banbatakumi/AutonomousCar/Program/MainF446RE_V3/docs/PROGRESS.md

# PROGRESS

## 2026-08-08: ステアリングストールによる駆動電圧崩壊

### 現象 (Pi側ログより)
mode=DISARM, target_steer=0 を送信中に発生。

| t[s]  | 駆動V | ST電流 | 舵角rad  | 指令rad | フラグ |
|---|---|---|---|---|---|
| 111.0 | 9.60  | +0.00  | -0.3782  | +0.0000 | 正常 |
| 111.9 | 2.80  | +2.83  | -0.3766  | +0.0000 | 電流発生→電圧崩壊 |
| 112.9 | 1.80  | +2.83  | -0.3766  | +0.0000 | 駆動低電圧 |
| 115.0 | 1.60  | +2.83  | -0.3766  | +0.0000 | 駆動低電圧(以降張り付き) |

- 実舵角が指令(0)から約21.6°ずれたまま動かず、ステア電流2.83Aが流れ続ける = ストール。
- `POWER_FAULT_DRIVE_OVERCURRENT` はラッチされず。
- `batt_current_drive` (STM32側バッテリー電流センサ) は終始0.00A。
- 前日の別セッションでは原点ズレが +0.392 rad (+22.4°) で符号が逆だった → 電源投入毎に原点がズレている。

### コード調査結果 (このリポジトリ側)

1. **DISARM中もステアは位置制御され続ける (未実装の穴)**
   [app.c:433-434](../src/app/app.c#L433-L434) `ApplyRasCommand()` は `armed` に関係なく毎周期
   `Steering_SetRoadWheelAngleRad()` を呼ぶ。`Drive` は `Drive_Enable`/`Drive_Disable` で
   明確にON/OFFされる ([app.c:430-431](../src/app/app.c#L430-L431)) のに対し、Steering には
   対応する無効化機構がない。位置モードのMDは目標角へ向けて連続的にトルクを掛け続けるため、
   DISARM中でも中心点(target=0)へ向けて突っ張り続ける。ストール検出・電流タイムアウトも無し。
   → **仕様ではなく未実装。要修正候補。**

2. **駆動電流センサが0Aに張り付く件**
   [power.c:180-183](../src/power/power.c#L180-L183) の `Power_GetCurrentDrive()` は
   ADC1 CURRENT_P (PC1, INA180A2 + R28=5mΩ) 1系統で DRIVE_POWER 配下の3台のMD
   (操舵+左右後輪) の合算電流を読む設計。ステアMDが2.83A流しているなら本来反映されるはず。
   - ハード側 (シャント未実装/配線/ADCチャンネル) の可能性
   - Piログの「駆動電流」がMD自身のテレメトリ (`motor_current_a[0]`) を指しており、
     STM32側センサ値と別物として比較していた可能性
   → 実機でテスターを当てて切り分けが必要。

3. **過電流ラッチ不発は (2) の帰結**
   [power.c:120-124](../src/power/power.c#L120-L124) は `Power_GetCurrentDrive() > 9.0A` を
   50ms継続で判定するが、センサ値が常に0Aなら判定に掛からない。センサが機能していないなら
   駆動系過電流保護は事実上無効。

4. **原点が起動毎に変わる件**
   [steering.c:56-68](../src/control/steering.c#L56-L68) `Steering_Init` は起動時に
   BUTTON1 が押されていればその場の角度をそのまま中心点として保存、押されていなければ
   Flashの保存値を読む仕様 ([app.c:536](../src/app/app.c#L536))。Flash値は明示的に
   再キャリブレーションしない限り変わらないため、毎回符号・大きさが変わるのは
   - 起動毎に意図せずBUTTON1がONでキャリブレーションが走っている
   - モータ〜リンク機構間のカプラがストール反力でスリップしている (今回の現象と整合的)
   のどちらかを疑う。

### 未確認・要現物確認
- ステアリングは手で動くか (機械的に噛んでいないか)
- カプラ/リンク機構のスリップ有無
- CURRENT_P (PC1) 周りのシャント実装・配線
- BUTTON1 (PB14) が起動時に意図せずONになる配線/固着がないか

### 対応候補 (未着手)
- Steering にも Drive 同様の Enable/Disable (非armed時はトルク上限0 or MD解放) を追加
- ステアのストール検出 (角度偏差が一定時間収束しない場合にトルクを下げる/フォールト化)

### 続報: 「なぜ駆動電源が切れるのか」の調査 (同日)

Pi側から「一度もarmしていないのに9.6Vから電圧が落ちた。省電力OFFの類はあるか」との質問。
DRIVE_POWER を操作する箇所を全て洗い出した結果、**タイムアウトによる自動OFFはこのファーム
には存在しない**ことを確認。

- [app.c:571](../src/app/app.c#L571) `Setup()` 末尾で無条件に ON (armの有無に無関係)。
- [app.c:403](../src/app/app.c#L403) `ApplyRasCommand()` で `arm_requested` に従い上書き。
  ただしこれは `RasLink_IsCommandAlive()` が真の間 (Piから100ms間隔でCOMMANDが届き続けて
  いる間) しか呼ばれない ([app.c:498](../src/app/app.c#L498))。
- 他にOFFにする経路は過電流ラッチのみ (今回未発生)。

**「一度もarmしていない」のに9.6Vが観測できたことの整合性**が課題として残る。2通りの
可能性を提示し、Pi側の確認待ち:

1. **COMMANDを一度も送っていなかった場合**: `has_command` が false のまま
   `UpdateDriveTest()` 分岐 ([app.c:504](../src/app/app.c#L504)) が動き続け、DRIVE_POWERは
   `Setup()` のONが保持される。この分岐はBUTTON1起点の下位単独走行テストで、カウントダウン後に
   `Steering_SetAngleRad(&steering, 0.0f)` と `Drive_SetTargetSpeed()` を実際に発行する
   ([app.c:205-207](../src/app/app.c#L205-L207))。ログの「指令rad=0.0000」がPiのCOMMANDでは
   なく**本体BUTTON1起点の走行テストの指令値**だった疑いがある。
2. **COMMANDを継続送信していた場合 (armなし)**: 初回COMMAND到達時点で即座にOFFになるはずで
   9.6V観測と矛盾する。VOLTAGE_P (PC3) がDRIVE_POWERスイッチより手前 (常時通電の生電圧) を
   測っている回路だとすれば、電圧低下は電源OFFではなく「ステアのストールによるバッテリー
   サグ」単体の現象として説明できる。要回路図確認。

Pi側に確認を依頼した項目:
- flags の mode ビット(bit0-1) と `RAS_FLAG_ARMED` (bit2) の実際の値
- BUTTON1 (LED1点灯) が押された形跡の有無
- COMMANDパケットが実際に送信されていたか (Pi側送信ログ)
- VOLTAGE_P (PC3) のタップ位置 (DRIVE_POWERスイッチの前/後)

### 結論 (同日、Pi側ログ解析で決着): バグではなく仕様どおりの挙動

Pi側の送受信ログを解析した結果、原因が確定した。

- COMMAND は 89.7Hz で継続送信されており、`arm` ビットは終始 `0`。100ms超の途絶は0回
  (`RasLink_IsCommandAlive()` は常に真)。
- 初COMMAND受信 (Pi時刻 0.001s) から **+13ms** で駆動電圧の崩壊が始まった。
- STM32は起動から約50秒間、Piが何も送ってこない間 `Setup()` のDRIVE_POWER=ONを保持していた。
  最初のCOMMANDが届いた瞬間、[app.c:403](../src/app/app.c#L403) が
  `Power_SetDrivePower(&power, arm_requested=false)` を実行し、そのままOFFになった。
- VOLTAGE_P (PC3) は **DRIVE_POWERスイッチの後ろ**を測っていると確定 (スイッチが開いた
  瞬間に電圧が落ちているため)。9.6V→1.6Vの「崩壊」はステア電流によるサグではなく、
  スイッチが切れた後のコンデンサ放電波形。

**過去の誤った推測を訂正:**
1. 「駆動バッテリー未接続」→ 誤り。常時接続されていたが、DISARM (arm=0) のCOMMANDで
   DRIVE_POWERがOFFになっていただけ。
2. 「ステアがストール」→ 誤り。ST電流は0.91Aで一定、急増なし。
3. 「電流センサが効いていない」→ 根拠不足。スイッチがOFFなら0.00Aが正しい値。

上記PROGRESSの2/3/4節の「駆動電流センサ異常」「ステアストール」に関する分析は本件の
原因ではなかったとして無効化する。ただし **1節(DISARM中もSteeringが位置制御され続ける
設計上の穴)自体はコード上の事実として引き続き有効**(未検証・未修正のまま)。

**設計上の含意:** Piが接続していてもarmしていない間、DRIVE_POWERは必ずOFFになる
(安全側の正しい挙動)。そのためベンチで駆動電源を上げたまま監視だけしたい場合、
COMMANDを送るとその瞬間に切れる。Pi側で「COMMANDを送らずに受信だけする」ことでのみ
ONを維持できる (ただしその場合 `RAS_FLAG_UART_TIMEOUT` は出ないが `has_command=false`
のままなので上位連携としては未接続扱いになる点に注意)。

**検証実験で確認済み (Pi側):** COMMANDを一切送らず60秒受信のみ→駆動電圧11.00Vが微動
だにせず維持。VOLTAGE_P (PC3) が DRIVE_POWER スイッチの後ろにあることも確定。
MD配線・comm_okも正常(通信断は電源喪失の結果であり原因ではない)。本件は完全に決着。

### 派生した設計論点: フェイルセーフの向きが逆転している

Pi側から指摘。実際のflags推移:

| 状態 | flags |
|---|---|
| Pi沈黙中 (起動直後、COMMAND未着) | ARMED + 駆動電源 ON |
| Pi接続しDISARM送信 | 駆動電源 OFF |

**監視者(Pi)がいないときの方が「動ける」状態になっている。** 原因は
[app.c:571](../src/app/app.c#L571) の `Setup()` 末尾で無条件にDRIVE_POWERをONにする
設計 (BUTTON1単独走行テストをPi無しでも動かすための意図的な設計、CLAUDE.mdにも
明記されている過去の決定)。`UpdateDriveTest()` 自身は `Power_SetDrivePower()` を
一度も呼んでおらず、Setup()のONに乗っかっているだけ ([app.c:179-232](../src/app/app.c#L179-L232)
には呼び出し無し)。

Pi統合が主運用になった今、「監視者不在=動ける」は fail-open であり、一般的な
フェイルセーフの向き (監視者不在・信号無し=安全側) と逆。

**対応 (実施済み):** バンビの判断で、ボタン1単体走行テスト (`UpdateDriveTest` および
関連の `StopTest`/`IsButton1Pressed`/`TestState` 一式) を [app.c](../src/app/app.c) から
削除。あわせて `Setup()` 末尾の `Power_SetDrivePower(&power, 1)` 無条件ONも撤廃し、
以下の挙動に変更した:

- `Setup()` 中はステアリング原点較正 (MDとの通信が必要) のためだけに一時的に
  DRIVE_POWER をONにし、`Steering_Init()`/`Drive_Init()` の直後に明示的にOFFへ戻す。
- 以降は `ApplyRasCommand()` が上位の `RAS_CMD_FLAG_ARM` 要求に従ってON/OFFする経路のみ。
- `UpdateVehicleControl()` の「COMMAND未受信」「COMMAND途絶」の2分岐を
  `ApplyCommandTimeout()` に統合。上位と繋がっていない間は常に目標車速0で停車保持。

結果、Pi未接続時のflagsは `ARMED=False` になり、fail-openは解消。`make` でビルド確認済み
(エラー・警告なし)。CLAUDE.mdの `src/app/app.c の状態` 節も合わせて更新。

---

## 2026-08-08: GUI の LiDAR 点群が左右反転 → Pi 側で修正 (STM32 側は変更なし)

### 原因

STM32 は「センサ基準の角度をそのまま送り、左右の解釈は上位で行う」設計
([lidar.h](../src/sensing/lidar.h) のモジュール解説に経緯あり)。LD06 を裏向き
(PCB面が下) に取り付けているため角度の増加方向が車両座標と逆で、
`sector_idx * 30 + i` をそのまま度として使うと点群が左右反転する。

Pi 側 (`AutonomousCar_RasPi/surge_mk2/raspi/msgs/convert.py` の `ScanAssembler`) が
この反転を実装しておらず、生の添字のまま 360点配列へ詰めていたのが直接原因。

### 対応 (Pi 側で実施済み)

`ScanAssembler` の1箇所だけで `車両角 = (360 - センサ角) % 360` に変換する。

- `sector_t_ns` / `sector_dur_us` / `sector_seen` も車両座標のセクタ番号
  `11 - sector_idx` へ移動 (GUI の欠測セクタ表示が点群とずれないように)
- 反転でセクタ内の時刻の向きが逆になる (`t[j] = t_start + dur * (29 - j) / 29`)
- 回帰テスト追加。Pi 側テスト 259件 OK、GUI の `tsc --noEmit` も通過
- ドキュメント更新: Pi 側 `uart_protocol.md` §5.1 / `stm32_interface.md` §7.1 /
  `types.py` / `gui/src/types.ts` / `PROGRESS.md`

**ワイヤ形式・`protocol_version` (0x0004) は無変更。このリポジトリのコード変更は不要。**
STM32 側で反転しない理由 (0°/180° がセクタ境界に乗って1セクタが分裂する、
実際に試すと原因不明の通信エラーが増発する) は [lidar.h](../src/sensing/lidar.h) のまま有効。

---

## 2026-08-09: プロトコル v0.5 — 灯火/パッシング/クラクション/ブレーキ強さの操作を追加

Pi 側 GUI からクラクション・パッシング・灯火切替 (OFF/DAYTIME/NORMAL) を操作できるようにし、
ブレーキを on/off ではなく N・m で指定できるようにした。詳細と Pi 側の対応チェックリストは
[pi_uart_protocol_v0.5_delta.md](pi_uart_protocol_v0.5_delta.md)。

### 変更点

- **`COMMAND` (0x10) の LEN 10 → 12**、`protocol_version` 0x0004 → 0x0005。
  末尾に `brake_torque : u16` (0.0001 N·m/LSB、0 = 未指定 → 最大制動) を追加。
  `flags` は bit3 の1ビット `light` を bit3-4 の2ビット `light_mode` に拡張し、bit5 に
  `passing` を新設。**Pi 側を更新するまで走行指令は LEN 不一致で全て破棄される** (意図的)。
- **ブレーキが車速PIを迂回するようになった** (`Drive_SetBrake`)。従来は目標車速0を与えるだけで
  制動力がPIゲイン任せだったため、N・m で指定した強さどおりに効かなかった。
- **クラクションが「押している間だけ鳴る」に変更** (連続トーン。従来は立ち上がりで300msの単発)。
- **緊急停止・COMMAND 途絶時の処置を `ApplyFailsafe()` に統合**し、最大制動トルクで止めるように
  した (従来は目標車速0のみ)。併せてクラクションとパッシングを強制解除する。
- **`torque_cmd` の符号規約を明文化**: 正=駆動、負=制動。停車保持中も制動トルクを負値で報告する
  ようになった (従来は0で、押さえているのか無出力なのか区別できなかった)。

### 起動時に駆動電源が一瞬 ON になる問題を修正

`Setup()` が毎回ステアリング原点処理の前後で `DRIVE_POWER` を ON→OFF していた。MD との通信が
要るのは**ボタン1を押しながら起動して較正するときだけ**で、通常起動は Flash から読むだけなので
給電は不要。`if (calibrate_steering)` で囲い、較正しない起動では一度も投入しないようにした。
`TELEMETRY.flags` bit2 (`armed`) が起動直後に一瞬立つこともなくなる。

ビルド確認済み (`make -j12`、エラー・警告なし。text 72204 B)。**実機での動作確認は未実施。**

---

## 2026-08-10: app.c の分割リファクタリング

`src/app/app.c` (585行) に、初期化・メインループ・上位指令の適用・緊急停止・テレメトリ組み立て・
状態表示が全部同居していたので、責務ごとに分割した。**機能の変更は無く、処理内容と実行順序は
そのまま移設しただけ**。

### 新設したモジュール

| 追加先 | 役割 | app.c から移したもの |
|---|---|---|
| `src/vehicle/vehicle.{h,c}` | 車両統括。上位指令・緊急停止・フェイルセーフのどれを適用するかの調停と、指令のレート制限 | `ApplyRasCommand` / `ApplyFailsafe` / `UpdateEstop` / `UpdateVehicleControl` / `SetHorn` / `HeadlightModeFromCommand` / `applied_speed_m_s` / `applied_steer_rad` / `vehicle_mode` / `estop_latched` |
| `src/comm/telemetry.{h,c}` | 各モジュールの観測量を TELEMETRY / STATS / LIDAR_SECTOR のフィールドへ詰め替える | `PublishTelemetry` / `BuildTelemetryFlags` / `BuildMdStatus` / `AccumAngleToOdom` / `PublishLidarSector` / `MdCommWatch` 一式 / `MotorByIndex` |
| `src/hmi/indicator.{h,c}` | 機体状態の表示 (電圧の呼吸 LED、フォールト・緊急停止のハザード) | `BreathLed` 一式 / `UpdatePowerIndication` / `UpdateFaultIndication` |

### 残した app.c の役割

コンポジションルート (全インスタンスの所有・初期化順序・メインループの呼び出し順・HAL 割り込み
コールバックの振り分け) だけ。585行 → 244行。

- グローバルだったインスタンスを全て `static` にした (他モジュールへは `*_Init()` でポインタを渡す)。
- `app.h` が 20 個のヘッダを include して `Core/Src/main.c` まで引きずっていたのをやめ、
  `Setup()` / `MainApp()` の宣言だけにした。
- 起動演出 (ハザード2回点滅) を `PlayStartupIndication()`、センサ更新群を `UpdateSensors()` に括り出し。

### 依存の向き

`app → vehicle / hmi / comm → control / sensing / power / lighting → lib` の一方向。
テレメトリは車両状態 (mode / estop / 指令舵角) を `Vehicle_Get*()` 経由で読み、Indicator へは
app.c が `Vehicle_IsEstopLatched()` の結果を引数で渡すことで循環依存を避けている。

### その他

- 空ディレクトリ `src/sound/` を削除 (`-Isrc/sound` が付くだけの残骸だった)。

ビルド確認済み (`make clean && make -j12`、エラー・警告なし。text 72500 B)。**実機での動作確認は未実施。**

---

## 2026-08-11: プロトコル v0.6 — 駆動トルクの直接指令 (`torque_mode`) を追加

Pi 側 (`stm32_interface.md` v0.5 / `uart_protocol.md` v0.6) の要求に合わせ、後輪へ駆動トルクを
直接指令できるモードを追加した。詳細と Pi 側の対応チェックリストは
[pi_uart_protocol_v0.6_delta.md](pi_uart_protocol_v0.6_delta.md)。

### 変更点

- **`COMMAND` (0x10) の LEN 12 → 14**、`protocol_version` 0x0005 → 0x0006。
  末尾に `target_torque : i16` (0.0001 N·m/LSB、負=後退方向) を追加。`flags` bit6 に
  `torque_mode` を新設。**Pi 側を更新するまで走行指令は LEN 不一致で全て破棄される** (意図的)。
- **`torque_mode` 中は `Drive` が車速 PI を迂回し、`target_torque` を左右等配分の総駆動トルクとして
  直接使う** ([drive.c](../src/control/drive.c) `Drive_SetTorque` / `Drive_Update`)。
  `brake` と同じ構造で `PID_Reset` を毎周期呼び、離脱時に積分の持ち越しが起きないようにした。
- **TC/TV は `torque_mode` 中も掛けたままにした** (`uart_protocol.md` §14 #8 で「未確定」とされていた
  論点への回答)。通常駆動時と同じ TC リミッタ・TV のヨーモーメント項の計算経路をそのまま通し、
  車速 PI の出力の代わりに `target_torque * 2` を「要求総トルク」として渡すだけにしている。
  空転を招くおそれのある「TC を素通りさせる」実装は避けた。
- **`brake` と `torque_mode` が同時に立っていたら `brake` を優先**する。`Drive_Update` 側で
  `brake_active` を先に判定する既存の優先順位にそのまま乗せているだけで、`Vehicle` 側では
  両フラグを毎周期そのまま `Drive_SetBrake` / `Drive_SetTorque` へ渡している (どちらが勝つかは
  常に `Drive_Update` の1箇所だけで決まる)。
- **`target_torque` は ±`DRIVE_MAX_TORQUE_NM` (0.1 N·m) でこちら側でもクランプする**
  (`Drive_SetTorque` 内)。Pi 側のクランプに頼らない。

ビルド確認済み (`make -j12`、エラー・警告なし。text 74832 B)。**実機での動作確認は未実施。**

---

## 2026-08-19: プロトコル v0.8 — TC/TV の実行時 ON/OFF を追加

バンビの依頼「ラズパイ側からTCとTVのオンオフを制御したい」に対応。詳細と Pi 側の対応
チェックリストは [pi_uart_protocol_v0.8_delta.md](pi_uart_protocol_v0.8_delta.md)。

### 方式の選定

`COMMAND.flags` は v0.7 の `auto_stop` (bit7) 追加で u8 の全ビットが埋まっており、新しい
フラグを置く空きが無い。一方 `RasParamId` (`ras_link.h`) には TC/TV 用の `param_id`
(`0x0010`/`0x0020`) が「未実装」として既に予約されていたため、`COMMAND` の LEN 拡張は
避けて既存の `CONFIG_SET`/`CONFIG_GET`/`CONFIG_ACK` (0x20/0x21/0x22) 経由で実装した。

### 変更点

- **`RasParamId` に `RAS_PARAM_TC_ENABLE = 0x0010` / `RAS_PARAM_TV_ENABLE = 0x0020` を追加**
  ([ras_link.h](../src/comm/ras_link.h))。`RasConfig` に `tc_enabled`/`tv_enabled` (既定 true)
  を追加し、`ApplyConfig()`/`ReadConfig()` ([ras_link.c](../src/comm/ras_link.c)) で
  0.0/非0 を真偽値として読み書きする。`protocol_version` 0x0007 → 0x0008。
- **TV は元々 `TorqueVectoring_SetEnabled()`/`Drive_SetTorqueVectoringEnabled()` が実装済み
  だったが呼び出し元がどこにも無く、実質常時有効固定だった** (未配線)。今回
  `Vehicle::ApplyRasCommand()` ([vehicle.c](../src/vehicle/vehicle.c)) から配線した。
- **TC には有効/無効の切替口が無かったため新規追加**: `Drive` に `tc_enabled` (既定 true) を
  持たせ、`Drive_Update()` の TC 上限更新箇所を分岐し、無効時は `tc_limit_left/right_nm` を
  常に `DRIVE_MAX_TORQUE_NM` に固定してスリップ率による削り込みをしないようにした
  ([drive.h](../src/control/drive.h)/[drive.c](../src/control/drive.c) の
  `Drive_SetTractionControlEnabled()`)。
- `Vehicle::ApplyRasCommand()` が毎周期 `RasConfig.tc_enabled`/`tv_enabled` を
  `Drive_SetTractionControlEnabled()`/`Drive_SetTorqueVectoringEnabled()` へそのまま渡す。
  COMMAND 未受信時 (`ApplyFailsafe()`) は呼ばないため、Pi 未接続時は起動時の既定値 (両方有効)
  のまま固定される。

ビルド確認済み (`make -j12`、エラー・警告なし。text 75656 B)。**実機での動作確認は未実施。**
