banbatakumi/AutonomousCar/Program/MainF446RE_V3/docs/archive/pi_uart_protocol_v0.15_delta.md

# SURGE Mark.2 UART プロトコル — v0.14 → v0.15 差分

**発信**: STM32F446RE 車両制御基板 (MainF446RE_V3) 開発側
**宛先**: Raspberry Pi 5 側 開発担当
**日付**: 2026-09-27
**状態**: STM32 側 実装済み・ビルド確認済み。**Pi 側の対応が必要 (実機での動作検証は未了)**

v0.14 (`pi_uart_protocol_v0.14_delta.md`) からの差分のみを記す。変わったのは `CONFIG_SET`/
`CONFIG_GET` の `param_id` 追加と `TELEMETRY` (0x02) の `flags` の空きビットのみ。**ワイヤ形式・
LEN の変更は無い**。

---

## 0. 要約

制動時の後輪ロックを防ぐ ABS を追加した。`COMMAND.flags` の `brake` (上位のブレーキ・自動停止)
と、STM32 側のフェイルセーフ (`COMMAND` 途絶・緊急停止) の最大制動のすべてに掛かる。
車速PIによる減速・`torque_mode` の負トルクには掛からない。

- 前輪 (非駆動・非制動) から求めた基準車速に対し、後輪のスリップ率が -0.2 より負になったら
  そのときの制動トルクを覚えて0.7倍へ下げ (25ms 戻らなければもう一段)、スリップが -0.1 より
  浅く戻ったら覚えたトルクの0.9倍へすぐ戻し、そこから 0.2 Nm/s でゆっくり上げる
  (2026-09-27 の実機試験を受けて改訂。初版は削りすぎて減速が弱かった。ワイヤ形式は同じ)。
- 左右は select-low (ロックしかけている側に合わせて左右同じ制動トルク)。左右で路面μが違っても
  ヨーモーメントを出さないため。
- 車速 0.25 m/s 未満では働かない (スリップ率が定義できないため)。
- **フォールバック**: 制動トルクを要求の20%以下に削った状態が 0.1 s 続いたら (最大制動からだと約0.2 s)、前輪側の
  センサ異常とみなし、ブレーキを離すまで ABS を止めて要求どおりに制動する。

**`protocol_version` は `0x000E` → `0x000F` に上がる。`COMMAND`・`TELEMETRY` とも LEN は
変わらない。**

---

## 1. `CONFIG_SET` / `CONFIG_GET` — `param_id = 0x0070` (ABS_ENABLE) 追加

| param_id | 名前 | 値 | 既定 |
|---|---|---|---|
| `0x0070` | `ABS_ENABLE` | 0.0 = 無効、非0 = 有効 (適用値は 0.0/1.0 で返る) | 有効 |

- TC (`0x0010`)・片輪浮き対策 (`0x0050`) と同じ扱い。無効にすると、指定した制動トルクを
  そのまま掛ける (v0.14 までの挙動)。
- 制動中に無効→有効へ切り替えると、ABS の内部状態 (フォールバックも含む) は初期化される。

## 2. `TELEMETRY` (0x02) — `flags` (bit20) 追加

| bit | 内容 |
|---|---|
| 19 | `WINKER_RIGHT_ACTIVE` (既存, v0.14) |
| 20 | `ABS_ACTIVE` (新設) |

- ABS が制動トルクを要求より削っている最中かどうか。フォールバック中は偽。
- 実際に掛けている制動トルクは既存の `torque_cmd[2]` (制動は負値)、スリップ率は既存の
  `slip[2]` に出るので、チューニングにはこの2つとこのビットを使う。

---

## 3. Pi 側の対応チェックリスト

- [ ] `protocol_version` の期待値を `0x000E` → `0x000F` にする
- [ ] (任意) `CONFIG_SET` の `param_id = 0x0070` で ABS の ON/OFF を切り替えられるようにする
- [ ] `TELEMETRY.flags` の bit20 (`ABS_ACTIVE`) をデコードしてログ・UI に出す
- [ ] **実機での動作検証は STM32 側でも未実施。** しきい値・ゲイン・フォールバック時間は
      すべて机上値なので、滑りやすい路面で ON/OFF を比較しながら詰める想定
