banbatakumi/AutonomousCar/Circuit/MainBoard_V3_2/MainBoardPCB.dxf

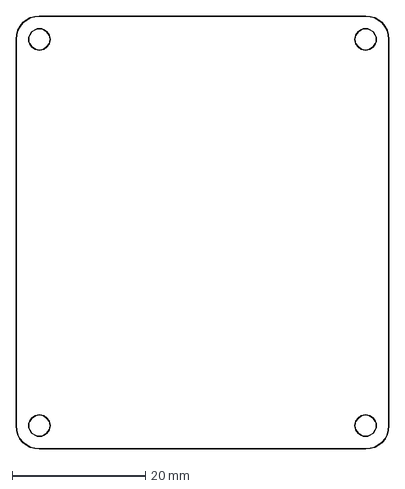
[picture p1: CAD file, 2026-05-05]
Circuit/MainBoard_V3_2/MainBoardPCB.dxf
56.0 x 65.0 mm
