banbatakumi/AutonomousCar/Circuit/MainBoard_V3_2/OKL-T_6-W12N-C.step

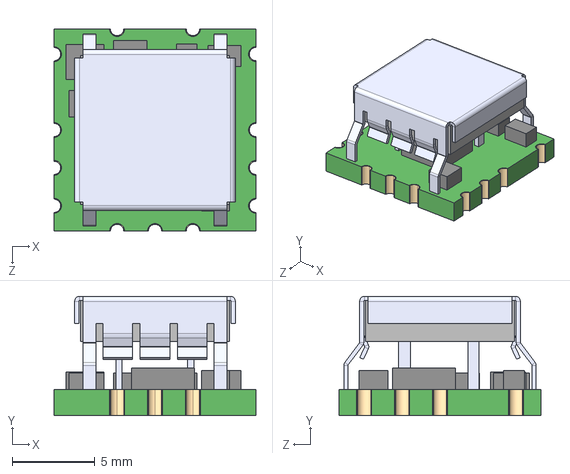
[picture p2: CAD file, 2026-05-05]
Circuit/MainBoard_V3_2/OKL-T_6-W12N-C.step
12.2 x 7.20 x 12.2 mm
