banbatakumi/AutonomousCar/Circuit/MainBoard_V3_2/MainBoard_V3_2.kicad_pcb

## KiCad design Circuit/MainBoard_V3_2/MainBoard_V3_2.kicad_pcb (2026-07-30)

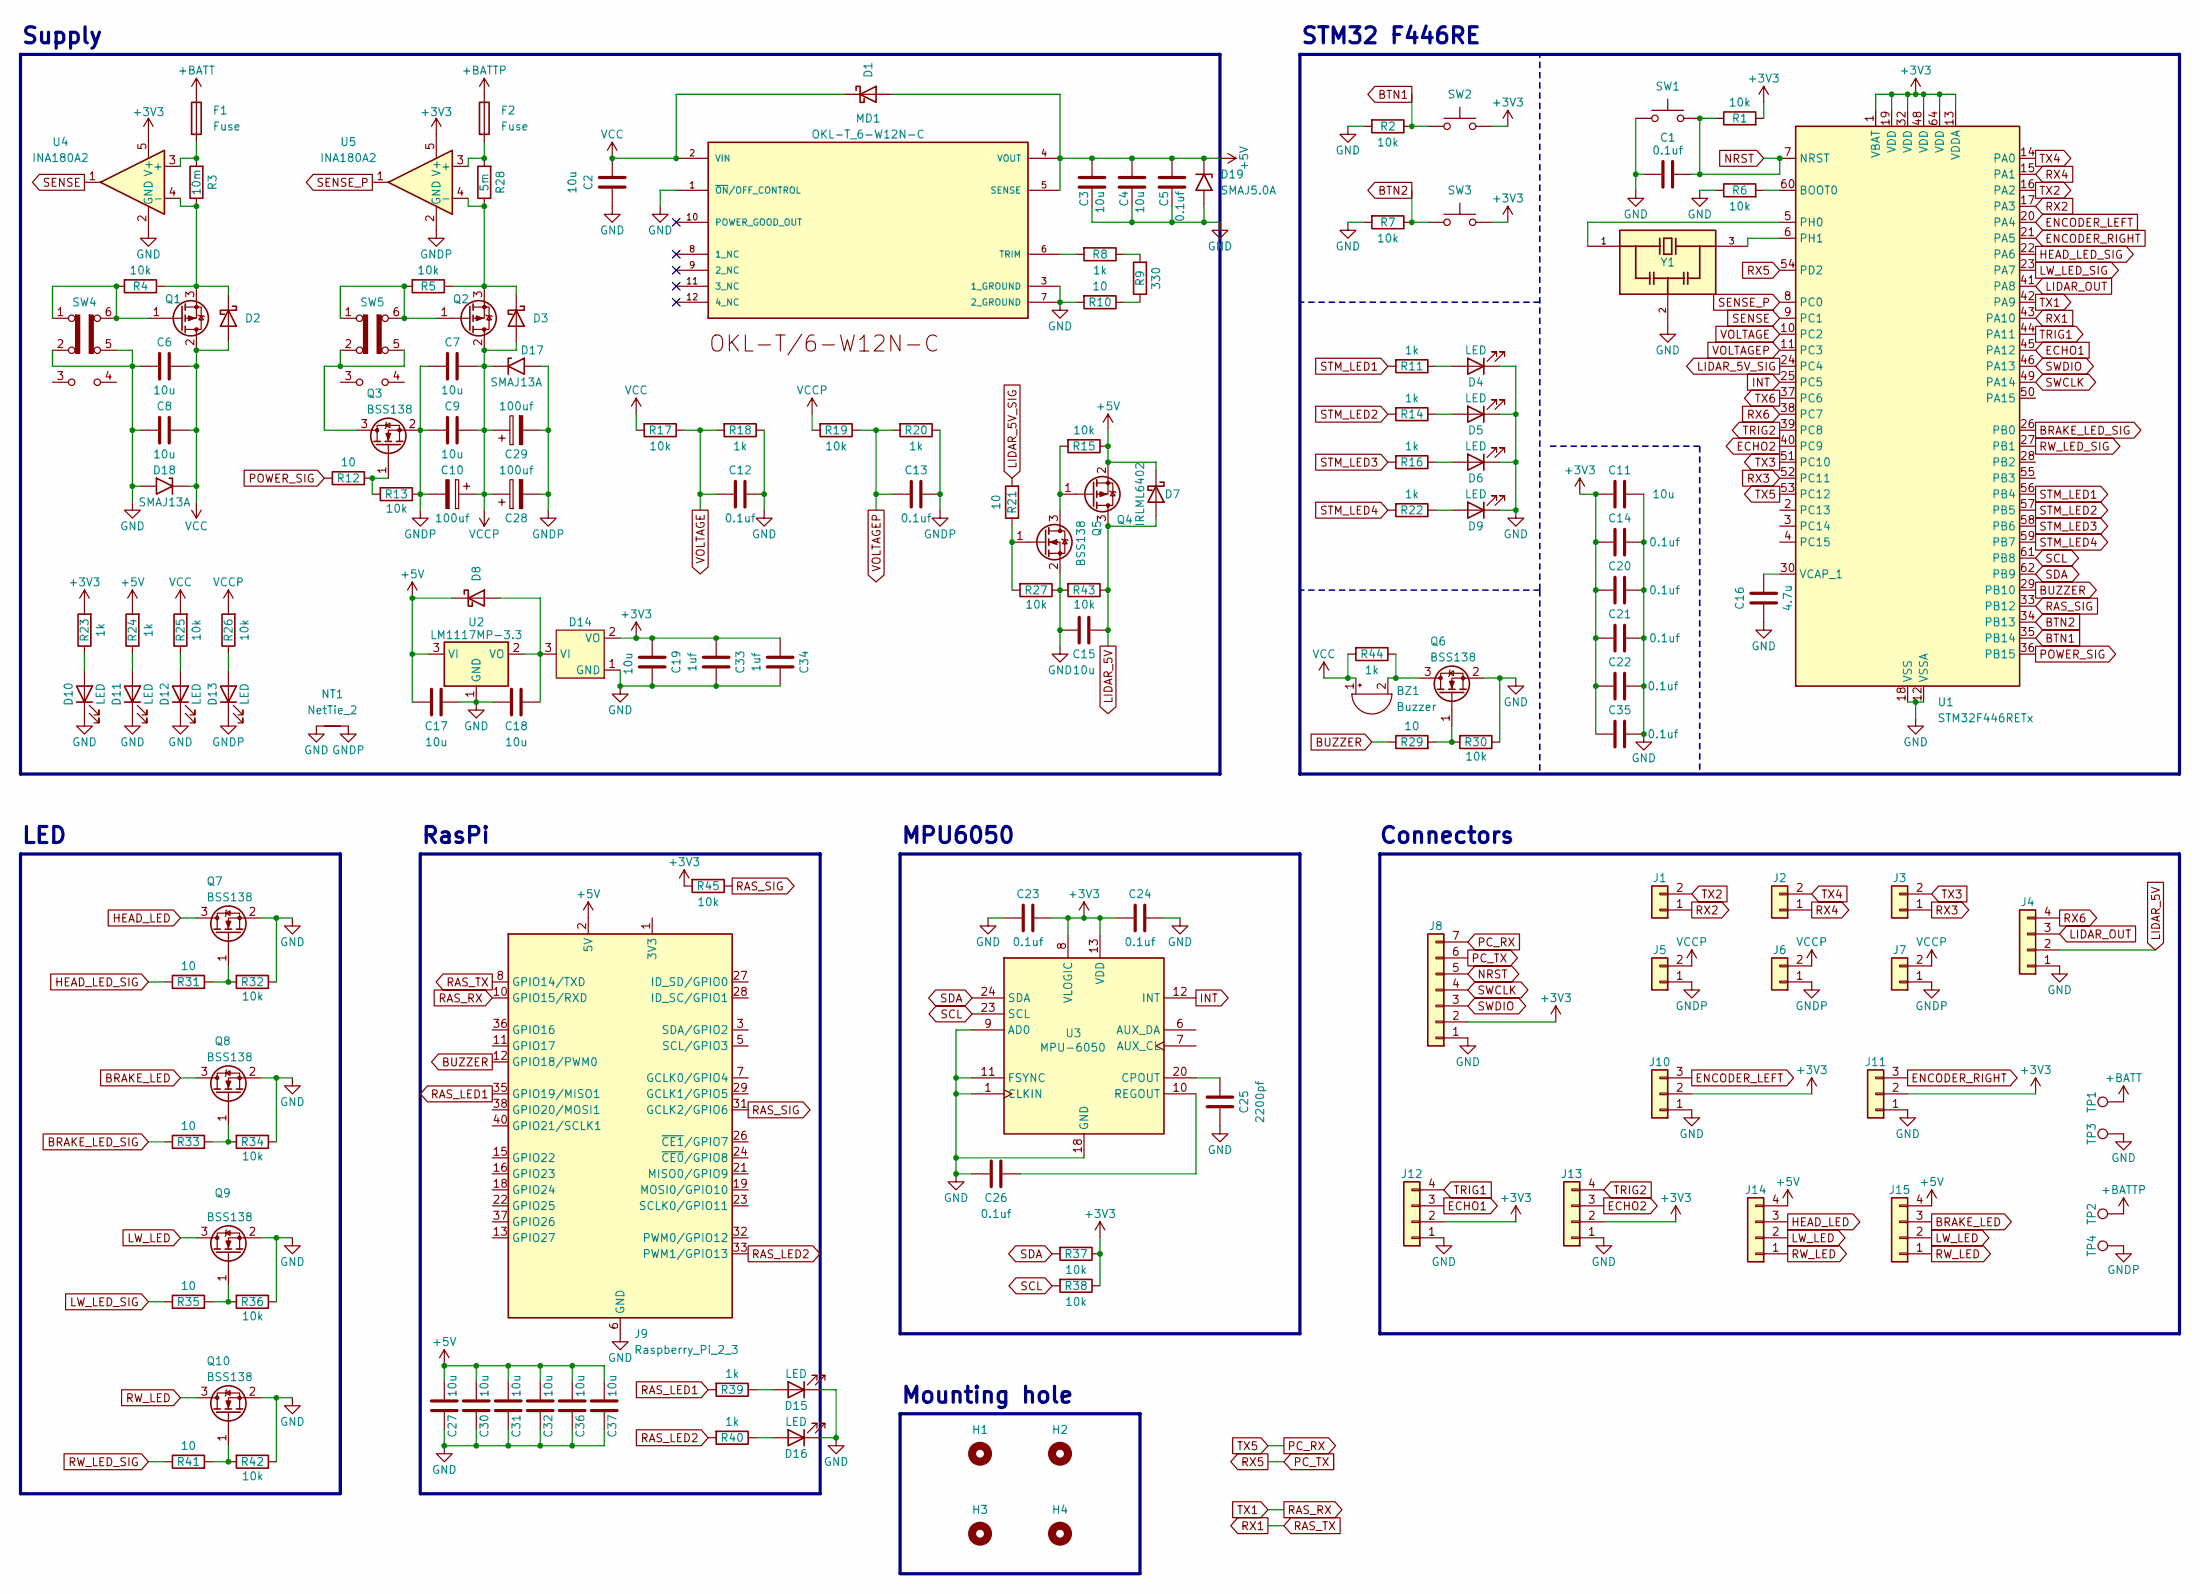
[picture p3: schematic MainBoard_V3_2.kicad_sch]

Parts:
BZ1: Buzzer; Buzzer_Murata_PKLCS1212E
C1, C5, C12, C13, C14, C20, C21, C22, C23, C24, C26, C35: 0.1uf; C_0603_1608Metric
C2, C3, C4, C6, C7, C8, C9, C11, C15, C17, C18, C19, C27, C30, C31, C32, C36, C37: 10u; C_0805_2012Metric
C10, C28, C29: 100uf; CP_Radial_D6.3mm_P2.50mm
C16: 4.7u; C_0805_2012Metric
C25: 2200pf; C_0603_1608Metric
C33, C34: 1uf; C_0603_1608Metric
D1, D2, D3, D7, D8: D_Schottky; D_SOD-323_HandSoldering
D4, D5, D6, D9, D10, D11, D12, D13, D15, D16: LED; LED_0603_1608Metric
D14: CH213K; TSOT-23
D17, D18: SMAJ13A; D_SMA
D19: SMAJ5.0A; D_SMA
F1, F2: Fuse; Fuseholder_Clip-5x20mm_Keystone_3517_Inline_P23.11x6.76mm_D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
H1, H2, H3, H4: MountingHole; MountingHole_3.2mm_M3_Pad_Via
J1, J2, J3: Conn_01x02; JST_PH_S2B-PH-K_1x02_P2.00mm_Horizontal
J4, J12, J13: Conn_01x04; JST_XH_S4B-XH-A_1x04_P2.50mm_Horizontal
J5, J6, J7: Conn_01x02; Molex_SPOX_5268-02A_1x02_P2.50mm_Horizontal
J8: Conn_01x07; JST_PH_S7B-PH-K_1x07_P2.00mm_Horizontal
J9: Raspberry_Pi_2_3; raspberreyPi
J10, J11: Conn_01x03; JST_PH_S3B-PH-K_1x03_P2.00mm_Horizontal
J14, J15: Conn_01x04; JST_PH_S4B-PH-K_1x04_P2.00mm_Horizontal
MD1: OKL-T_6-W12N-C; MURATA_OKL-T-6-W12N-C_0; MOUSER_PART_NUMBER 580-OKL-T/6-W12N-C; MOUSER_DESCRIPTION Non-Isolated DC/DC Converters 12Vin .59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
NT1: NetTie_2; NetTie-2_SMD_Pad0.5mm
Q1, Q2: Q_PMOS_GDS; TO-252-2
Q3, Q5, Q6, Q7, Q8, Q9, Q10: BSS138; SOT-23
Q4: IRLML6402; SOT-23
R1, R2, R4, R5, R6, R7, R13, R15, R17, R19, R25, R26, R27, R30, R32, R34, R36, R37, R38, R42, R43, R45: 10k; R_0603_1608Metric
R3: 10m; R_1206_3216Metric
R8, R11, R14, R16, R18, R20, R22, R23, R24, R39, R40, R44: 1k; R_0603_1608Metric
R9: 330; R_0603_1608Metric
R10, R12, R21, R29, R31, R33, R35, R41: 10; R_0603_1608Metric
R28: 5m; R_1206_3216Metric
SW1, SW2, SW3: SW_Push; SW_SPST_PTS810
SW4, SW5: SW_Slide_DPDT; IS-2235
TP1, TP2, TP3, TP4: TestPoint; TestPoint_THTPad_D4.0mm_Drill2.0mm
U1: STM32F446RETx; LQFP-64_10x10mm_P0.5mm
U2: LM1117MP-3.3; SOT-223-3_TabPin2
U3: MPU-6050; QFN-24-1EP_4x4mm_P0.5mm_EP2.15x2.15mm
U4, U5: INA180A2; SOT-23-5
Y1: CSTNE16M0V530000R0; Resonator_SMD_Murata_CSTxExxV-3Pin_3.0x1.1mm; PARTREV JGC42-8853B

Connections:
+3V3: C11.1, C14.2, C19.2, C20.2, C21.2, C22.2, C23.1, C24.2, C33.2, C34.2, C35.2, D14.2 (VO), J8.2, J10.2, J11.2, J12.2, J13.2, R1.2, R23.2, R37.1, R38.1, R45.2, SW2.2, SW3.2, U1.1 (VBAT), U1.13 (VDDA), U1.19 (VDD), U1.32 (VDD), U1.48 (VDD), U1.64 (VDD), U3.8 (VLOGIC), U3.13 (VDD), U4.5 (V+), U5.5 (V+)
+5V: C3.1, C4.1, C5.1, C17.2, C27.1, C30.1, C31.1, C32.1, C36.1, C37.1, D1.2 (A), D7.1 (K), D8.1 (K), D19.1 (A1), J9.2 (5V), J9.4 (5V), J14.4, J15.4, MD1.4 (VOUT), MD1.5 (SENSE), Q4.2 (S), R15.1, R24.2, U2.3 (VI)
+BATT: F1.1, TP1.1
+BATTP: F2.1, TP2.1
BRAKE_LED: J15.3, Q8.3 (D)
BRAKE_LED_SIG: R33.1, U1.26 (PB0)
BTN1: R2.1, SW2.1, U1.35 (PB14)
BTN2: R7.1, SW3.1, U1.34 (PB13)
BUZZER: J9.12 (GPIO18/PWM0), R29.1, U1.29 (PB10)
ECHO1: J12.3, U1.45 (PA12)
ECHO2: J13.3, U1.40 (PC9)
ENCODER_LEFT: J10.3, U1.20 (PA4)
ENCODER_RIGHT: J11.3, U1.21 (PA5)
GND: C1.1, C2.1, C3.2, C4.2, C5.2, C6.2, C8.2, C11.2, C12.1, C14.1, C15.2, C16.2, C17.1, C18.2, C19.1, C20.1, C21.1, C22.1, C23.2, C24.1, C25.2, C26.2, C27.2, C30.2, C31.2, C32.2, C33.1, C34.1, C35.1, C36.2, C37.2, D4.1 (K), D5.1 (K), D6.1 (K), D9.1 (K), D10.1 (K), D11.1 (K), D12.1 (K), D14.1 (GND), D15.1 (K), D16.1 (K), D18.2 (A2), D19.2 (A2), J4.1, J8.1, J9.6 (GND), J9.9 (GND), J9.14 (GND), J9.20 (GND), J9.25 (GND), J9.30 (GND), J9.34 (GND), J9.39 (GND), J10.1, J11.1, J12.1, J13.1, MD1.1 (~ON/OFF_CONTROL), MD1.3 (1_GROUND), MD1.7 (2_GROUND), NT1.1, Q5.2 (S), Q6.2 (S), Q7.2 (S), Q8.2 (S), Q9.2 (S), Q10.2 (S), R2.2, R6.1, R7.2, R10.2, R18.1, R27.1, R30.1, R32.1, R34.1, R36.1, R42.1, R43.2, SW1.1, SW4.2 (B), SW4.5 (B), TP3.1, U1.12 (VSSA), U1.18 (VSS), U1.31 (VSS), U1.47 (VSS), U1.63 (VSS), U2.1 (GND), U3.1 (CLKIN), U3.9 (AD0), U3.11 (FSYNC), U3.18 (GND), U4.2 (GND), Y1.2
GNDP: C7.1, C9.1, C10.2, C13.1, C28.2, C29.2, D13.1 (K), D17.2 (A2), J5.1, J6.1, J7.1, NT1.2, Q3.2 (S), R13.1, R20.1, TP4.1, U5.2 (GND)
HEAD_LED: J14.3, Q7.3 (D)
HEAD_LED_SIG: R31.1, U1.22 (PA6)
INT: U1.25 (PC5), U3.12 (INT)
LIDAR_5V: C15.1, D7.2 (A), J4.2, Q4.3 (D), R43.1
LIDAR_5V_SIG: R21.2, U1.24 (PC4)
LIDAR_OUT: J4.3, U1.41 (PA8)
LW_LED: J14.2, J15.2, Q9.3 (D)
LW_LED_SIG: R35.1, U1.23 (PA7)
NRST: C1.2, J8.5, R1.1, SW1.2, U1.7 (NRST)
unnamed: BZ1.2 (-), Q6.3 (D), R44.1
unnamed: D2.1 (K), Q1.3 (S), R3.1, R4.1, U4.4 (-)
unnamed: D3.1 (K), Q2.3 (S), R5.1, R28.1, U5.4 (-)
unnamed: D4.2 (A), R11.1
unnamed: D5.2 (A), R14.1
unnamed: D6.2 (A), R16.1
unnamed: D9.2 (A), R22.1
unnamed: D10.2 (A), R23.1
unnamed: D11.2 (A), R24.1
unnamed: D12.2 (A), R25.1
unnamed: D13.2 (A), R26.1
unnamed: C18.1, D8.2 (A), D14.3 (VI), U2.2 (VO)
unnamed: D15.2 (A), R39.1
unnamed: D16.2 (A), R40.1
unnamed: J9.1 (3V3), J9.17 (3V3)
unnamed: MD1.6 (TRIM), R8.2
unnamed: Q1.1 (G), R4.2, SW4.1 (A), SW4.6 (C)
unnamed: Q2.1 (G), R5.2, SW5.1 (A), SW5.6 (C)
unnamed: Q3.3 (D), SW5.2 (B), SW5.5 (B)
unnamed: Q3.1 (G), R12.2, R13.2
unnamed: Q4.1 (G), Q5.3 (D), R15.2
unnamed: Q5.1 (G), R21.1, R27.2
unnamed: Q6.1 (G), R29.2, R30.2
unnamed: Q7.1 (G), R31.2, R32.2
unnamed: Q8.1 (G), R33.2, R34.2
unnamed: Q9.1 (G), R35.2, R36.2
unnamed: Q10.1 (G), R41.2, R42.2
unnamed: R8.1, R9.2
unnamed: R9.1, R10.1
unnamed: R6.2, U1.60 (BOOT0)
unnamed: U1.5 (PH0), Y1.1
unnamed: U1.6 (PH1), Y1.3
unnamed: C16.1, U1.30 (VCAP_1)
unnamed: C25.1, U3.20 (CPOUT)
unnamed: C26.1, U3.10 (REGOUT)
unnamed: F1.2, R3.2, U4.3 (+)
unnamed: F2.2, R28.2, U5.3 (+)
PC_RX: J8.7, U1.53 (PC12)
PC_TX: J8.6, U1.54 (PD2)
POWER_SIG: R12.1, U1.36 (PB15)
RAS_LED1: J9.35 (GPIO19/MISO1), R39.2
RAS_LED2: J9.33 (PWM1/GPIO13), R40.2
RAS_RX: J9.10 (GPIO15/RXD), U1.42 (PA9)
RAS_SIG: J9.31 (GCLK2/GPIO6), R45.1, U1.33 (PB12)
RAS_TX: J9.8 (GPIO14/TXD), U1.43 (PA10)
RW_LED: J14.1, J15.1, Q10.3 (D)
RW_LED_SIG: R41.1, U1.27 (PB1)
RX2: J1.1, U1.17 (PA3)
RX3: J3.1, U1.52 (PC11)
RX4: J2.1, U1.15 (PA1)
RX6: J4.4, U1.38 (PC7)
SCL: R38.2, U1.61 (PB8), U3.23 (SCL)
SDA: R37.2, U1.62 (PB9), U3.24 (SDA)
SENSE: U1.9 (PC1), U4.1
SENSE_P: U1.8 (PC0), U5.1
STM_LED1: R11.2, U1.56 (PB4)
STM_LED2: R14.2, U1.57 (PB5)
STM_LED3: R16.2, U1.58 (PB6)
STM_LED4: R22.2, U1.59 (PB7)
SWCLK: J8.4, U1.49 (PA14)
SWDIO: J8.3, U1.46 (PA13)
TRIG1: J12.4, U1.44 (PA11)
TRIG2: J13.4, U1.39 (PC8)
TX2: J1.2, U1.16 (PA2)
TX3: J3.2, U1.51 (PC10)
TX4: J2.2, U1.14 (PA0)
TX6: U1.37 (PC6)
VCC: BZ1.1 (+), C2.2, C6.1, C8.1, D1.1 (K), D2.2 (A), D18.1 (A1), MD1.2 (VIN), Q1.2 (D), R17.2, R25.2, R44.2
VCCP: C7.2, C9.2, C10.1, C28.1, C29.1, D3.2 (A), D17.1 (A1), J5.2, J6.2, J7.2, Q2.2 (D), R19.2, R26.2
VOLTAGE: C12.2, R17.1, R18.2, U1.10 (PC2)
VOLTAGEP: C13.2, R19.1, R20.2, U1.11 (PC3)

Notes on the sheet:
Mounting hole
LED
Supply
MPU6050
RasPi
Connectors
STM32 F446RE

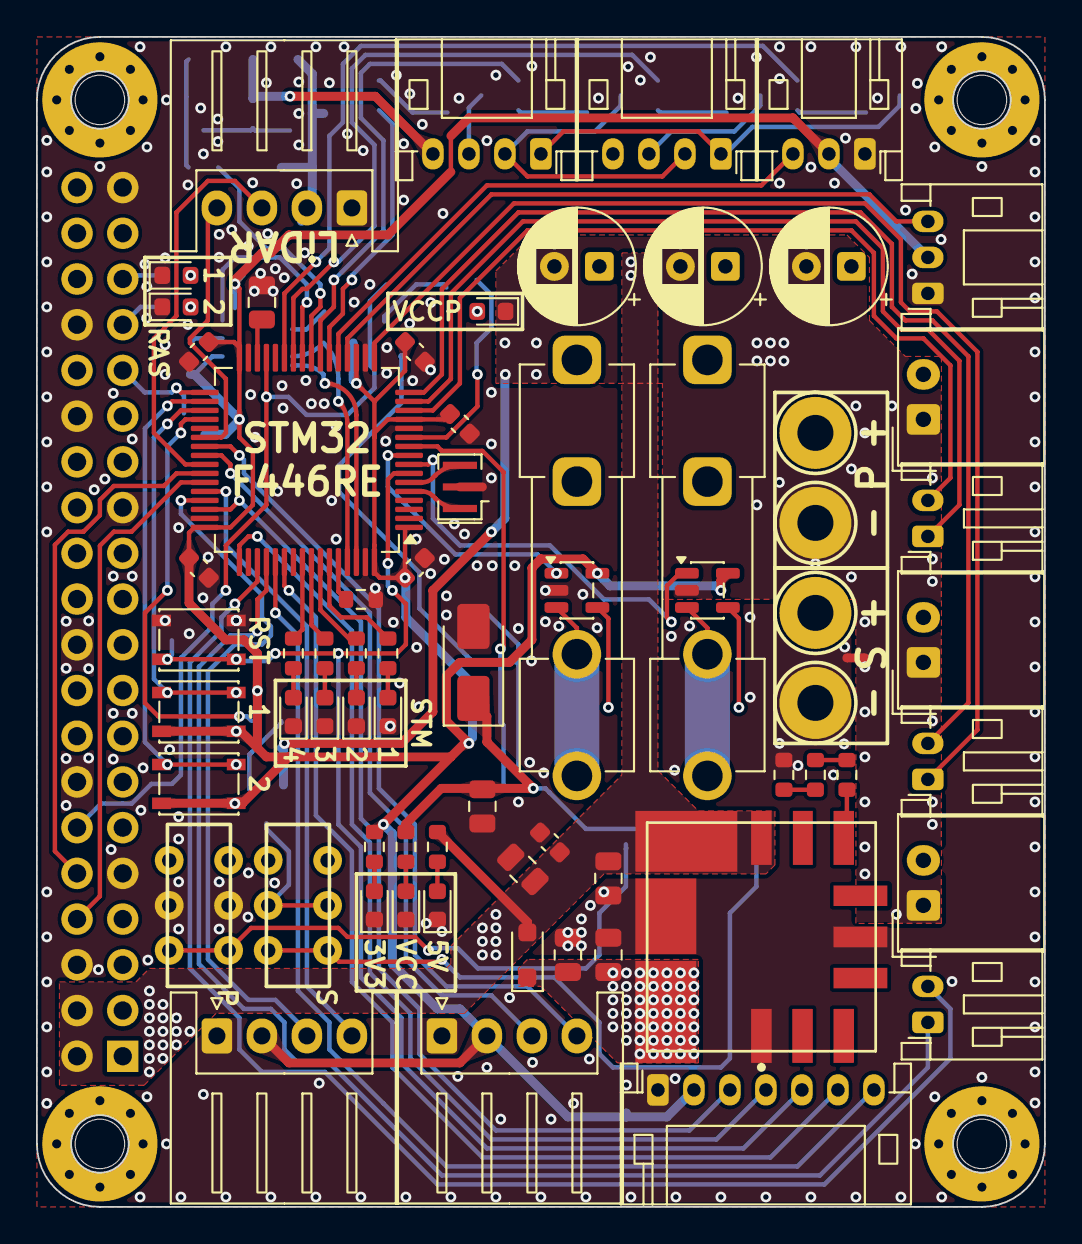
[picture p4: board MainBoard_V3_2.kicad_pcb from above]

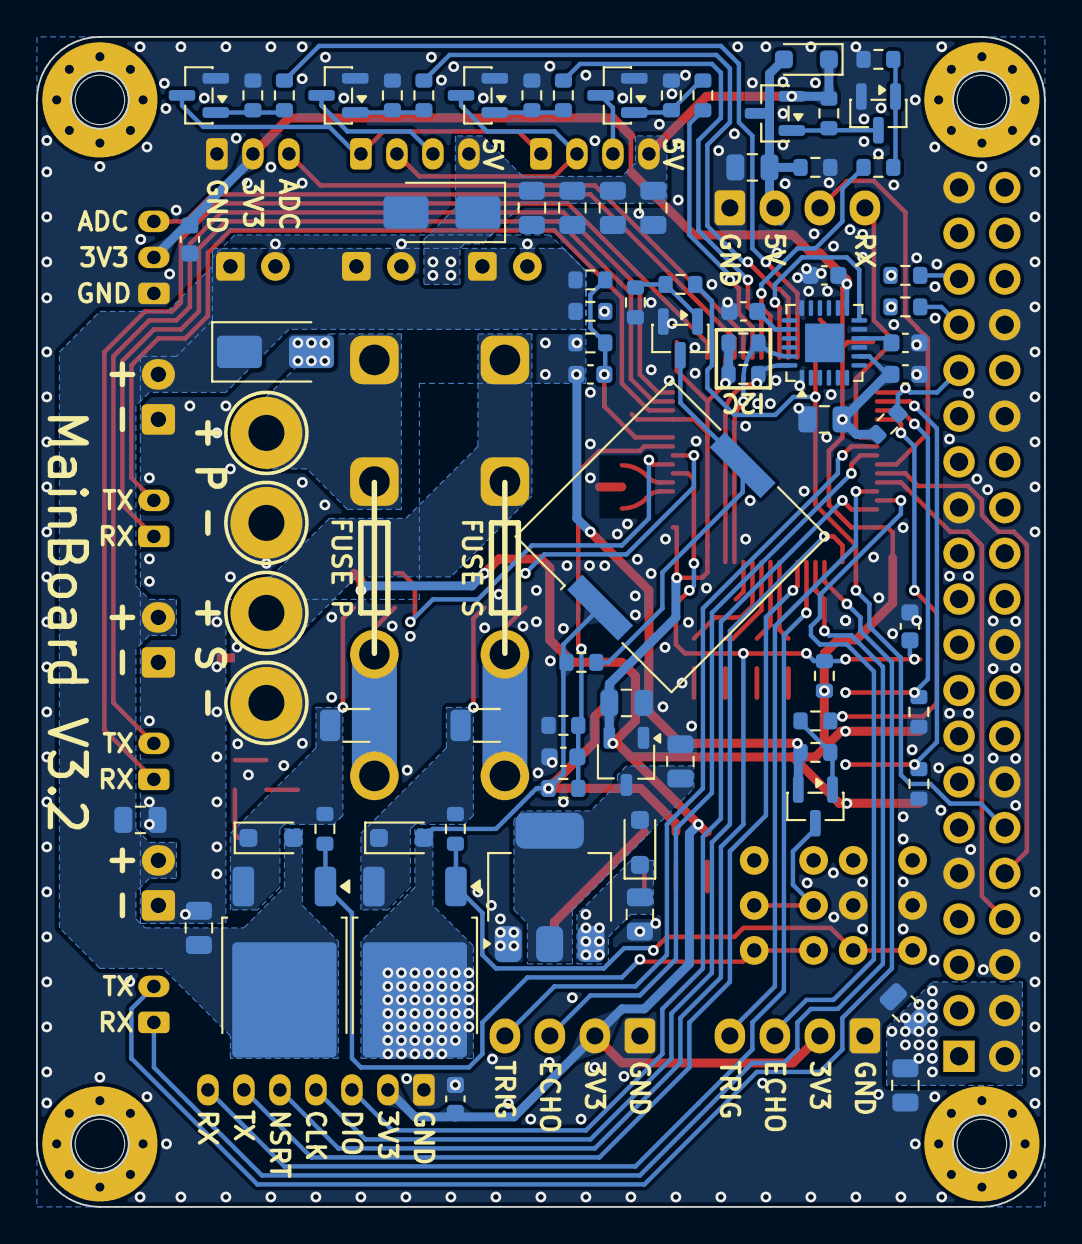
[picture p5: board MainBoard_V3_2.kicad_pcb from below]

Board: 2 copper layers, 56.0 x 65.0 mm, 150 parts (80 on the bottom side), 94 nets.
