banbatakumi/AutonomousCar/Circuit/MainBoard_V2/MainBoard_V2.kicad_pcb

## KiCad design Circuit/MainBoard_V2/MainBoard_V2.kicad_pcb (2026-05-09, an earlier design)

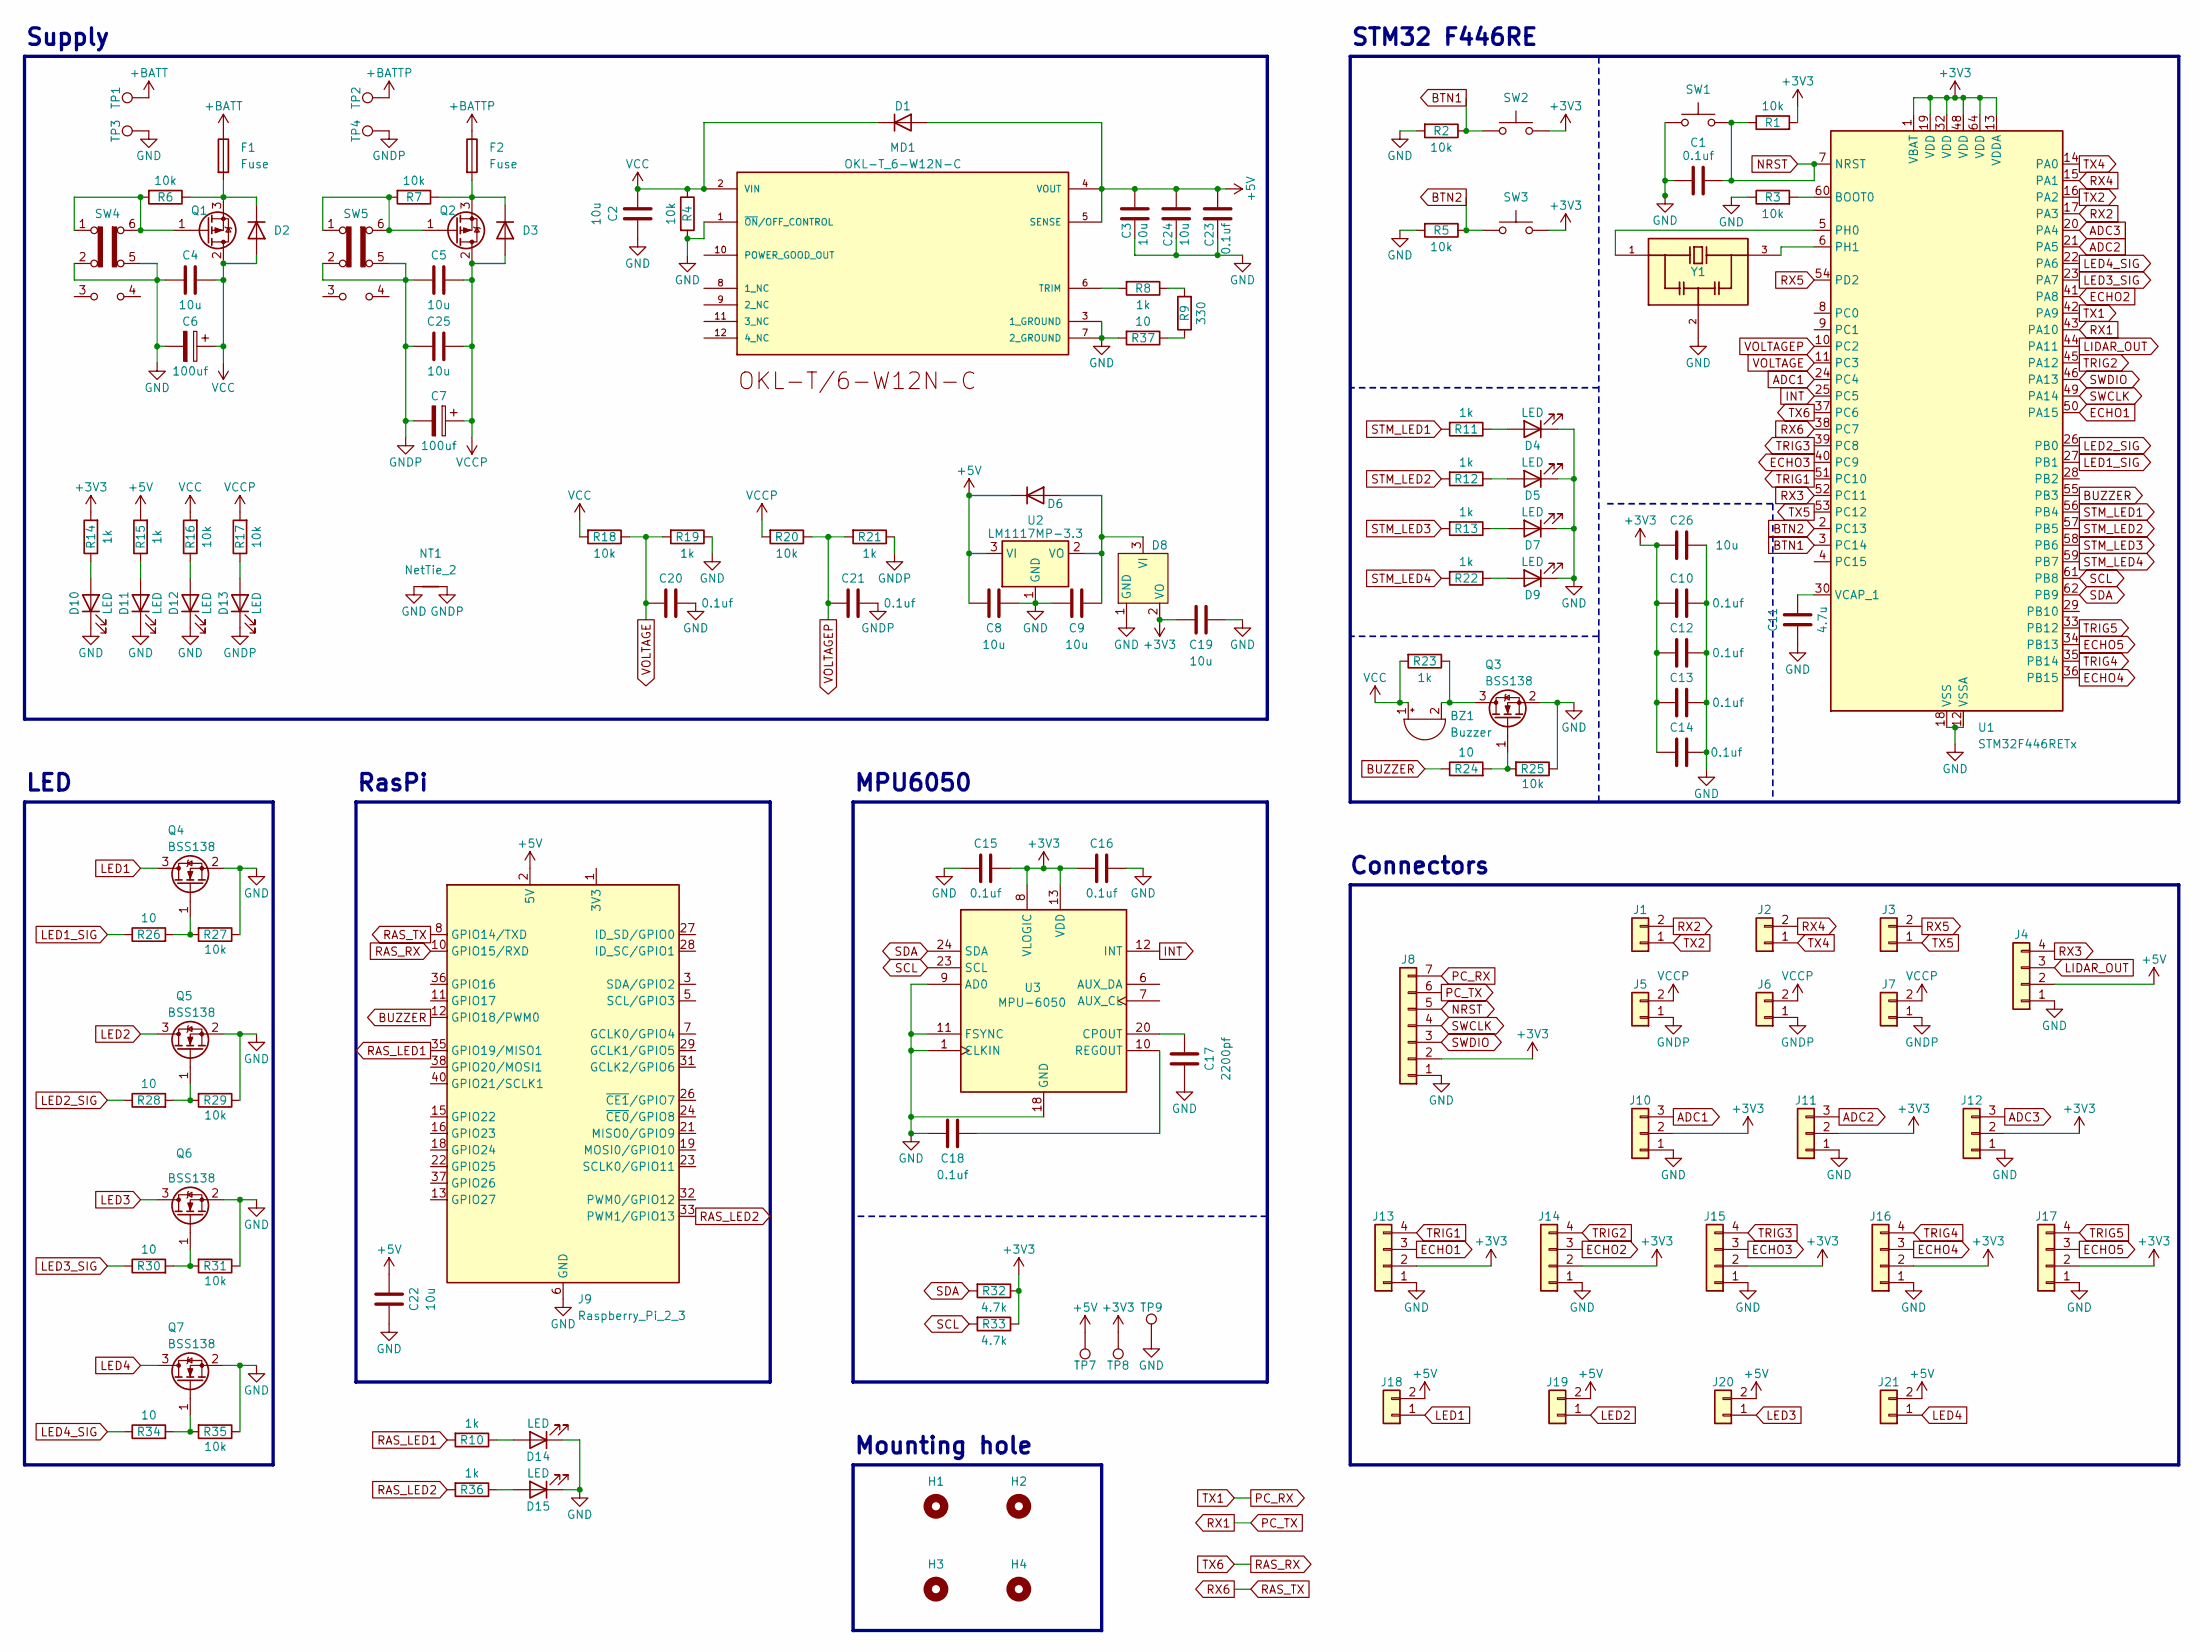
[picture p6: schematic MainBoard_V2.kicad_sch]

Parts:
BZ1: Buzzer; Buzzer_Murata_PKLCS1212E
C1, C10, C12, C13, C14, C15, C16, C18, C20, C21, C23: 0.1uf; C_0603_1608Metric
C2, C3, C4, C5, C8, C9, C19, C22, C24, C25, C26: 10u; C_0805_2012Metric
C6, C7: 100uf; CP_Radial_D6.3mm_P2.50mm
C11: 4.7u; C_0805_2012Metric
C17: 2200pf; C_0603_1608Metric
D1, D2, D3, D6: 1N4148W; D_SOD-123
D4, D5, D7, D9, D10, D11, D12, D13, D14, D15: LED; LED_0603_1608Metric
D8: CH213K; TSOT-23
F1, F2: Fuse; Fuseholder_Clip-5x20mm_Keystone_3517_Inline_P23.11x6.76mm_D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
H1, H2, H3, H4: MountingHole; MountingHole_3.2mm_M3_Pad_Via
J1, J2, J3: Conn_01x02; JST_PH_B2B-PH-K_1x02_P2.00mm_Vertical
J4, J13, J14, J15, J16, J17: Conn_01x04; JST_XH_B4B-XH-A_1x04_P2.50mm_Vertical
J5, J6, J7, J18, J19, J20, J21: Conn_01x02; JST_XH_B2B-XH-A_1x02_P2.50mm_Vertical
J8: Conn_01x07; JST_PH_B7B-PH-K_1x07_P2.00mm_Vertical
J9: Raspberry_Pi_2_3; raspberreyPi_2_3
J10, J11, J12: Conn_01x03; JST_XH_B3B-XH-A_1x03_P2.50mm_Vertical
MD1: OKL-T_6-W12N-C; MURATA_OKL-T-6-W12N-C_0; MOUSER_PART_NUMBER 580-OKL-T/6-W12N-C; MOUSER_DESCRIPTION Non-Isolated DC/DC Converters 12Vin .59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
NT1: NetTie_2; NetTie-2_SMD_Pad0.5mm
Q1, Q2: Q_PMOS_GDS; TO-252-2
Q3, Q4, Q5, Q6, Q7: BSS138; SOT-23
R1, R2, R3, R4, R5, R6, R7, R16, R17, R18, R20, R25, R27, R29, R31, R35: 10k; R_0603_1608Metric
R8, R10, R11, R12, R13, R14, R15, R19, R21, R22, R23, R36: 1k; R_0603_1608Metric
R9: 330; R_0603_1608Metric
R24, R26, R28, R30, R34, R37: 10; R_0603_1608Metric
R32, R33: 4.7k; R_0603_1608Metric
SW1, SW2, SW3: SW_Push; SW_SPST_PTS810
SW4, SW5: SW_Slide_DPDT; IS-2235
TP1, TP2, TP3, TP4: TestPoint; TestPoint_THTPad_D4.0mm_Drill2.0mm
TP7, TP8, TP9: TestPoint; TestPoint_THTPad_D1.0mm_Drill0.5mm
U1: STM32F446RETx; LQFP-64_10x10mm_P0.5mm
U2: LM1117MP-3.3; SOT-223-3_TabPin2
U3: MPU-6050; QFN-24-1EP_4x4mm_P0.5mm_EP2.15x2.15mm
Y1: CSTNE16M0V530000R0; Resonator_SMD_Murata_CSTxExxV-3Pin_3.0x1.1mm; PARTREV JGC42-8853B

Connections:
+3V3: C10.2, C12.2, C13.2, C14.2, C15.1, C16.2, C19.2, C26.1, D8.2 (VO), J8.2, J10.2, J11.2, J12.2, J13.2, J14.2, J15.2, J16.2, J17.2, R1.2, R14.2, R32.1, R33.1, SW2.2, SW3.2, TP8.1, U1.1 (VBAT), U1.13 (VDDA), U1.19 (VDD), U1.32 (VDD), U1.48 (VDD), U1.64 (VDD), U3.8 (VLOGIC), U3.13 (VDD)
+5V: C3.1, C8.2, C22.1, C23.1, C24.1, D1.2 (A), D6.1 (K), J4.2, J9.2 (5V), J9.4 (5V), J18.2, J19.2, J20.2, J21.2, MD1.4 (VOUT), MD1.5 (SENSE), R15.2, TP7.1, U2.3 (VI)
+BATT: F1.1, TP1.1
+BATTP: F2.1, TP2.1
ADC1: J10.3, U1.24 (PC4)
ADC2: J11.3, U1.21 (PA5)
ADC3: J12.3, U1.20 (PA4)
BTN1: R2.1, SW2.1, U1.3 (PC14)
BTN2: R5.1, SW3.1, U1.2 (PC13)
BUZZER: J9.12 (GPIO18/PWM0), R24.1, U1.55 (PB3)
ECHO1: J13.3, U1.50 (PA15)
ECHO2: J14.3, U1.41 (PA8)
ECHO3: J15.3, U1.40 (PC9)
ECHO4: J16.3, U1.36 (PB15)
ECHO5: J17.3, U1.34 (PB13)
GND: C1.1, C2.1, C3.2, C4.2, C6.2, C8.1, C9.2, C10.1, C11.2, C12.1, C13.1, C14.1, C15.2, C16.1, C17.2, C18.2, C19.1, C20.1, C22.2, C23.2, C24.2, C26.2, D4.1 (K), D5.1 (K), D7.1 (K), D8.1 (GND), D9.1 (K), D10.1 (K), D11.1 (K), D12.1 (K), D14.1 (K), D15.1 (K), J4.1, J8.1, J9.6 (GND), J9.9 (GND), J9.14 (GND), J9.20 (GND), J9.25 (GND), J9.30 (GND), J9.34 (GND), J9.39 (GND), J10.1, J11.1, J12.1, J13.1, J14.1, J15.1, J16.1, J17.1, MD1.1 (~ON/OFF_CONTROL), MD1.3 (1_GROUND), MD1.7 (2_GROUND), NT1.1, Q3.2 (S), Q4.2 (S), Q5.2 (S), Q6.2 (S), Q7.2 (S), R2.2, R3.1, R4.2, R5.2, R19.1, R25.1, R27.1, R29.1, R31.1, R35.1, R37.2, SW1.1, SW4.2 (B), SW4.5 (B), TP3.1, TP9.1, U1.12 (VSSA), U1.18 (VSS), U1.31 (VSS), U1.47 (VSS), U1.63 (VSS), U2.1 (GND), U3.1 (CLKIN), U3.9 (AD0), U3.11 (FSYNC), U3.18 (GND), Y1.2
GNDP: C5.1, C7.2, C21.1, C25.1, D13.1 (K), J5.1, J6.1, J7.1, NT1.2, R21.1, SW5.2 (B), SW5.5 (B), TP4.1
INT: U1.25 (PC5), U3.12 (INT)
LED1: J18.1, Q4.3 (D)
LED1_SIG: R26.1, U1.27 (PB1)
LED2: J19.1, Q5.3 (D)
LED2_SIG: R28.1, U1.26 (PB0)
LED3: J20.1, Q6.3 (D)
LED3_SIG: R30.1, U1.23 (PA7)
LED4: J21.1, Q7.3 (D)
LED4_SIG: R34.1, U1.22 (PA6)
LIDAR_OUT: J4.3, U1.44 (PA11)
NRST: C1.2, J8.5, R1.1, SW1.2, U1.7 (NRST)
unnamed: BZ1.2 (-), Q3.3 (D), R23.1
unnamed: D2.1 (K), F1.2, Q1.3 (S), R6.1
unnamed: D3.1 (K), F2.2, Q2.3 (S), R7.1
unnamed: D4.2 (A), R11.1
unnamed: D5.2 (A), R12.1
unnamed: C9.1, D6.2 (A), D8.3 (VI), U2.2 (VO)
unnamed: D7.2 (A), R13.1
unnamed: D9.2 (A), R22.1
unnamed: D10.2 (A), R14.1
unnamed: D11.2 (A), R15.1
unnamed: D12.2 (A), R16.1
unnamed: D13.2 (A), R17.1
unnamed: D14.2 (A), R10.1
unnamed: D15.2 (A), R36.1
unnamed: J9.1 (3V3), J9.17 (3V3)
unnamed: MD1.6 (TRIM), R8.2
unnamed: Q1.1 (G), R6.2, SW4.1 (A), SW4.6 (C)
unnamed: Q2.1 (G), R7.2, SW5.1 (A), SW5.6 (C)
unnamed: Q3.1 (G), R24.2, R25.2
unnamed: Q4.1 (G), R26.2, R27.2
unnamed: Q5.1 (G), R28.2, R29.2
unnamed: Q6.1 (G), R30.2, R31.2
unnamed: Q7.1 (G), R34.2, R35.2
unnamed: R8.1, R9.2
unnamed: R9.1, R37.1
unnamed: R3.2, U1.60 (BOOT0)
unnamed: U1.5 (PH0), Y1.1
unnamed: U1.6 (PH1), Y1.3
unnamed: C11.1, U1.30 (VCAP_1)
unnamed: C17.1, U3.20 (CPOUT)
unnamed: C18.1, U3.10 (REGOUT)
PC_RX: J8.7, U1.42 (PA9)
PC_TX: J8.6, U1.43 (PA10)
RAS_LED1: J9.35 (GPIO19/MISO1), R10.2
RAS_LED2: J9.33 (PWM1/GPIO13), R36.2
RAS_RX: J9.10 (GPIO15/RXD), U1.37 (PC6)
RAS_TX: J9.8 (GPIO14/TXD), U1.38 (PC7)
RX2: J1.2, U1.17 (PA3)
RX3: J4.4, U1.52 (PC11)
RX4: J2.2, U1.15 (PA1)
RX5: J3.2, U1.54 (PD2)
SCL: R33.2, U1.61 (PB8), U3.23 (SCL)
SDA: R32.2, U1.62 (PB9), U3.24 (SDA)
STM_LED1: R11.2, U1.56 (PB4)
STM_LED2: R12.2, U1.57 (PB5)
STM_LED3: R13.2, U1.58 (PB6)
STM_LED4: R22.2, U1.59 (PB7)
SWCLK: J8.4, U1.49 (PA14)
SWDIO: J8.3, U1.46 (PA13)
TRIG1: J13.4, U1.51 (PC10)
TRIG2: J14.4, U1.45 (PA12)
TRIG3: J15.4, U1.39 (PC8)
TRIG4: J16.4, U1.35 (PB14)
TRIG5: J17.4, U1.33 (PB12)
TX2: J1.1, U1.16 (PA2)
TX4: J2.1, U1.14 (PA0)
TX5: J3.1, U1.53 (PC12)
VCC: BZ1.1 (+), C2.2, C4.1, C6.1, D1.1 (K), D2.2 (A), MD1.2 (VIN), Q1.2 (D), R4.1, R16.2, R18.2, R23.2
VCCP: C5.2, C7.1, C25.2, D3.2 (A), J5.2, J6.2, J7.2, Q2.2 (D), R17.2, R20.2
VOLTAGE: C20.2, R18.1, R19.2, U1.11 (PC3)
VOLTAGEP: C21.2, R20.1, R21.2, U1.10 (PC2)

Notes on the sheet:
Mounting hole
MPU6050
Connectors
Supply
STM32 F446RE
LED
RasPi

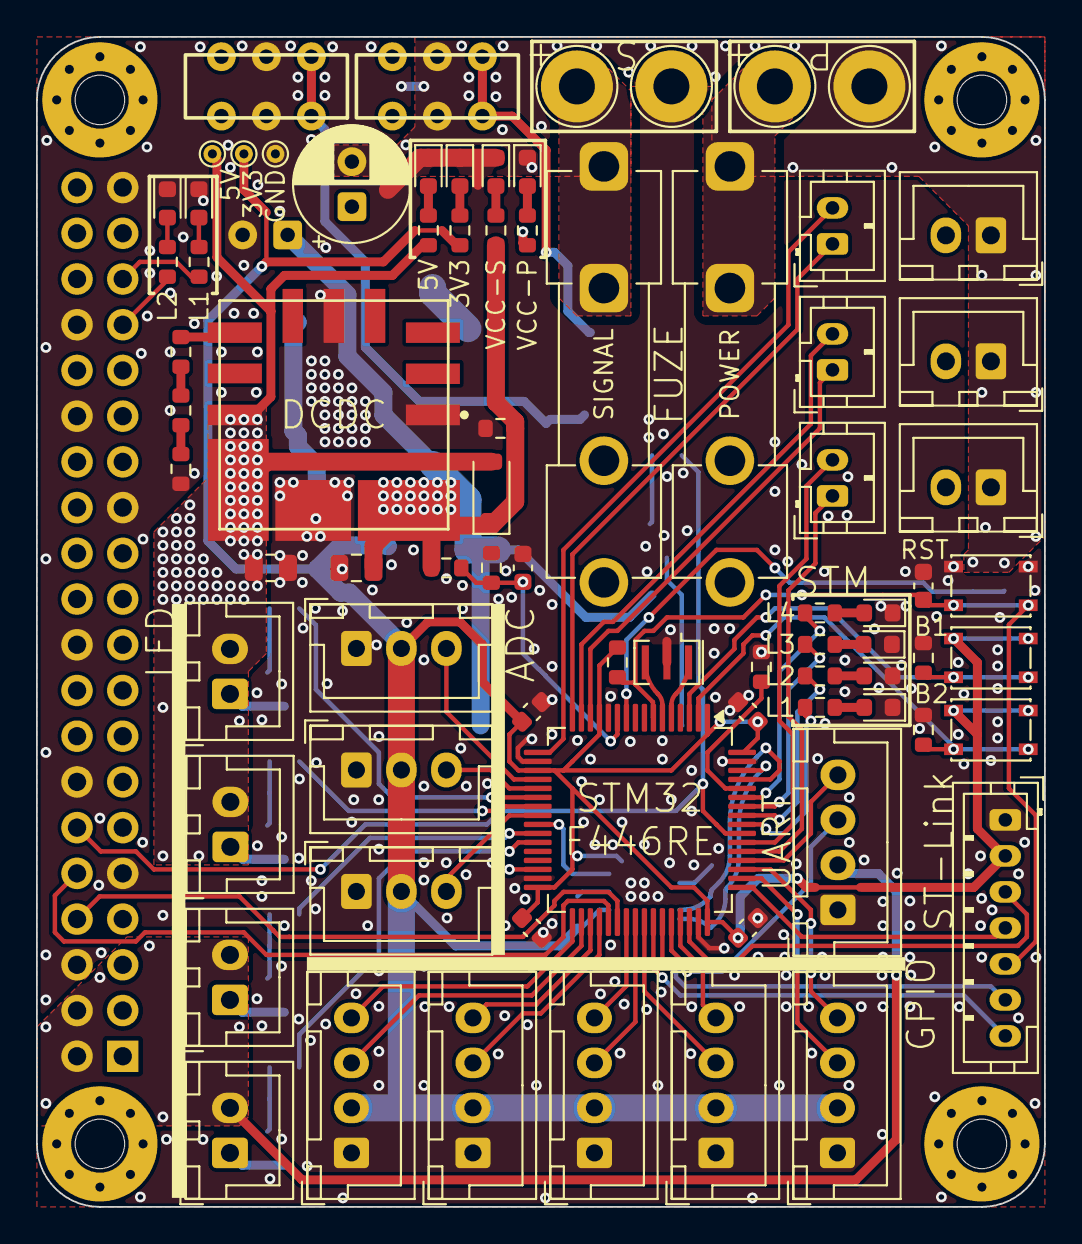
[picture p7: board MainBoard_V2.kicad_pcb from above]

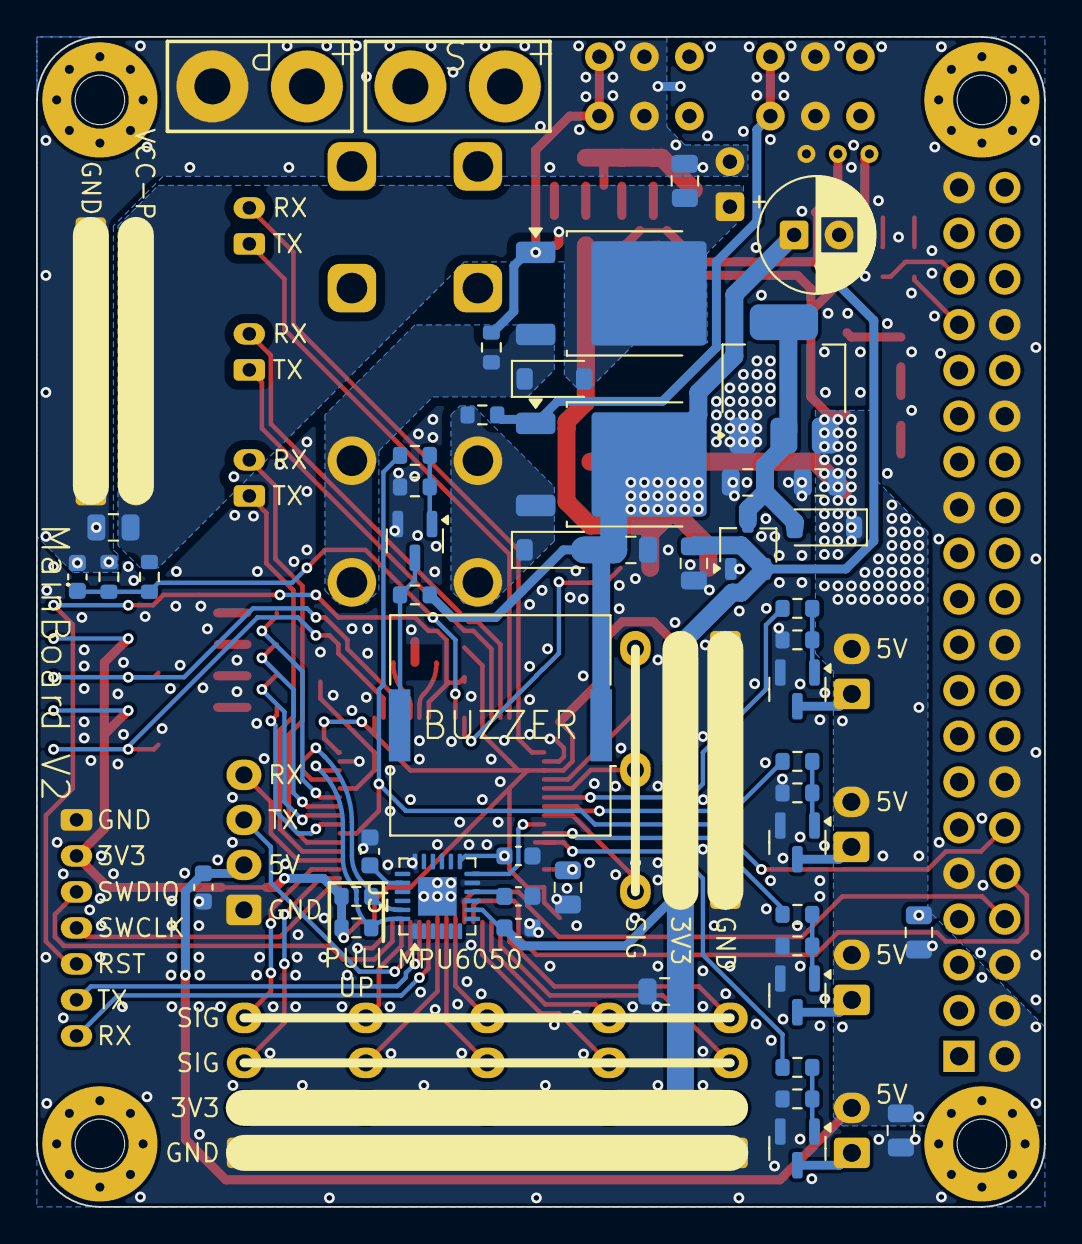
[picture p8: board MainBoard_V2.kicad_pcb from below]

Board: 2 copper layers, 56.0 x 65.0 mm, 131 parts (49 on the bottom side), 89 nets.
