banbatakumi/AutonomousCar/Program/MainF446RE_V3/Core/Src/main.c

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
/* Includes ------------------------------------------------------------------*/
#include "main.h"
#include "adc.h"
#include "dma.h"
#include "i2c.h"
#include "tim.h"
#include "usart.h"
#include "gpio.h"

/* USER CODE BEGIN Includes */
#include "app.h"
/* USER CODE END Includes */


void SystemClock_Config(void);
/* USER CODE BEGIN 0 */
// printf の出力 (UART5)。Setup の間は従来どおりブロッキングで送る (起動ログを取りこぼさない)。
// メインループに入ったあと (Log_EnableNonBlocking) は、リングバッファに積むだけにして
// Log_Pump() が送れる分だけ1バイトずつ送り出す。ブロッキングで送ると最大10ms 止まり、
// その間ハートビートのポーリング・制御・MD への指令が止まる。溢れた分は捨てる
#define LOG_RING_SIZE 512
static uint8_t log_ring[LOG_RING_SIZE];
static volatile uint16_t log_head = 0;
static volatile uint16_t log_tail = 0;
static volatile uint8_t log_nonblocking = 0;

void Log_EnableNonBlocking(void) { log_nonblocking = 1; }

void Log_Pump(void) {
  if (log_head == log_tail) return;
  if (!(huart5.Instance->SR & USART_SR_TXE)) return;
  huart5.Instance->DR = log_ring[log_tail];
  log_tail = (uint16_t)((log_tail + 1) % LOG_RING_SIZE);
}

int _write(int file, char* ptr, int len) {
  (void)file;
  if (!log_nonblocking) {
    HAL_UART_Transmit(&huart5, (uint8_t*)ptr, len, 10);
    return len;
  }
  for (int i = 0; i < len; i++) {
    uint16_t next = (uint16_t)((log_head + 1) % LOG_RING_SIZE);
    if (next == log_tail) break;  // 満杯 (残りは捨てる)
    log_ring[log_head] = (uint8_t)ptr[i];
    log_head = next;
  }
  return len;
}

/* USER CODE END 0 */

/**
  * @brief  The application entry point.
  * @retval int
  */
int main(void)
{

  /* MCU Configuration--------------------------------------------------------*/

  /* Reset of all peripherals, Initializes the Flash interface and the Systick. */
  HAL_Init();

  /* Configure the system clock */
  SystemClock_Config();

  /* Initialize all configured peripherals */
  MX_GPIO_Init();
  MX_DMA_Init();
  MX_UART4_Init();
  MX_UART5_Init();
  MX_USART1_UART_Init();
  MX_USART2_UART_Init();
  MX_USART3_UART_Init();
  MX_USART6_UART_Init();
  MX_ADC1_Init();
  MX_I2C1_Init();
  MX_TIM3_Init();
  MX_TIM4_Init();
  MX_TIM1_Init();
  MX_TIM2_Init();
  MX_ADC2_Init();
  /* USER CODE BEGIN 2 */
  Setup();
  MainApp();

  /* USER CODE END 2 */

  /* Infinite loop */
  /* USER CODE BEGIN WHILE */
  while (1) {
    /* USER CODE END WHILE */

    /* USER CODE BEGIN 3 */
  }
  /* USER CODE END 3 */
}

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
