banbatakumi/AutonomousCar/Program/MainF446RE_V3/MainF446RE_V3.ioc

Mcu.UserName=STM32F446RETx
PA0-WKUP.Signal=UART4_TX
PA1.Signal=UART4_RX
PA10.Signal=USART1_RX
PA11.GPIO_Label=TRIG_FRONT
PA11.Signal=GPIO_Output
PA12.GPIO_Label=ECHO_FRONT
PA12.Signal=GPXTI12
PA13.Signal=SYS_JTMS-SWDIO
PA14.Signal=SYS_JTCK-SWCLK
PA2.Signal=USART2_TX
PA3.Signal=USART2_RX
PA4.GPIO_Label=ENCODER_RIGHT
PA4.Signal=ADCx_IN4
PA5.GPIO_Label=ENCODER_LEFT
PA5.Signal=ADCx_IN5
PA6.GPIO_Label=FRONT_LED
PA6.Signal=S_TIM3_CH1
PA7.GPIO_Label=LW_LED
PA7.Signal=S_TIM3_CH2
PA8.GPIO_Label=LIDAR_OUT
PA8.Signal=S_TIM1_CH1
PA9.Signal=USART1_TX
PB0.GPIO_Label=REAR_LED
PB0.Signal=S_TIM3_CH3
PB1.GPIO_Label=RW_LED
PB1.Signal=S_TIM3_CH4
PB10.GPIO_Label=BUZZER
PB10.Signal=S_TIM2_CH3
PB12.GPIO_Label=RAS_SIG
PB12.Signal=GPIO_Input
PB13.GPIO_Label=BUTTON2
PB13.Signal=GPIO_Input
PB14.GPIO_Label=BUTTON1
PB14.Signal=GPIO_Input
PB15.GPIO_Label=DRIVE_POWER
PB15.Signal=GPIO_Output
PB4.GPIO_Label=LED1
PB4.Signal=GPIO_Output
PB5.GPIO_Label=LED2
PB5.Signal=GPIO_Output
PB6.GPIO_Label=LED3
PB6.Signal=S_TIM4_CH1
PB7.GPIO_Label=LED4
PB7.Signal=S_TIM4_CH2
PB8.Signal=I2C1_SCL
PB9.Signal=I2C1_SDA
PC0.GPIO_Label=CURRENT_P
PC0.Signal=ADCx_IN10
PC1.GPIO_Label=CURRENT_S
PC1.Signal=ADCx_IN11
PC10.Signal=USART3_TX
PC11.Signal=USART3_RX
PC12.Signal=UART5_TX
PC2.GPIO_Label=VOLTAGE_S
PC2.Signal=ADCx_IN12
PC3.GPIO_Label=VOLTAGE_P
PC3.Signal=ADCx_IN13
PC4.GPIO_Label=LIDAR_POWER
PC4.Signal=GPIO_Output
PC5.GPIO_Label=INT
PC5.Signal=GPXTI5
PC6.Signal=USART6_TX
PC7.Signal=USART6_RX
PC8.GPIO_Label=TRIG_REAR
PC8.Signal=GPIO_Output
PC9.GPIO_Label=ECHO_REAR
PC9.Signal=GPXTI9
PD2.Signal=UART5_RX
PH0-OSC_IN.Signal=RCC_OSC_IN
PH1-OSC_OUT.Signal=RCC_OSC_OUT
