banbatakumi/AutonomousCar/Program/MainF446RE_V3/src/control/drive.h

#ifndef DRIVE_H_
#define DRIVE_H_

#include <stdbool.h>

#include "control_params.h"
#include "encoder.h"
#include "encoder_direction.h"
#include "imu.h"
#include "lpf.h"
#include "motors.h"
#include "pid.h"
#include "speed_kf.h"
#include "steering.h"
#include "timer.h"
#include "torque_vectoring.h"

// 後輪2モータをトルク制御し、車速をこのマイコン側で閉ループ制御する。
//
// 制御構造 (カスケード):
//   [目標車速] → 車速PI (このモジュール, メインループ周期) → 総駆動トルク
//                                                          ↓ 左右配分 + トルクベクタリング項
//                                          左輪トルク ← TCリミッタ → 右輪トルク
//                                                          ↓ UART
//                                          [MDの電流ループ (kHz)] ← 内側ループはMD側
//
// 左右の配分は等トルクを基準とし、そこへトルクベクタリング (src/control/torque_vectoring) が
// 決めた左右差 (旋回中の左右の荷重の比) だけを重ねる。片輪が上限に当たらない限り総和は
// 変わらないので車速制御とは干渉しない。差を付けない限りは
// 旋回時の内外輪速度差を各輪が自然に見つける (オープンデフ相当) 挙動になり、左右輪へ独立に
// 速度ループを掛ける方式と違ってタイヤ径誤差やアッカーマンモデル誤差による内部トルクの循環
// (片輪が押して片輪が引く状態) が原理的に発生しない。
//
// 車速の真値は非駆動輪である前輪エンコーダから得るため、駆動輪速度との比較でスリップ率が
// 直接計算でき、トラクションコントロール (TC) が成立する。制動 (Drive_SetBrake) 側も同じ
// スリップ率を負側で見て、ロックしかけたら制動トルクを抜く (ABS)。

// ===========================================================================
// 車両パラメータ (実測値)
//
// 後輪は減速機を挟まないダイレクトドライブのため、モータ角速度がそのまま車輪角速度になる。
// 減速比の定数を置いていないのはこのため (減速機を入れたら車輪速の換算に比を掛けること)。
// ===========================================================================
#define DRIVE_FRONT_WHEEL_RADIUS_M 0.030f  // 前輪 (非駆動輪) の有効転がり半径 [m] (直径60mm)
#define DRIVE_REAR_WHEEL_RADIUS_M 0.030f   // 後輪 (駆動輪) の有効転がり半径 [m] (直径60mm)
#define DRIVE_WHEELBASE_M 0.230f           // 前後車軸間距離 [m]
#define DRIVE_REAR_TRACK_M 0.155f          // 後輪左右間距離 (トレッド) [m]

// 半径は幾何寸法 (直径60mm) から入れてある。ゴムタイヤは荷重で潰れるぶん実際の転がり半径が
// 数%小さくなり、その誤差はそのまま車速とオドメトリの倍率誤差になる。精度が要るなら
// メジャーで測った距離を転がして Drive_GetFrontOdom0p1mm() の値から逆算すること。

// 各センサ・アクチュエータの符号。左右のモータ/エンコーダは鏡像に取り付くため、
// 「車体前進方向を正」に揃えるための符号をここで吸収する。
// ★未確認: 実機で1輪ずつ回して確認すること。符号を間違えると車が逆に走るだけでなく、
// TCがスリップ率を符号ごと誤読して、滑っていないのにトルクを削る (逆に足す) side に倒れる★
#define DRIVE_REAR_LEFT_DIR (-1.0f)
#define DRIVE_REAR_RIGHT_DIR (+1.0f)
#define DRIVE_FRONT_LEFT_DIR (-1.0f)
#define DRIVE_FRONT_RIGHT_DIR (+1.0f)

// ===========================================================================
// 制御パラメータ
// ===========================================================================
// 車速PIの比例・積分ゲインは調整パラメータ (control_params.h の speed_kp・speed_ki。上位が送る)
#define DRIVE_SPEED_KD 0.0f  // 車速は微分ノイズが乗りやすいため使わない

// 1輪あたりのトルク上限 [Nm] (プロトコル上の絶対上限は ±3.2767)。
// この値は指令のクランプに使うと同時に MD 側のトルク上限としても設定するため、
// このマイコンのバグや通信異常で過大な指令が出ても最終段で頭打ちになる。
// 上位が指令できる制動トルク (DRIVE_MAX_BRAKE_TORQUE_NM) もこの上限を超えないこと。
//
// ★MD 側の絶対上限 (Kt × 最大電流 10A。Kt は MD ごとの校正値) を超えないこと。MD は受け取った
// 上限を自分の絶対上限で頭打ちにして返し、こちらは指令と完全に一致するまで MD を「使える」と
// みなさない (Motors_NotReadyReason)。現在の後輪 MD の絶対上限は約0.2Nm。MD を校正し直して
// Kt が 0.015Nm/A を下回ると、上限に届かず ARM の5秒後に md_fault でラッチして走れなくなる
// (LOG に "torque limit not applied" と出る)。
// ★上位 (Pi) の同値: raspi/msgs/convert.py の MAX_TARGET_TORQUE_NM (GUI の store/ui.ts・
//   vehicle.toml の speed_torque_max_nm = これ×2 は tools/fwsim/tests/test_fw_constants.py が突き合わせる)
#define DRIVE_MAX_TORQUE_NM 0.15f
// 上位が指令できる車速の上限 [m/s] (COMMAND.target_speed をここでクランプし、LIMITS で上位へ通知する)
#define DRIVE_MAX_SPEED_M_S 5.0f
// 実車速がこれを超えたら正トルクを出さない (暴走時の最終防壁)。指令の上限と同じ値にすると、上限ちょうどを
// 指令したときに車速の揺れで正トルクが入切を繰り返して上限を保てないので、1割上に置く。
// 後輪 MD のトルクモードの過速度保護 (BLDC/ProgramV4 の OVERSPEED_DIRECT_IQ_RAD_S = 270 rad/s = 8.1m/s) より下
#define DRIVE_OVERSPEED_GUARD_M_S (DRIVE_MAX_SPEED_M_S * 1.1f)
// 上位が加速度制限を指定しなかった (COMMAND.accel_limit = 0) ときに、目標車速を動かす傾き。
// 上位が指定した値に上限は掛けない。目標車速のランプそのものは残る (車速PIの加速度フィードフォワードが、この
// 傾きに要るトルクを先に足す)。上限を掛けない理由: 出せる加速はタイヤのグリップで決まり、路面で
// 変わる (フローリングの同定で約2.8m/s²、畳はそれより高い)。固定の上限があると、上位が同定し直して
// もファームを書き直すまで使えない。滑らせない役目は TC が、暴走を止める役目は
// トルク上限 (DRIVE_MAX_TORQUE_NM) と速度上限 (DRIVE_MAX_SPEED_M_S) が持っている。
// 上位は config/vehicle.toml の [safety] cmd_accel_limit_m_s2 で上限を決めて毎回送る
#define DRIVE_DEFAULT_ACCEL_M_S2 3.0f
// 上位が指定できる加速度制限の下限 [m/s^2] (0 に近い値で目標車速が動かなくなるのを避ける)
#define DRIVE_MIN_ACCEL_LIMIT_M_S2 0.01f
#define DRIVE_ANTIWINDUP_TT_S 0.10f  // TC/リミッタで飽和したときに積分を巻き戻す時定数 [s]

// 停車: 目標車速がほぼ0かつ実車速もほぼ0のとき、指令を止めて自由回転させる (惰行)。
// 上位が明示的にブレーキ (RAS_CMD_FLAG_BRAKE) を指定しない限り、停車中も車両を押さえ込まない
#define DRIVE_STANDSTILL_SPEED_M_S 0.05f

// ===========================================================================
// 車速PIの加速度フィードフォワード (params.speed_ff_nm_per_m_s2・speed_ff_rr_nm)
//
// 車速PIだけだと、加速度 a を出すトルクは偏差が a / (車体の利得 × Kp) だけ溜まるまで出ない
// (約0.15秒ぶんの遅れ。上位の経路追従では、コーナーの手前の減速が遅れて速すぎる速度で入った)。
// 目標車速はこのモジュールが accel_limit の傾きで動かしているので、その傾きは分かっている。
// 「その加速に要るトルク」= 傾き × speed_ff_nm_per_m_s2 と、転がり抵抗ぶん speed_ff_rr_nm
// (進む向き) を PI の出力に先に足す。PI は残ったずれ (モデルの誤差・勾配・TC の介入) だけを直す。
//
//   - 傾きは「この周期に目標車速を動かした量 ÷ dt」。上位は DRIVE_HOST_COMMAND_PERIOD_S ごとに目標を
//     刻むので、目標に届いた周期は 0、届く前は accel_limit、と周期ごとに跳ぶ。その刻みの周期を時定数に
//     した 1 次ローパスでならす (刻みの周期より短いと跳びが残り、長いと傾きの変化に遅れる)。
//     上位はこの時定数ぶん先の速度を送る (Pi 側 config/vehicle.toml の [dynamics] speed_ff_filter_s
//     が同じ値を持つ。上位の tools/fwsim のテストがこのヘッダと突き合わせる)
//   - 足した後の合計を ±最大トルクに収める。TC・リミッタで削られた分の積分の巻き戻し
//     (UnwindIntegral) は、足した後の要求と実際に出したトルクの差で行う
//   - 制動・トルク指令・ローンチコントロール・停車の惰行の間は足さない (傾きの記憶も 0 に戻す)
//   - 2 つの値とも 0 (既定) なら何も足さない (FF なしの車速PIと同じ動き)
// 上位 (Pi) が COMMAND を送る周期 [s] = 50Hz (Pi 側 raspi/auto/base.py の CMD_HZ)
#define DRIVE_HOST_COMMAND_PERIOD_S 0.02f
#define DRIVE_SPEED_FF_TAU_S DRIVE_HOST_COMMAND_PERIOD_S

// ===========================================================================
// ローンチコントロール (発進の加速。Drive_SetLaunch)
//
// 車速指令の加速は、目標車速のランプ (上位が送る accel_limit) を車速PIが追う形なので、偏差が
// 溜まるまでトルクが出ない (グリップの限界のトルクに届くまで約0.3秒。Pi 側 tools/fwsim の
// 車両モデルで、停止からの最初の1秒に進む距離がトルク指令の全開の約3/4)。上位が要求している間、
// 目標車速が実車速より大きく離れた加速だけ、ランプとPIを迂回して全開のトルクを要求し、TC に
// グリップの限界へ絞らせる (= トルク指令の全開と同じ加速)。車速が目標に届いたら車速PIへ戻す。
//
//   始める: 要求あり・目標車速が車速より DRIVE_LAUNCH_MIN_STEP_M_S 以上速い (徐行の指令や、
//           上位が自分で刻むランプでは始めない)・目標と逆向きに DRIVE_LAUNCH_REVERSE_SPEED_M_S
//           以上で動いていない (動いていれば、まず車速PIで止める)。
//           車速は問わない: 上位は停止からだけでなく、低速で経路に乗ってから要求することがある
//   終わる: 車速が目標 (の DRIVE_LAUNCH_END_MARGIN_M_S 手前) に届いた / 要求が下りた / 制動・
//           torque_mode・サイドブレーキ / DRIVE_LAUNCH_TIMEOUT_S 経った (壁に当たっている・
//           前輪が読めない)
//   1回の要求で1回だけ。要求を下ろす・制動する・止まって惰行する、のどれかでまた使える
//   (届かずに時間切れで終わったあと、止まったまま全開を繰り返さないため)。
//   いつ要求するか (= 全開で加速してよい場面か) は上位が決める
//
// 発進中は目標車速 (target_speed_m_s) を実車速に合わせ続けるので、PIへ戻すときは「今の車速から
// 残りをランプで詰める」形になる。積分は発進中のものを持ち越さず、その車速を保つのに要るトルク
// (launch_exit_torque_nm。上位が同定値から決めて送る) から始める。
// 空転を抑えるのは TC だけなので、TC が無効なら始めない。
// ===========================================================================
#define DRIVE_LAUNCH_REVERSE_SPEED_M_S 0.3f
#define DRIVE_LAUNCH_MIN_STEP_M_S 0.5f
// 目標のこれだけ手前で終える。車速推定の遅れと MD の遅れのぶん、全開の
// 加速度 (約2.5m/s^2) では実車速が読みより 0.05m/s ほど先にいる
#define DRIVE_LAUNCH_END_MARGIN_M_S 0.05f
#define DRIVE_LAUNCH_TIMEOUT_S 3.0f  // 最高速 (5m/s) まで約2秒

// 上位から指令できる制動トルクの上限 [Nm]。MD側のトルク上限 (DRIVE_MAX_TORQUE_NM) を
// 超える値を送っても MD 側で頭打ちになるだけなので、指令の時点で同じ値に揃えておく
#define DRIVE_MAX_BRAKE_TORQUE_NM DRIVE_MAX_TORQUE_NM

// ===========================================================================
// スリップ制限 (TC・ABS・片輪浮き対策)
//
// 調整パラメータは control_params.h (ControlParams)。上位が CONFIG_SET で入れる。
//
// ■ スリップの測り方
// 後輪の周速と「その輪が滑っていなければ出るはずの速度」(前輪の車速 ± ヨーレート×半トレッド)
// の差をスリップ速度、それを max(|基準速度|, slip_speed_floor_m_s) で割ったものをスリップ率と
// する。分母に下限を置くのは、車速が0に近いと率が発散するため (低速で TC・ABS ごと無効にすると
// 発進時の空転を誰も見られない)。下限より遅い間は「スリップ
// 速度が 下限×目標スリップ率 を超えたか」を見ていることになる。
// 制御が見るのは**トルクを掛けている向きのスリップ速度**: 駆動なら空転、車速PIの減速・制動なら
// ロック傾向が正になる。前進・後退・加速・減速を1つの式で扱える。
//
// ■ 制限のしかた (TC・ABS 共通)
// スリップ率を目標 (tc_slip_target / abs_slip_target) に保つ連続の PI。出力はトルクの上限。
//   偏差 e = 目標スリップ率×分母 − スリップ速度 [m/s] (正 = 余裕がある)
//   上限 = 積分 + kp×e。積分は ki×e で進む。どちらも [下限, 最大値] に収める
//   滑り始めた周期 (e が負になった周期) は、積分を実際に掛けていたトルクまで下げてから進める
//     (上限を最大値から削り始めると、掛けているトルクへ届くまで何もしないのと同じになる)
// 止め方だけが違う:
//   TC (TractionLimiter): 止めない。滑らなければ積分が最大値まで戻り、そこが「制限なし」になる。
//     ABS と同じ止め方にすると、要求が満額 (車速PIの張り付き) のとき滑りが収まった周期に
//     制限なしへ跳ね戻って次の周期にまた滑り、周期的に入り切りする
//   ABS (SlipLimiter): 上限が要求トルク以上に戻ったら (= 要求どおり掛けても滑らない) 止める。
//     上限が低いまま長く留まるとフォールバック (DRIVE_ABS_FALLBACK_*) が働くため
// 実車の油圧 ABS の「減→保持→増」を写したルールベースにしないのは、油圧の弁は開閉しかできない
// ので段を刻むが、モータはトルクを連続に出せるため。段を刻むと最初の一撃で深くロックし、
// 再カットで必要以上に抜く (ロックなしの約85%)。比較は Pi 側リポジトリの tools/fwsim/bench.py。
//
// ■ TC (各輪独立)
// 駆動 (車速PI・torque_mode) と、後退中の車速PIの減速に掛かる。前進中の車速PIの減速は TC ではなく
// ABS で絞る (ApplySpeedPiAbs)。減速に TC を使うと上限が 0 と満額を往復し
// 後輪が大きく滑ってスピンした。
// 片輪を絞っても、その分を反対の輪へ載せない (総駆動力が減る)。総和を保つために
// 反対の輪を押し増すと、要求していないヨーモーメントが出る。
//
// ■ 片輪浮き対策
// TC の基準は前輪なので、前輪エンコーダが壊れると働かない (または絞り続ける)。前輪に依らない
// 見張りとして「後輪左右の速度差からヨーレートで説明できる分を引いた残り」が
// wheel_lift_diff_threshold_m_s を超えたら、トルクの向きへ先走っている輪を TC と同じ PI で絞る
// (偏差は TC と小さい方を使う)。TC とは独立に ON/OFF できる。
//
// ■ ABS
// 制動モード (Drive_SetBrake) と、前進中に車速PIが減速トルクを出している間に働く。上限は左右共通で、ロックしかけている側に合わせる
// (select-low)。左右独立にすると左右で路面μが違うときに後輪側でヨーモーメントが出てスピン方向に
// 振れるため、実車の後輪 ABS と同じく安定性を優先する。
// ===========================================================================

// 後輪周速がこれを超えたら、基準速度・左右差に関係なく即座にトルクを0にする (最終防波堤。
// 片輪浮き対策の一部として ON/OFF される)。7.5m/s
#define DRIVE_WHEEL_LIFT_MAX_WHEEL_SPEED_M_S (DRIVE_MAX_SPEED_M_S * 1.5f)

// ABS のフォールバック: 上限が要求の DRIVE_ABS_FALLBACK_LIMIT_RATIO 以下に張り付いたまま
// DRIVE_ABS_FALLBACK_TIME_S 続いたら、ブレーキを離すまで ABS を止めて要求どおりに制動する。
// 前輪エンコーダの故障・符号ミスで基準車速が高く出るとスリップがロック側に張り付き、緊急停止中も
// 制動を抜き続けてしまうため。本来の ABS はグリップの限界付近 (この車は最大制動の約6割) に
// 留まるので、2割以下に長く張り付くことは少ない、という前提に立つ (非常に滑る路面で本当に
// 抜き続ける場面ではロック側に倒れる)
#define DRIVE_ABS_FALLBACK_LIMIT_RATIO 0.2f
#define DRIVE_ABS_FALLBACK_TIME_S 0.2f

// ===========================================================================
// 各輪の周速のローパスの時定数 [s]
// 係数は毎周期、実際の周期 dt から k = exp(-dt/τ) で求める (LPF_UpdateTau)。係数を定数で持つと
// メインループの周期 (app.c の CONTROL_INTERVAL_US) を変えたときに時定数が黙って変わるため。
// 車体の車速は走行距離と加速度計のカルマンフィルタ (speed_kf.h) が出す。ここは各輪の周速の報告用と
// TC の後輪周速だけ。
// 前輪は Encoder 側で ADC を32サンプル平均して角度ノイズを下げたのに合わせた約10ms (2kHz で係数 0.951)。
// 静止時の実測で生の前輪角速度の標準偏差は約2.2〜3.4rad/s の白色ノイズ。
// Pi 側 config/vehicle.toml の [dynamics] speed_filter_s がこの前輪の値を持つ
// ===========================================================================
#define DRIVE_LPF_TAU_FRONT_S 0.00995f  // 前輪の各輪の周速 (上位報告用)
#define DRIVE_LPF_TAU_REAR_S 0.00475f   // 後輪モータ速度 (MD側で既にフィルタ済みのため弱め。2kHz で係数 0.90)

// ABS の状態 (左右共通で1つ)
typedef struct {
  bool active;        // スリップが目標を超えて働き始めてから、上限が要求以上へ戻るまで
  float integral_nm;  // PI の積分 = 「このトルクなら滑らない」という見積もり
} SlipLimiter;

// TC の状態 (各輪)。働いている・いないの区別は持たない (積分が最大値 = 制限なし)
typedef struct {
  float integral_nm;  // PI の積分 = 「このトルクなら滑らない」という見積もり。滑らなければ最大値まで戻る
  bool slipping;      // 前の周期に滑っていた (偏差が負)。滑り始めの周期を見分ける
} TractionLimiter;

typedef struct {
  Motors* motors;
  Encoder* encoder;
  Steering* steering;
  Imu* imu;  // ヨーレート取得用 (NULL可。その場合は自転車モデルで代用する)

  ControlParams params;  // 調整パラメータ (Drive_SetParams で上位の設定を写す)

  PID speed_pid;
  TorqueVectoring tv;
  LPF lpf_front_left;
  LPF lpf_front_right;
  LPF lpf_rear_left;
  LPF lpf_rear_right;
  Timer timer;
  SpeedKf speed_kf;           // 走行距離+加速度計の車速推定 (制御の車速)
  uint32_t kf_encoder_seq;    // 取り込み済みの Encoder 更新番号 (同じ更新を二重に使わない)
  uint32_t kf_imu_seq;        // 取り込み済みの IMU サンプル番号
  // 前輪の読みの向きの反転 (AS5600 の出力が鏡像になる) を後輪の速度と突き合わせて直す (encoder_direction.h)
  EncoderDirection front_dir_left;
  EncoderDirection front_dir_right;
  uint32_t dir_encoder_seq;    // 向きの判定に取り込み済みの Encoder 更新番号
  float front_step_left_m;     // 直した前輪の増分 [m] (前進が正。車速 KF が使う)
  float front_step_right_m;
  // 前輪の走行距離 (TELEMETRY の odom_dist。前進が正、鏡像と折り返しを直した増分の累積) と、0.1mm 未満の端数
  int32_t front_odom_left_0p1mm;
  int32_t front_odom_right_0p1mm;
  float front_odom_carry_left;
  float front_odom_carry_right;

  bool enabled;
  bool tc_enabled;                // 既定は無効 (上位が送る)
  bool wheel_lift_guard_enabled;  // 既定は有効。TC本体とは独立にON/OFF可能
  bool abs_enabled;               // 既定は有効
  // 上位から指令された生の目標車速 (レート制限前)。Drive_SetTargetSpeed が更新する
  float speed_setpoint_m_s;
  float accel_limit_m_s2;  // speed_setpoint_m_s へ向かう加速度の上限 [m/s^2]
  // レート制限後、実際にPIへ渡している目標車速。Drive_Update が毎周期 speed_setpoint_m_s
  // へ accel_limit_m_s2 で近づける
  float target_speed_m_s;
  // 目標車速の傾き [m/s^2] (ローパス後)。加速度フィードフォワードに使う
  float speed_ff_accel_m_s2;
  bool brake_active;      // 真の間は車速制御を止めて制動トルクだけを出す
  float brake_torque_nm;  // 制動時に後輪各輪へ掛ける制動トルク [Nm] (常に正)
  // 真の間は車速PIを迂回し、manual_torque_nm を左右等配分の総駆動トルクとして直接使う
  // (TC/TV は掛けたまま。brake_active の方が優先される)
  bool torque_mode_active;
  float manual_torque_nm;   // torque_mode 中に指令された1輪あたりの駆動トルク [Nm] (負=後退方向)
  bool launch_requested;    // 上位からの要求 (毎周期 Drive_SetLaunch で更新)
  bool launching;           // ローンチコントロールで発進している最中
  bool launch_spent;        // この要求ではもう使った (条件は「ローンチコントロール」の節)
  float launch_time_s;      // 発進を始めてからの時間
  bool side_brake_active;   // 上位からの要求 (毎周期 Drive_SetSideBrake で更新)
  bool side_brake_engaged;  // 実際に位置保持へ入っているか (角度をラッチ済みか)
  float side_brake_target_left_rad;
  float side_brake_target_right_rad;

  // --- 以下は Drive_Update が更新する観測量 (デバッグ・上位への報告用) ---
  // 前輪・後輪の各輪の周速は LPF 後の値。前輪の生の角速度は使わないこと。12bit ADC で 1回転を測るため
  // 1LSB = 2pi/4095 = 1.53mrad で、これを 500us で微分すると 1LSB あたり 3.07rad/s
  // (= 0.09m/s) に化ける。実測ではノイズが ±100mV 程度あり、静止中でも生値は ±12m/s 振れる
  float vehicle_speed_m_s;  // 車体前後方向の速度 (走行距離+加速度計のカルマンフィルタ。舵角で射影済み)
  float yaw_rate_rad_s;         // スリップ率の基準速度を作るのに使ったヨーレート
  bool yaw_rate_measured;       // 上がIMUの実測値か (偽 = 舵角からの幾何計算で代用中)
  float front_speed_left_m_s;   // 左前輪の周速 (射影前。車体速度ではなく車輪自身の軌跡上の速度)
  float front_speed_right_m_s;  // 右前輪の周速
  float rear_speed_left_m_s;    // 左後輪の周速
  float rear_speed_right_m_s;   // 右後輪の周速
  // スリップ率は進行方向が基準 (正 = 空転, 負 = ロック傾向)。上位への報告用で、制御は
  // トルクの向きを基準にしたスリップ速度 (drive.c の SlipSpeedAlongTorque) を見る
  float slip_left;
  float slip_right;
  float slip_ref_left_m_s;  // 左後輪が滑っていなければ出るはずの周速 (スリップの基準)
  float slip_ref_right_m_s;
  TractionLimiter tc_left;
  TractionLimiter tc_right;
  float tc_limit_left_nm;  // 左輪のトルク上限 (働いていなければ DRIVE_MAX_TORQUE_NM)
  float tc_limit_right_nm;
  bool tc_limiting;          // 前周期、いずれかの輪で上限が実際にトルクを削った
  bool wheel_lift_limiting;  // 同 片輪浮き対策の偏差の方が効いていた (または絶対上限で切った)
  SlipLimiter abs;
  float abs_limit_nm;         // 制動トルクの上限 (左右共通。働いていなければ DRIVE_MAX_BRAKE_TORQUE_NM)
  float abs_request_nm;       // ABS に渡した制動トルクの要求 (正。Drive_IsAbsActive の比較用)
  bool abs_in_speed_pi;       // 車速PIの減速に ABS を掛けている (ApplySpeedPiAbs。制動モードでなくても ABS の状態を持ち越す)
  float abs_floor_time_s;     // 上限が DRIVE_ABS_FALLBACK_LIMIT_RATIO 以下に張り付いている継続時間
  bool abs_fallback_latched;  // 真の間はABSを止めて要求どおりに制動する (ブレーキ解除で戻る)
  // 実際にMDへ送った各輪のトルク指令。正 = 駆動、負 = 制動。制動モード (停車保持・
  // Drive_SetBrake) のときは制動トルクを負値として入れるので、符号を見れば駆動しているのか
  // 押さえているのかが上位から区別できる
  float torque_left_nm;
  float torque_right_nm;
  // スリップ制限 (TC・片輪浮き対策・ABS) が絞る前に各輪へ掛けたかったトルク。torque_*_nm との差が
  // 「どれだけ絞ったか」。駆動は TV の左右差を載せた後の値、制動は要求の制動トルク (負値)
  float torque_request_left_nm;
  float torque_request_right_nm;
} Drive;

/**
 * @brief 駆動制御を初期化する。imu は NULL でもよい (旋回時のスリップ率補正精度が落ちる)。
 * 初期化直後は無効状態 (トルク指令を出さない)。
 */
void Drive_Init(Drive* obj, Motors* motors, Encoder* encoder, Steering* steering, Imu* imu);

/**
 * @brief 車速制御・TC を1周期分実行し、後輪MDへのトルク指令を更新する。
 * 実際の送信は Motors_Transmit が行うため、本関数の後に Motors_Transmit を呼ぶこと。
 * フィルタ係数が周期に依存するため、一定周期 (500us = 2kHz 想定) で呼ぶこと。
 */
void Drive_Update(Drive* obj);

/**
 * @brief 調整パラメータを差し替える (上位の CONFIG_SET を毎周期ここへ写す)。
 */
void Drive_SetParams(Drive* obj, const ControlParams* params);

/**
 * @brief 目標車速 [m/s] を設定する (負値で後退)。急な指令変化でタイヤを滑らせないよう、
 * Drive_Update が毎周期 accel_limit_m_s2 で実際の目標車速をこの値へ近づける
 * (段階的な変化は Drive_Update 側の責務で、ここでは目的値を差し替えるだけ)。
 * accel_limit_m_s2 が正ならその値を使う (上限は掛けない。下限 DRIVE_MIN_ACCEL_LIMIT_M_S2)。
 * 0以下を渡すと DRIVE_DEFAULT_ACCEL_M_S2 で代替する (上限0を「制限なし」と誤解させないため)。
 */
void Drive_SetTargetSpeed(Drive* obj, float m_s, float accel_limit_m_s2);

/**
 * @brief ブレーキを掛ける/離す。on の間は車速制御 (PI) を止め、後輪MDを制動モードに切り替えて
 * torque_nm の制動トルクを各輪へ掛ける。torque_nm は 0〜DRIVE_MAX_BRAKE_TORQUE_NM に
 * クランプされる。0 を渡すと制動トルクが 0 = 惰行になるため、上位の指令をそのまま渡す場合は
 * 「未指定 (0) なら既定値」の解釈を呼び出し側で行うこと。
 */
void Drive_SetBrake(Drive* obj, bool on, float torque_nm);

/**
 * @brief 駆動トルクを直接指令する/止める (torque_mode)。on の間は車速制御 (PI) を止め、
 * torque_nm (1輪あたり、負=後退方向) を左右等配分の総駆動トルクとしてそのまま使う。
 * TC/TV は掛けたままにする (空転抑制のため)。brake_active の方が優先されるので、
 * ブレーキと同時に立っていてもこちらは無視される。torque_nm は ±DRIVE_MAX_TORQUE_NM に
 * クランプされる (上位のクランプに頼らない)。
 */
void Drive_SetTorque(Drive* obj, bool on, float torque_nm);

/**
 * @brief ローンチコントロールを要求する/下ろす。on の間、車速指令の目標が実車速より大きく離れた
 * 加速 (発進) で、目標車速のランプと車速PIを迂回し、全開のトルク + TC で目標車速まで加速する
 * (条件は drive.h の「ローンチコントロール」の節)。torque_mode・制動中は何もしない。
 */
void Drive_SetLaunch(Drive* obj, bool on);

/**
 * @brief ローンチコントロールで発進している最中か。
 */
bool Drive_IsLaunchActive(const Drive* obj);

/**
 * @brief サイドブレーキ (位置制御によるパーキングロック) を掛ける/離す。on の間は
 * 車速制御・通常のブレーキ・torque_mode より優先し、有効化された瞬間の後輪機械角度を
 * ラッチして位置制御へ切り替える。MD からの状態フレームが無効 (BldcMotor_IsDataValid が
 * 偽) な間は角度をラッチできないため、有効な角度が取れるまで通常のトルク制動へ
 * フォールバックする。
 */
void Drive_SetSideBrake(Drive* obj, bool on);

/**
 * @brief サイドブレーキが実際に位置制御へ切り替わって機械角度を固定中かを取得する
 * (要求中でもラッチ待ちでフォールバック中の間は偽)。
 */
bool Drive_IsSideBrakeEngaged(const Drive* obj);

/**
 * @brief トルクベクタリングの有効/無効を切り替える (既定は無効)。
 * 無効にすると左右へ常に等トルクを配分する (オープンデフ相当の挙動になる)。
 * 有効にしていても、IMU の実測ヨーレートが得られない間は介入しない。
 */
void Drive_SetTorqueVectoringEnabled(Drive* obj, bool enabled);

/**
 * @brief トラクションコントロール (TC本体、前輪基準のスリップ) の有効/無効を切り替える
 * (既定は無効)。片輪浮き対策 (Drive_SetWheelLiftGuardEnabled) とは独立に切り替わり、両方を
 * 無効にすると各輪のトルク上限は常に DRIVE_MAX_TORQUE_NM になる。
 */
void Drive_SetTractionControlEnabled(Drive* obj, bool enabled);

/**
 * @brief 片輪浮き対策 (後輪左右速度差の異常検知・絶対車輪速上限) の有効/無効を
 * 切り替える (既定は有効)。トラクションコントロール (TC) 本体とは独立に切替可能。
 */
void Drive_SetWheelLiftGuardEnabled(Drive* obj, bool enabled);

/**
 * @brief ABS (制動時の後輪ロック防止) の有効/無効を切り替える (既定は有効)。
 * 無効にすると Drive_SetBrake で指定した制動トルクをそのまま掛ける。
 */
void Drive_SetAbsEnabled(Drive* obj, bool enabled);

/**
 * @brief ABSが今まさに制動トルクを要求より削っているかを取得する (デバッグ・上位への報告用)。
 * 制動モード (Drive_SetBrake) と、車速PIが前進中に減速トルクを出している間の両方。
 * フォールバック中 (ABSを止めて要求どおりに制動している間) は偽。
 */
bool Drive_IsAbsActive(const Drive* obj);

/**
 * @brief トルクベクタリングが今まさに左右へトルク差を付けているかを取得する。
 */
bool Drive_IsTorqueVectoringActive(const Drive* obj);

/**
 * @brief トルクベクタリングの配分の比率 (左右の荷重差 / 荷重和 の見積り。左旋回で正 = 右輪が多い)。
 */
float Drive_GetTvRatio(const Drive* obj);

/**
 * @brief トルクベクタリングが要求した左右トルク差をヨーモーメント [Nm] に換算した値
 * (左旋回方向が正)。実際に付いた左右差は各輪のトルク (Drive_GetTorqueLeft/Right) から分かる。
 */
float Drive_GetTvYawMoment(const Drive* obj);

/**
 * @brief ABS が決めた制動トルクの上限 [Nm] (働いていなければ DRIVE_MAX_BRAKE_TORQUE_NM)。
 */
float Drive_GetAbsLimit(const Drive* obj);

/**
 * @brief スリップ制限が絞る前に左輪へ掛けたかったトルク [Nm] (Drive.torque_request_left_nm 参照)。
 */
float Drive_GetTorqueRequestLeft(const Drive* obj);

/**
 * @brief 同 右輪。
 */
float Drive_GetTorqueRequestRight(const Drive* obj);

/**
 * @brief 駆動制御を有効化する。積分項とTCのトルク上限をリセットしてから開始する。
 */
void Drive_Enable(Drive* obj);

/**
 * @brief 駆動制御を無効化し、トルク 0 を指令する (惰行。送信は止めない)。
 */
void Drive_Disable(Drive* obj);

/**
 * @brief 駆動制御が有効かを取得する。
 */
bool Drive_IsEnabled(const Drive* obj);

/**
 * @brief 車体前後方向の車速 [m/s] を取得する (走行距離+加速度計のカルマンフィルタ。speed_kf.h)。
 * 車速PI・TC/ABS のスリップの基準・自動停止の前後判定のすべてがこれを使う。
 */
float Drive_GetVehicleSpeed(const Drive* obj);

/**
 * @brief カルマンフィルタの加速度 [m/s²] (TELEMETRY で上位に出す)。
 */
float Drive_GetAccelKf(const Drive* obj);

/**
 * @brief KF の一貫性の診断 (NIS と自己相関。speed_kf.h) を取り出し、集計をやり直す。[0]=走行距離、[1]=加速度。
 * TELEMETRY のスナップショットごとに1回だけ呼ぶ (呼ぶたびに前回からの分が消える)。
 */
void Drive_TakeKfDiag(Drive* obj, float nis[SPEED_KF_DIAG_COUNT], float autocorr[SPEED_KF_DIAG_COUNT]);
/** @brief 加速度計バイアスの推定 [m/s²]。 */
float Drive_GetAccelBiasKf(const Drive* obj);
/** @brief 測定を弱めた(ゲートした)累積回数。 */
uint32_t Drive_GetKfGatedCount(const Drive* obj);

/**
 * @brief 前輪の走行距離 [0.1mm] (前進が正。読みの鏡像と折り返しを直した増分の累積)。right が偽なら左
 */
int32_t Drive_GetFrontOdom0p1mm(const Drive* obj, bool right);
/**
 * @brief 前輪の読みの向きを直した回数 (encoder_direction.h。左右の合計)。増えたら上位へ LOG で知らせる
 */
uint32_t Drive_GetFrontReversalCount(const Drive* obj);
/**
 * @brief 前輪の読みの今の向き (+1 = 通常、-1 = 鏡像を直している最中)。right が偽なら左
 */
float Drive_GetFrontEncoderSign(const Drive* obj, bool right);

/**
 * @brief 左後輪のスリップ率を取得する (正 = 空転、負 = ロック傾向)。
 */
float Drive_GetSlipLeft(const Drive* obj);

/**
 * @brief 右後輪のスリップ率を取得する。
 */
float Drive_GetSlipRight(const Drive* obj);

/**
 * @brief TCが動的に決めた左後輪のトルク上限 [Nm] を取得する (デバッグ・上位への報告用)。
 * DRIVE_MAX_TORQUE_NM が「制限なし」、それより小さければ介入中を意味する。
 */
float Drive_GetTcLimitLeft(const Drive* obj);

/**
 * @brief TCが動的に決めた右後輪のトルク上限 [Nm] を取得する。
 */
float Drive_GetTcLimitRight(const Drive* obj);

/**
 * @brief いずれかの後輪でTC(本体)が介入中かを取得する。
 */
bool Drive_IsTractionControlActive(const Drive* obj);

/**
 * @brief いずれかの後輪で片輪浮き対策が介入中かを取得する (デバッグ・上位への報告用)。
 */
bool Drive_IsWheelLiftGuardActive(const Drive* obj);

/**
 * @brief 実際にMDへ送った左輪トルク指令 [Nm] を取得する。
 */
float Drive_GetTorqueLeft(const Drive* obj);

/**
 * @brief 実際にMDへ送った右輪トルク指令 [Nm] を取得する。
 */
float Drive_GetTorqueRight(const Drive* obj);

#endif  // DRIVE_H_
