banbatakumi/AutonomousCar/Program/MainF446RE_V3/src/lighting/lighting.c

#include "lighting.h"

#define LIGHTING_DAYTIME_DUTY 0.1f
#define LIGHTING_TAILLIGHT_DUTY 0.1f
// 停車保持中 (フェイルセーフで止まっている間) のブレーキ灯 duty。尾灯 (0.1) より明るく
// 「ブレーキが掛かっている」ことは分かる程度に抑える。Pi 未接続・起動中・通信途絶の間は
// フェイルセーフで常時点灯するため、全光量のままだと待機中の消費が無駄に大きい (省電力)
#define LIGHTING_BRAKE_HOLD_DUTY 0.3f
// ウィンカーの最低 duty (省電力用の下限。前後灯がこれより暗ければこの値まで持ち上げる)
#define LIGHTING_WINKER_MIN_DUTY 0.5f

// マツダ車のような上品な点滅を再現するため、単純な on/off ではなく
// 「素早く点灯 → 一定時間保持 → ゆっくり消灯 → 間隔を空ける」の
// 4 フェーズで duty を連続的に変化させる。
#define LIGHTING_WINKER_FADE_IN_MS 50u
#define LIGHTING_WINKER_HOLD_MS 300u
#define LIGHTING_WINKER_FADE_OUT_MS 100u
#define LIGHTING_WINKER_GAP_MS 500u
#define LIGHTING_WINKER_PERIOD_MS \
  (LIGHTING_WINKER_FADE_IN_MS + LIGHTING_WINKER_HOLD_MS + LIGHTING_WINKER_FADE_OUT_MS + LIGHTING_WINKER_GAP_MS)

#define LIGHTING_BRAKE_FLASH_ON_MS 125u
#define LIGHTING_BRAKE_FLASH_OFF_MS 125u
#define LIGHTING_BRAKE_FLASH_PERIOD_MS (LIGHTING_BRAKE_FLASH_ON_MS + LIGHTING_BRAKE_FLASH_OFF_MS)

// elapsed_ms (1周期内, 0 <= elapsed_ms < PERIOD_MS) における duty を返す。
static float Lighting_WinkerDutyAt(uint32_t elapsed_ms) {
  if (elapsed_ms < LIGHTING_WINKER_FADE_IN_MS) {
    return (float)elapsed_ms / LIGHTING_WINKER_FADE_IN_MS;
  }
  elapsed_ms -= LIGHTING_WINKER_FADE_IN_MS;

  if (elapsed_ms < LIGHTING_WINKER_HOLD_MS) {
    return 1.0f;
  }
  elapsed_ms -= LIGHTING_WINKER_HOLD_MS;

  if (elapsed_ms < LIGHTING_WINKER_FADE_OUT_MS) {
    return 1.0f - (float)elapsed_ms / LIGHTING_WINKER_FADE_OUT_MS;
  }

  return 0.0f;
}

static uint32_t Lighting_WinkerPeriod(const Lighting* obj) {
  if (obj->winker_mode == LIGHTING_WINKER_MODE_NORMAL) return 1000u;
  if (obj->winker_mode == LIGHTING_WINKER_MODE_BULB) return 1000u;
  return LIGHTING_WINKER_PERIOD_MS;
}

static float Lighting_ModeDutyAt(const Lighting* obj, uint32_t elapsed_ms) {
  if (obj->winker_mode == LIGHTING_WINKER_MODE_NORMAL)
    return elapsed_ms < 500u ? 1.0f : 0.0f;
  if (obj->winker_mode == LIGHTING_WINKER_MODE_BULB) {
    // Incandescent filament has a slower thermal rise and a quicker decay than LED PWM.
    if (elapsed_ms < 140u) {
      float x = (float)elapsed_ms / 140.0f;
      return x * x;
    }
    if (elapsed_ms < 500u) return 1.0f;
    if (elapsed_ms < 590u) return 1.0f - (float)(elapsed_ms - 500u) / 90.0f;
    return 0.0f;
  }
  return Lighting_WinkerDutyAt(elapsed_ms);
}

// 前後灯 (前照灯・尾灯/ブレーキ灯) が眩しく点いている間はウィンカーが埋もれないよう、
// その実効 duty に合わせて底上げする。左右ウィンカーは前後共有の1灯のため前後どちらの
// duty が高くても埋もれ得るので、両方の大きい方を見る。両方とも暗いとき (前照灯 OFF かつ
// ブレーキ非点灯) は視認性を落とさない範囲で LIGHTING_WINKER_MIN_DUTY まで省電力化する
static float Lighting_WinkerPeakDuty(const Lighting* obj) {
  // brake_flashing 中 (緊急制動) の rear_light_duty は LIGHTING_BRAKE_FLASH_PERIOD_MS (250ms)
  // 周期で 1.0/0.0(またはLIGHTING_TAILLIGHT_DUTY) を振動する瞬時値。これをそのまま基準にすると
  // ハザードとの同時発生時にウィンカーの明るさがブレーキ点滅レートでビートを打ってしまう
  // (どちらも独立した周期の点滅のため)。点滅の山では結局1.0まで明るくなる想定なので、
  // 瞬時値ではなく点滅ピーク相当の1.0で代用し、ウィンカー側の duty を安定させる
  float rear_reference = obj->brake_flashing ? 1.0f : obj->rear_light_duty;
  float duty = obj->front_light_duty > rear_reference ? obj->front_light_duty : rear_reference;
  return duty > LIGHTING_WINKER_MIN_DUTY ? duty : LIGHTING_WINKER_MIN_DUTY;
}

// パッシング中は前照灯だけを全光量にする。尾灯を連動させないのは、消灯状態でパッシングした
// ときに尾灯まで一緒に瞬くと後続車から見て制動と紛らわしいため
static void Lighting_ApplyFrontLight(Lighting* obj) {
  float duty = 0.0f;
  if (obj->passing_on || obj->headlight_mode == LIGHTING_HEADLIGHT_NORMAL) {
    duty = 1.0f;
  } else if (obj->headlight_mode == LIGHTING_HEADLIGHT_DAYTIME) {
    duty = LIGHTING_DAYTIME_DUTY;
  }
  obj->front_light_duty = duty;
  PwmOut_Write(&obj->front_light, duty);
}

static void Lighting_ApplyRearLight(Lighting* obj) {
  float duty = 0.0f;
  if (obj->brake_on) {
    if (obj->brake_flashing) {
      uint32_t elapsed_ms = Timer_ReadMs(&obj->brake_flash_timer);
      if (elapsed_ms >= LIGHTING_BRAKE_FLASH_PERIOD_MS) {
        Timer_Reset(&obj->brake_flash_timer);
        elapsed_ms = 0;
      }
      duty = elapsed_ms < LIGHTING_BRAKE_FLASH_ON_MS ? 1.0f : 0.0f;
      if (duty == 0.0f && obj->headlight_mode != LIGHTING_HEADLIGHT_OFF) {
        duty = LIGHTING_TAILLIGHT_DUTY;
      }
    } else {
      duty = obj->brake_dimmed ? LIGHTING_BRAKE_HOLD_DUTY : 1.0f;
    }
  } else if (obj->headlight_mode != LIGHTING_HEADLIGHT_OFF) {
    duty = LIGHTING_TAILLIGHT_DUTY;
  }
  obj->rear_light_duty = duty;
  PwmOut_Write(&obj->rear_light, duty);
}

void Lighting_Init(Lighting* obj, TIM_HandleTypeDef* front_htim, uint32_t front_channel,
                   TIM_HandleTypeDef* rear_htim, uint32_t rear_channel,
                   TIM_HandleTypeDef* left_htim, uint32_t left_channel,
                   TIM_HandleTypeDef* right_htim, uint32_t right_channel) {
  PwmOut_Init(&obj->front_light, front_htim, front_channel);
  PwmOut_Init(&obj->rear_light, rear_htim, rear_channel);
  PwmOut_Init(&obj->left_winker, left_htim, left_channel);
  PwmOut_Init(&obj->right_winker, right_htim, right_channel);

  obj->headlight_mode = LIGHTING_HEADLIGHT_OFF;
  obj->passing_on = false;
  obj->brake_on = false;
  obj->brake_flashing = false;
  obj->brake_dimmed = false;
  obj->winker_state = LIGHTING_WINKER_OFF;
  obj->winker_mode = LIGHTING_WINKER_MODE_SMOOTH;
  obj->front_light_duty = 0.0f;
  obj->rear_light_duty = 0.0f;

  PwmOut_Write(&obj->front_light, 0.0f);
  PwmOut_Write(&obj->rear_light, 0.0f);
  PwmOut_Write(&obj->left_winker, 0.0f);
  PwmOut_Write(&obj->right_winker, 0.0f);

  Timer_Init(&obj->winker_timer);
  Timer_Init(&obj->brake_flash_timer);
}

void Lighting_SetHeadlight(Lighting* obj, LightingHeadlightMode mode) {
  obj->headlight_mode = mode;
  Lighting_ApplyFrontLight(obj);
  Lighting_ApplyRearLight(obj);
}

void Lighting_SetPassing(Lighting* obj, bool on) {
  obj->passing_on = on;
  Lighting_ApplyFrontLight(obj);
}

void Lighting_SetBrake(Lighting* obj, bool on) {
  Lighting_SetBrakeMode(obj, on, false);
}

void Lighting_SetBrakeMode(Lighting* obj, bool on, bool flashing) {
  flashing = on && flashing;
  if (flashing && !obj->brake_flashing) {
    Timer_Reset(&obj->brake_flash_timer);
  }
  obj->brake_on = on;
  obj->brake_flashing = flashing;
  Lighting_ApplyRearLight(obj);
}

void Lighting_SetBrakeDimmed(Lighting* obj, bool dimmed) {
  if (obj->brake_dimmed == dimmed) return;
  obj->brake_dimmed = dimmed;
  Lighting_ApplyRearLight(obj);
}

void Lighting_SetBrakeFlashing(Lighting* obj, bool on) {
  Lighting_SetBrakeMode(obj, obj->brake_on || on, on);
}

void Lighting_SetWinker(Lighting* obj, LightingWinkerState state) {
  if (obj->winker_state == state) {
    return;
  }
  obj->winker_state = state;
  Timer_Reset(&obj->winker_timer);

  if (state == LIGHTING_WINKER_OFF) {
    PwmOut_Write(&obj->left_winker, 0.0f);
    PwmOut_Write(&obj->right_winker, 0.0f);
  }
}

void Lighting_SetWinkerMode(Lighting* obj, LightingWinkerMode mode) {
  if (mode < LIGHTING_WINKER_MODE_NORMAL || mode > LIGHTING_WINKER_MODE_BULB) return;
  if (obj->winker_mode == mode) return;
  obj->winker_mode = mode;
  Timer_Reset(&obj->winker_timer);
}

void Lighting_Update(Lighting* obj) {
  if (obj->brake_on && obj->brake_flashing) {
    Lighting_ApplyRearLight(obj);
  }

  if (obj->winker_state == LIGHTING_WINKER_OFF) {
    return;
  }

  uint32_t elapsed_ms = Timer_ReadMs(&obj->winker_timer);
  uint32_t period_ms = Lighting_WinkerPeriod(obj);
  if (elapsed_ms >= period_ms) {
    Timer_Reset(&obj->winker_timer);
    elapsed_ms = 0;
  }
  float duty = Lighting_ModeDutyAt(obj, elapsed_ms) * Lighting_WinkerPeakDuty(obj);

  float left_duty = 0.0f;
  float right_duty = 0.0f;
  if (obj->winker_state == LIGHTING_WINKER_LEFT || obj->winker_state == LIGHTING_WINKER_HAZARD) {
    left_duty = duty;
  }
  if (obj->winker_state == LIGHTING_WINKER_RIGHT || obj->winker_state == LIGHTING_WINKER_HAZARD) {
    right_duty = duty;
  }
  PwmOut_Write(&obj->left_winker, left_duty);
  PwmOut_Write(&obj->right_winker, right_duty);
}

LightingWinkerState Lighting_GetWinkerState(const Lighting* obj) { return obj->winker_state; }

uint32_t Lighting_GetWinkerPeriodMs(void) {
  return LIGHTING_WINKER_PERIOD_MS;
}
