banbatakumi/AutonomousCar/Program/MainF446RE_V3/src/sensing/imu.c

#include "imu.h"

#include <math.h>
#include <stdio.h>
#include <string.h>

#include "flash.h"

// サンプリング設定。ジャイロは TC・TV の制御に、加速度は車速のカルマンフィルタに使うので、
// 遅れの少ない DLPF 94Hz (遅れ約3ms。21Hz だと約8.5ms) で 200Hz で取り込む。
// 静止ノイズの実測では 21Hz → 94Hz でジャイロ z が 0.029 → 0.042 deg/s、加速度 x が
// 0.011 → 0.020 m/s² と、制御に対して無視できる増え方だった
#define IMU_SAMPLE_RATE_HZ 200
#define IMU_DLPF MPU6050_DLPF_BW_94HZ

// Mahony フィルタのゲイン。Kp を小さめにして加減速の影響を受けにくくし、
// Ki で残留バイアスをゆっくり吸収する。
#define IMU_AHRS_KP 0.5f
#define IMU_AHRS_KI 0.01f

// 加速度出力のローパス係数 (0<k<1)。200Hz サンプルで実効カットオフ ≒ 7Hz。
#define IMU_ACCEL_LPF_K 0.8f

// 静止キャリブレーションのサンプル数 (200Hz なので約 5 秒)
#define IMU_CALIB_SAMPLE_COUNT 1000

// 静止判定のしきい値と、静止と認めるまでの連続サンプル数 (200Hz で約 0.5 秒)
#define IMU_STATIONARY_GYRO_DPS 1.5f
#define IMU_STATIONARY_ACCEL_TOL_MPS2 0.25f
#define IMU_STATIONARY_HOLD_SAMPLES 100

// 静止中にジャイロ残留バイアスへ追従する速さ (200Hz で時定数 ≒ 2.5 秒)
#define IMU_BIAS_TRACK_GAIN 0.002f

// 通信断とみなすまでの無サンプル時間と、復旧を試みる間隔
#define IMU_SAMPLE_TIMEOUT_MS 250U
#define IMU_RECOVERY_INTERVAL_MS 500U

// I2C1 のピン (Core/Src/i2c.c の HAL_I2C_MspInit と一致させること)
#define IMU_I2C_SCL_PORT GPIOB
#define IMU_I2C_SCL_PIN GPIO_PIN_8
#define IMU_I2C_SDA_PORT GPIOB
#define IMU_I2C_SDA_PIN GPIO_PIN_9

// Flash に保存するキャリブレーションデータ
typedef struct {
  uint32_t magic;
  uint32_t version;
  Mpu6050Offset offset;
  uint32_t checksum;
} ImuCalibrationRecord;

#define IMU_CALIB_MAGIC 0x4D505536UL  // "MPU6"
// 3: ジャイロのレンジを ±250 → ±500 deg/s に広げた (オフセットは LSB 単位なので意味が変わる)
#define IMU_CALIB_VERSION 3UL
// ジャイロのオフセットが ±250 deg/s の LSB で保存されている版。読むときに換算する
#define IMU_CALIB_VERSION_GYRO_250DPS 2UL

// INT ピン (PC5) の EXTI 設定は CubeMX 側 (.ioc -> MX_GPIO_Init) が行う。
// EXTI9_5 は後方超音波の ECHO ピン (PC9) と割り込みベクタを共有するため、
// NVIC ごと止めずに EXTI のマスクレジスタで PC5 のラインだけを開閉する。
static void EnableDataReadyInterrupt(bool enable) {
  if (enable) {
    __HAL_GPIO_EXTI_CLEAR_IT(INT_Pin);
    EXTI->IMR |= INT_Pin;
  } else {
    EXTI->IMR &= ~INT_Pin;
  }
}

// MCU だけがリセットされると、MPU6050 が送信途中のまま SDA を Low に保持して
// バスがロックすることがある。SCL を手動で 9 回叩いて転送を完了させ、STOP を出して解放する。
static void RecoverI2cBus(I2C_HandleTypeDef *i2c) {
  HAL_I2C_DeInit(i2c);
  HAL_Delay(5);

  GPIO_InitTypeDef gpio = {0};
  gpio.Pin = IMU_I2C_SCL_PIN;
  gpio.Mode = GPIO_MODE_OUTPUT_OD;
  gpio.Pull = GPIO_NOPULL;
  gpio.Speed = GPIO_SPEED_FREQ_LOW;
  HAL_GPIO_Init(IMU_I2C_SCL_PORT, &gpio);
  HAL_GPIO_WritePin(IMU_I2C_SCL_PORT, IMU_I2C_SCL_PIN, GPIO_PIN_SET);

  gpio.Pin = IMU_I2C_SDA_PIN;
  gpio.Mode = GPIO_MODE_INPUT;
  gpio.Pull = GPIO_PULLUP;
  HAL_GPIO_Init(IMU_I2C_SDA_PORT, &gpio);

  for (int i = 0; i < 9; i++) {
    HAL_GPIO_WritePin(IMU_I2C_SCL_PORT, IMU_I2C_SCL_PIN, GPIO_PIN_RESET);
    HAL_Delay(1);
    HAL_GPIO_WritePin(IMU_I2C_SCL_PORT, IMU_I2C_SCL_PIN, GPIO_PIN_SET);
    HAL_Delay(1);
    if (HAL_GPIO_ReadPin(IMU_I2C_SDA_PORT, IMU_I2C_SDA_PIN) == GPIO_PIN_SET) break;
  }

  // STOP コンディション: SCL が High の間に SDA を Low -> High
  gpio.Pin = IMU_I2C_SDA_PIN;
  gpio.Mode = GPIO_MODE_OUTPUT_OD;
  gpio.Pull = GPIO_NOPULL;
  HAL_GPIO_Init(IMU_I2C_SDA_PORT, &gpio);
  HAL_GPIO_WritePin(IMU_I2C_SDA_PORT, IMU_I2C_SDA_PIN, GPIO_PIN_RESET);
  HAL_Delay(1);
  HAL_GPIO_WritePin(IMU_I2C_SCL_PORT, IMU_I2C_SCL_PIN, GPIO_PIN_SET);
  HAL_Delay(1);
  HAL_GPIO_WritePin(IMU_I2C_SDA_PORT, IMU_I2C_SDA_PIN, GPIO_PIN_SET);
  HAL_Delay(1);

  // MspInit がピンを AF に設定し直せるよう GPIO を戻してから再初期化する
  HAL_GPIO_DeInit(IMU_I2C_SCL_PORT, IMU_I2C_SCL_PIN);
  HAL_GPIO_DeInit(IMU_I2C_SDA_PORT, IMU_I2C_SDA_PIN);
  HAL_I2C_Init(i2c);
  HAL_Delay(10);
}

static uint32_t ComputeChecksum(const ImuCalibrationRecord *record) {
  return record->magic ^ record->version ^
         (uint32_t)(uint16_t)record->offset.gyro_x ^
         (uint32_t)(uint16_t)record->offset.gyro_y ^
         (uint32_t)(uint16_t)record->offset.gyro_z ^
         (uint32_t)(uint16_t)record->offset.accel_x ^
         (uint32_t)(uint16_t)record->offset.accel_y ^
         (uint32_t)(uint16_t)record->offset.accel_z ^ 0xA5A5A5A5UL;
}

static bool LoadCalibration(Mpu6050Offset *out) {
  ImuCalibrationRecord record = {0};
  Flash_ReadData(FLASH_MPU_START_ADDR, &record, sizeof(record));
  if (record.magic != IMU_CALIB_MAGIC) return false;
  if (record.version != IMU_CALIB_VERSION && record.version != IMU_CALIB_VERSION_GYRO_250DPS) {
    return false;
  }
  if (record.checksum != ComputeChecksum(&record)) return false;
  *out = record.offset;
  if (record.version == IMU_CALIB_VERSION_GYRO_250DPS) {
    // 同じバイアス [deg/s] は ±500 deg/s のレンジでは半分の LSB になる。較正し直させずに
    // 引き継ぐ (読み捨てるとオフセット 0 で起動し、数 deg/s のバイアスがヨーレートに乗る)
    out->gyro_x = (int16_t)(out->gyro_x / 2);
    out->gyro_y = (int16_t)(out->gyro_y / 2);
    out->gyro_z = (int16_t)(out->gyro_z / 2);
  }
  return true;
}

static bool SaveCalibration(const Mpu6050Offset *offset) {
  ImuCalibrationRecord record = {
      .magic = IMU_CALIB_MAGIC,
      .version = IMU_CALIB_VERSION,
      .offset = *offset,
  };
  record.checksum = ComputeChecksum(&record);
  return Flash_WriteDataToSector(FLASH_MPU_START_ADDR, FLASH_MPU_SECTOR,
                                 FLASH_MPU_VOLTAGE_RANGE, &record,
                                 sizeof(record)) == HAL_OK;
}

typedef struct {
  float x, y, z;
} ImuVec3;

// チップ座標系 -> 機体座標系 (X=前方 / Y=左方 / Z=上方) の変換。
// この機体の MPU6050 は基板に 90° 回して裏向きに実装されているため、
// 単なる軸の符号反転では表せず、X と Y の入れ替えが必要になる。
//   機体X(前) = -chip_y,  機体Y(左) = -chip_x,  機体Z(上) = -chip_z
//
// ({+chip_y, +chip_x, -chip_z} は X/Y が逆で誤り。システム同定ログで確認: 前進加速で accel_x<0、
// 左旋回で accel_y<0 になる。)
// pitch は Ahrs が右手系 (機首下げが正) で返すため、ProcessSample で符号を反転して
// 「機首上げが正」にそろえている。
//
// 基板を張り替えたときの確認手順 (Imu_Init が起動時にチップ座標系の加速度を表示する):
//   1. 水平に置いて静止 -> chip az の符号が機体Z(上)の向きを決める (+9.8 なら +chip_z)
//   2. 機首を持ち上げる -> 大きく振れた軸が機体X(前)。機首上げで機体X の加速度が
//      正になるように符号を選ぶ (加速度は比力: 上向きに +g が乗る)
//   3. 残った軸が機体Y。3軸の変換行列の行列式が +1 (右手系のまま) になるよう符号を決める
//   4. 実走で確認: 前進加速で accel_x > 0、左旋回で accel_y > 0、yaw_rate > 0
// 行列式が -1 (鏡像) になる組み合わせを選ぶと、Mahony フィルタが鏡像姿勢に収束して
// 「静止しているのに roll が 180° 付近」「回転させると一瞬逆に動く」といった症状が出る。
static ImuVec3 ChipToBody(float chip_x, float chip_y, float chip_z) {
  ImuVec3 body = {-chip_y, -chip_x, -chip_z};
  return body;
}

static void ResetAccelFilters(Imu *obj, const Mpu6050Sample *initial) {
  ImuVec3 accel = {0.0f, 0.0f, 0.0f};
  if (initial != NULL) {
    accel = ChipToBody(initial->accel_x, initial->accel_y, initial->accel_z);
  }
  LPF_Init(&obj->lpf_accel_x, IMU_ACCEL_LPF_K, accel.x);
  LPF_Init(&obj->lpf_accel_y, IMU_ACCEL_LPF_K, accel.y);
  LPF_Init(&obj->lpf_accel_z, IMU_ACCEL_LPF_K, accel.z);
}

// 加速度から初期姿勢を決めて、水平へ収束するまでの待ち時間をなくす
static void PrimeOrientation(Imu *obj) {
  Mpu6050Sample sample;
  if (!Mpu6050_ReadBlocking(&obj->mpu, &sample)) {
    ResetAccelFilters(obj, NULL);
    return;
  }
  ImuVec3 accel = ChipToBody(sample.accel_x, sample.accel_y, sample.accel_z);
  Ahrs_SetFromAccel(&obj->ahrs, accel.x, accel.y, accel.z);
  ResetAccelFilters(obj, &sample);
}

static float NormalizeDeg(float deg) {
  while (deg < -180.0f) deg += 360.0f;
  while (deg >= 180.0f) deg -= 360.0f;
  return deg;
}

// 静止していれば残留ジャイロバイアスへゆっくり追従する。
// 起動時キャリブレーション後も温度変化でバイアスがずれ、それが yaw のドリフトになるため。
static void TrackGyroBias(Imu *obj, float gx, float gy, float gz, float accel_norm) {
  // 車が動いている間は追従しない。ゆっくりした旋回 (定常円旋回の低速など) や振動の少ない
  // 一定速度の走行を「静止」と取り違えると、本物のヨーレートをバイアスとして学習してしまう。
  // 車速は前輪エンコーダ (Imu_SetVehicleStill)
  bool quiet = obj->vehicle_still && fabsf(gx) < IMU_STATIONARY_GYRO_DPS &&
               fabsf(gy) < IMU_STATIONARY_GYRO_DPS &&
               fabsf(gz) < IMU_STATIONARY_GYRO_DPS &&
               fabsf(accel_norm - AHRS_GRAVITY_MPS2) < IMU_STATIONARY_ACCEL_TOL_MPS2;

  if (!quiet) {
    obj->stationary_count = 0;
    obj->data.stationary = false;
    return;
  }

  if (obj->stationary_count < IMU_STATIONARY_HOLD_SAMPLES) {
    obj->stationary_count++;
    return;
  }

  obj->data.stationary = true;
  obj->gyro_bias_x += IMU_BIAS_TRACK_GAIN * gx;
  obj->gyro_bias_y += IMU_BIAS_TRACK_GAIN * gy;
  obj->gyro_bias_z += IMU_BIAS_TRACK_GAIN * gz;
}

static void ProcessSample(Imu *obj, const Mpu6050Sample *sample, float dt) {
  ImuVec3 accel = ChipToBody(sample->accel_x, sample->accel_y, sample->accel_z);
  ImuVec3 gyro = ChipToBody(sample->gyro_x, sample->gyro_y, sample->gyro_z);

  float ax = accel.x;
  float ay = accel.y;
  float az = accel.z;
  float gx = gyro.x - obj->gyro_bias_x;
  float gy = gyro.y - obj->gyro_bias_y;
  float gz_raw = gyro.z - obj->gyro_bias_z;

  float accel_norm = sqrtf(ax * ax + ay * ay + az * az);
  // バイアスの学習は補正前の値で (バイアスはセンサの読みの単位で持つ)
  TrackGyroBias(obj, gx, gy, gz_raw, accel_norm);
  // 感度の補正 (上位が送る。既定 1)
  float gz = gz_raw * obj->gyro_z_scale;

  Ahrs_Update(&obj->ahrs, gx, gy, gz, ax, ay, az, dt);

  obj->data.yaw = NormalizeDeg(obj->ahrs.yaw - obj->yaw_offset);
  // Ahrs は右手系 (Y 左まわりで機首下げが正)。機首上げが正になるよう反転する
  obj->data.pitch = -obj->ahrs.pitch;
  obj->data.roll = obj->ahrs.roll;

  obj->data.gyro_x = gx;
  obj->data.gyro_y = gy;
  obj->data.gyro_z = gz;

  obj->data.accel_x_raw = ax;
  obj->data.sample_seq++;

  obj->data.accel_x = (float)LPF_Update(&obj->lpf_accel_x, ax);
  obj->data.accel_y = (float)LPF_Update(&obj->lpf_accel_y, ay);
  obj->data.accel_z = (float)LPF_Update(&obj->lpf_accel_z, az);

  // 推定姿勢から重力の向きを求めて差し引き、機体の並進加速度だけを取り出す
  float grav_x, grav_y, grav_z;
  Ahrs_GetGravityDirection(&obj->ahrs, &grav_x, &grav_y, &grav_z);
  obj->data.linear_accel_x = obj->data.accel_x - grav_x * AHRS_GRAVITY_MPS2;
  obj->data.linear_accel_y = obj->data.accel_y - grav_y * AHRS_GRAVITY_MPS2;
  obj->data.linear_accel_z = obj->data.accel_z - grav_z * AHRS_GRAVITY_MPS2;

  obj->data.temp = sample->temp;
}

// ---------------------------------------------------------------------------
// 通信が止まったときの復旧 (I2C バスの解放 → MPU6050 の初期化し直し)
//
// 手順は起動時 (RecoverI2cBus + Mpu6050_Init) と同じだが、待ち時間 (合計約190ms) を HAL_Delay で
// 待たず、Imu_Update のたびに1段階ずつ進める。ブロッキングで実行すると、走行中に
// IMU の配線が接触不良を起こしたとき 500ms ごとに 190ms 制御ループが止まり、MD への指令が
// 更新されず COMMAND の途絶判定 100ms も超える。
// 1段階は I2C 1〜2 往復か GPIO の操作だけ。応答が無いときに止まる時間は
// IMU_RECOVERY_IO_TIMEOUT_MS で縛る
// ---------------------------------------------------------------------------
typedef enum {
  IMU_RECOVERY_IDLE = 0,
  IMU_RECOVERY_BUS_RELEASE,    // SCL を手動で叩いて、SDA を握ったままの MPU6050 に離させる
  IMU_RECOVERY_BUS_STOP,       // STOP コンディションを出して I2C を初期化し直す
  IMU_RECOVERY_DEVICE_RESET,   // MPU6050 をリセット
  IMU_RECOVERY_DEVICE_WAKE,    // スリープ解除
  IMU_RECOVERY_DEVICE_CONFIG,  // レジスタを1つずつ設定
  IMU_RECOVERY_FINISH,
} ImuRecoveryState;

#define IMU_RECOVERY_IO_TIMEOUT_MS 2U
// 1段階がこれ以上メインループを止めたら recovery_blocked を立てる
#define IMU_RECOVERY_BLOCK_NOTIFY_MS 5U
#define IMU_RECOVERY_SCL_PULSES 9

// 次の段階へ進むのを ms 以上待つ (HAL_GetTick は 1ms 刻みなので 1 余分に待つ)
static void RecoveryWait(Imu *obj, uint32_t ms) {
  obj->recovery_wait_tick = HAL_GetTick() + ms + 1U;
}

static void StartRecovery(Imu *obj) {
  EnableDataReadyInterrupt(false);
  obj->data_valid = false;
  HAL_I2C_Master_Abort_IT(obj->i2c, (uint16_t)(obj->i2c_addr << 1));
  HAL_I2C_DeInit(obj->i2c);
  obj->recovery_state = IMU_RECOVERY_BUS_RELEASE;
  obj->recovery_step = 0;
  RecoveryWait(obj, 5);
}

static void FailRecovery(Imu *obj) {
  printf("[IMU] Recovery failed\n");
  obj->recovery_state = IMU_RECOVERY_IDLE;
  obj->last_recovery_tick = HAL_GetTick();
}

static void StepRecovery(Imu *obj) {
  if ((int32_t)(HAL_GetTick() - obj->recovery_wait_tick) < 0) return;

  uint32_t step_start_tick = HAL_GetTick();
  GPIO_InitTypeDef gpio = {0};

  switch (obj->recovery_state) {
    case IMU_RECOVERY_BUS_RELEASE:
      if (obj->recovery_step == 0) {
        gpio.Pin = IMU_I2C_SCL_PIN;
        gpio.Mode = GPIO_MODE_OUTPUT_OD;
        gpio.Pull = GPIO_NOPULL;
        gpio.Speed = GPIO_SPEED_FREQ_LOW;
        HAL_GPIO_Init(IMU_I2C_SCL_PORT, &gpio);
        HAL_GPIO_WritePin(IMU_I2C_SCL_PORT, IMU_I2C_SCL_PIN, GPIO_PIN_SET);

        gpio.Pin = IMU_I2C_SDA_PIN;
        gpio.Mode = GPIO_MODE_INPUT;
        gpio.Pull = GPIO_PULLUP;
        HAL_GPIO_Init(IMU_I2C_SDA_PORT, &gpio);
      } else if (obj->recovery_step % 2 == 1) {
        // 奇数段は SCL が High になって 1ms 経ったところ。1回以上叩いて SDA が離されたか、
        // 叩き切ったら STOP へ進む
        bool sda_released = HAL_GPIO_ReadPin(IMU_I2C_SDA_PORT, IMU_I2C_SDA_PIN) == GPIO_PIN_SET;
        if (obj->recovery_step > 1 &&
            (sda_released || obj->recovery_step > 2 * IMU_RECOVERY_SCL_PULSES)) {
          obj->recovery_state = IMU_RECOVERY_BUS_STOP;
          obj->recovery_step = 0;
          return;
        }
        HAL_GPIO_WritePin(IMU_I2C_SCL_PORT, IMU_I2C_SCL_PIN, GPIO_PIN_RESET);
      } else {
        HAL_GPIO_WritePin(IMU_I2C_SCL_PORT, IMU_I2C_SCL_PIN, GPIO_PIN_SET);
      }
      obj->recovery_step++;
      RecoveryWait(obj, 1);
      break;

    case IMU_RECOVERY_BUS_STOP:
      // STOP コンディション: SCL が High の間に SDA を Low -> High
      switch (obj->recovery_step) {
        case 0:
          gpio.Pin = IMU_I2C_SDA_PIN;
          gpio.Mode = GPIO_MODE_OUTPUT_OD;
          gpio.Pull = GPIO_NOPULL;
          gpio.Speed = GPIO_SPEED_FREQ_LOW;
          HAL_GPIO_Init(IMU_I2C_SDA_PORT, &gpio);
          HAL_GPIO_WritePin(IMU_I2C_SDA_PORT, IMU_I2C_SDA_PIN, GPIO_PIN_RESET);
          break;
        case 1:
          HAL_GPIO_WritePin(IMU_I2C_SCL_PORT, IMU_I2C_SCL_PIN, GPIO_PIN_SET);
          break;
        case 2:
          HAL_GPIO_WritePin(IMU_I2C_SDA_PORT, IMU_I2C_SDA_PIN, GPIO_PIN_SET);
          break;
        default:
          // MspInit がピンを AF に設定し直せるよう GPIO を戻してから再初期化する
          HAL_GPIO_DeInit(IMU_I2C_SCL_PORT, IMU_I2C_SCL_PIN);
          HAL_GPIO_DeInit(IMU_I2C_SDA_PORT, IMU_I2C_SDA_PIN);
          HAL_I2C_Init(obj->i2c);
          obj->recovery_state = IMU_RECOVERY_DEVICE_RESET;
          RecoveryWait(obj, 10);
          return;
      }
      obj->recovery_step++;
      RecoveryWait(obj, 1);
      break;

    case IMU_RECOVERY_DEVICE_RESET:
      if (!Mpu6050_BeginInit(&obj->mpu, obj->i2c, obj->i2c_addr, IMU_SAMPLE_RATE_HZ, IMU_DLPF,
                             IMU_RECOVERY_IO_TIMEOUT_MS, 1)) {
        FailRecovery(obj);
        break;
      }
      obj->recovery_state = IMU_RECOVERY_DEVICE_WAKE;
      RecoveryWait(obj, MPU6050_RESET_WAIT_MS);
      break;

    case IMU_RECOVERY_DEVICE_WAKE:
      if (!Mpu6050_WakeUp(&obj->mpu)) {
        FailRecovery(obj);
        break;
      }
      obj->recovery_state = IMU_RECOVERY_DEVICE_CONFIG;
      obj->recovery_step = 0;
      RecoveryWait(obj, MPU6050_WAKE_WAIT_MS);  // PLL のロック待ち
      break;

    case IMU_RECOVERY_DEVICE_CONFIG: {
      bool ok = true;
      if (!Mpu6050_ConfigureStep(&obj->mpu, &obj->recovery_step, &ok)) break;
      if (!ok) {
        FailRecovery(obj);
        break;
      }
      obj->recovery_state = IMU_RECOVERY_FINISH;
      break;
    }

    case IMU_RECOVERY_FINISH:
    default:
      // Mpu6050_BeginInit が作り直したので、オフセットを戻す
      Mpu6050_SetOffset(&obj->mpu, &obj->calib_offset);
      PrimeOrientation(obj);
      Mpu6050_SetIoTimeout(&obj->mpu, MPU6050_IO_TIMEOUT_MS, MPU6050_IO_RETRY_COUNT);
      obj->i2c_addr = obj->mpu.i2c_addr;
      obj->recovery_state = IMU_RECOVERY_IDLE;
      obj->last_sample_tick = HAL_GetTick();
      obj->last_recovery_tick = obj->last_sample_tick;
      EnableDataReadyInterrupt(true);
      printf("[IMU] Recovered\n");
      break;
  }

  if ((uint32_t)(HAL_GetTick() - step_start_tick) >= IMU_RECOVERY_BLOCK_NOTIFY_MS) {
    obj->recovery_blocked = true;
  }
}

void Imu_Init(Imu *obj, I2C_HandleTypeDef *i2c, bool calibrate_on_boot) {
  if (obj == NULL || i2c == NULL) return;
  memset(obj, 0, sizeof(*obj));
  obj->i2c = i2c;
  obj->gyro_z_scale = 1.0f;  // 上位が送るまでは感度の補正なし

  EnableDataReadyInterrupt(false);  // 初期化中はブロッキング I2C を使うので割り込みを止めておく

  RecoverI2cBus(i2c);

  if (!Mpu6050_Init(&obj->mpu, i2c, MPU6050_I2C_ADDR_LOW, IMU_SAMPLE_RATE_HZ,
                    IMU_DLPF)) {
    // 接続できなくても、通信が止まったときの復旧 (StepRecovery) を使って一定間隔で再試行する。
    // 復旧は MPU6050 を作り直したあとに、保存済みのオフセットと姿勢の初期化まで行うので、
    // ここでは復旧が使う最低限の状態だけ整えておく (Imu_IsReady は成功するまで false)
    printf("[IMU] Init failed; will retry\n");
    Ahrs_Init(&obj->ahrs, IMU_AHRS_KP, IMU_AHRS_KI);
    Mpu6050Offset saved;
    if (LoadCalibration(&saved)) obj->calib_offset = saved;
    obj->i2c_addr = MPU6050_I2C_ADDR_LOW;
    obj->initialized = true;
    obj->last_sample_tick = HAL_GetTick();
    obj->last_recovery_tick = obj->last_sample_tick;
    return;
  }

  Ahrs_Init(&obj->ahrs, IMU_AHRS_KP, IMU_AHRS_KI);

  if (calibrate_on_boot) {
    printf("[IMU] Calibrating... keep the vehicle still\n");
    if (Mpu6050_CalibrateOffset(&obj->mpu, IMU_CALIB_SAMPLE_COUNT)) {
      if (SaveCalibration(Mpu6050_GetOffset(&obj->mpu))) {
        printf("[IMU] Calibration saved\n");
      } else {
        printf("[IMU] Failed to save calibration\n");
      }
    } else {
      printf("[IMU] Calibration failed\n");
    }
  } else {
    Mpu6050Offset offset;
    if (LoadCalibration(&offset)) {
      Mpu6050_SetOffset(&obj->mpu, &offset);
      printf("[IMU] Calibration loaded from flash\n");
    } else {
      printf("[IMU] No calibration in flash; using zero offset\n");
    }
  }

  obj->i2c_addr = obj->mpu.i2c_addr;
  obj->calib_offset = *Mpu6050_GetOffset(&obj->mpu);

  // 取付方向 (ChipToBody) を確認するための実測値。この機体は裏向き実装なので水平静止で chip az ≒ -9.8
  Mpu6050Sample sample;
  if (Mpu6050_ReadBlocking(&obj->mpu, &sample)) {
    printf("[IMU] Chip frame accel: %.2f, %.2f, %.2f [m/s^2]\n",
           (double)sample.accel_x, (double)sample.accel_y,
           (double)sample.accel_z);
  }

  PrimeOrientation(obj);

  obj->initialized = true;
  obj->last_sample_tick = HAL_GetTick();
  obj->last_recovery_tick = obj->last_sample_tick;
  EnableDataReadyInterrupt(true);
}

bool Imu_Update(Imu *obj) {
  if (obj == NULL || !obj->initialized) return false;

  // 復旧の途中は MPU6050 を作り直している最中なので、サンプルは読まない
  if (obj->recovery_state != IMU_RECOVERY_IDLE) {
    StepRecovery(obj);
    return false;
  }

  const float dt = 1.0f / (float)obj->mpu.sample_rate_hz;
  Mpu6050Sample sample;
  bool updated = false;

  while (Mpu6050_PopSample(&obj->mpu, &sample)) {
    ProcessSample(obj, &sample, dt);
    updated = true;
  }

  uint32_t now = HAL_GetTick();
  if (updated) {
    obj->last_sample_tick = now;
    obj->data_valid = true;
    return true;
  }

  // 復旧の成否を待たず、サンプルが途絶した時点で即座に無効化する。復旧は
  // IMU_RECOVERY_INTERVAL_MS の間隔でしか試みないので、その間 Imu_IsReady() が固まった値の
  // まま true を返し続けると、TV がヨーレートの固まった実測値で動き続け、TCの基準速度も
  // 固まったヨーレートで計算される (無効なデータを有効として使ってしまう)
  if ((uint32_t)(now - obj->last_sample_tick) >= IMU_SAMPLE_TIMEOUT_MS) {
    obj->data_valid = false;
    if ((uint32_t)(now - obj->last_recovery_tick) >= IMU_RECOVERY_INTERVAL_MS) {
      printf("[IMU] Sample timeout; recovering\n");
      StartRecovery(obj);
    }
  }
  return false;
}

void Imu_SetVehicleStill(Imu *obj, bool still) { obj->vehicle_still = still; }

const ImuData *Imu_GetData(const Imu *obj) { return &obj->data; }

bool Imu_IsReady(const Imu *obj) { return obj->initialized && obj->data_valid; }

bool Imu_ConsumeRecoveryBlocked(Imu *obj) {
  bool blocked = obj->recovery_blocked;
  obj->recovery_blocked = false;
  return blocked;
}

void Imu_ResetYaw(Imu *obj) {
  if (obj == NULL) return;
  obj->yaw_offset = obj->ahrs.yaw;
  obj->data.yaw = 0.0f;
}

bool Imu_RecalibrateAndSave(Imu *obj) {
  if (obj == NULL || !obj->initialized) return false;
  if (obj->recovery_state != IMU_RECOVERY_IDLE) return false;  // 通信の復旧中は測れない

  EnableDataReadyInterrupt(false);
  bool ok = Mpu6050_CalibrateOffset(&obj->mpu, IMU_CALIB_SAMPLE_COUNT);
  if (ok) ok = SaveCalibration(Mpu6050_GetOffset(&obj->mpu));
  obj->calib_offset = *Mpu6050_GetOffset(&obj->mpu);

  obj->gyro_bias_x = 0.0f;
  obj->gyro_bias_y = 0.0f;
  obj->gyro_bias_z = 0.0f;
  obj->stationary_count = 0;
  Ahrs_Init(&obj->ahrs, IMU_AHRS_KP, IMU_AHRS_KI);
  PrimeOrientation(obj);

  obj->last_sample_tick = HAL_GetTick();
  EnableDataReadyInterrupt(true);
  return ok;
}

void Imu_OnDataReady(Imu *obj) { Mpu6050_OnDataReady(&obj->mpu); }

void Imu_OnI2cRxComplete(Imu *obj, I2C_HandleTypeDef *hi2c) {
  Mpu6050_OnI2cRxComplete(&obj->mpu, hi2c);
}

void Imu_OnI2cError(Imu *obj, I2C_HandleTypeDef *hi2c) {
  Mpu6050_OnI2cError(&obj->mpu, hi2c);
}

void Imu_SetGyroZScale(Imu *obj, float scale) {
  obj->gyro_z_scale = (scale >= 0.9f && scale <= 1.1f) ? scale : 1.0f;
}
