banbatakumi/AutonomousCar/Program/MainF446RE_V3/src/lighting/lighting.h

#ifndef LIGHTING_H_
#define LIGHTING_H_

#include <stdbool.h>

#include "pwm_out.h"
#include "timer.h"

// ウィンカー・ハザードの状態
typedef enum {
  LIGHTING_WINKER_OFF = 0,
  LIGHTING_WINKER_LEFT,
  LIGHTING_WINKER_RIGHT,
  LIGHTING_WINKER_HAZARD,
} LightingWinkerState;

typedef enum {
  LIGHTING_WINKER_MODE_NORMAL = 1,
  LIGHTING_WINKER_MODE_SMOOTH = 2,
  LIGHTING_WINKER_MODE_BULB = 3,
} LightingWinkerMode;

// 前照灯の点灯パターン
typedef enum {
  LIGHTING_HEADLIGHT_OFF = 0,
  LIGHTING_HEADLIGHT_DAYTIME,  // デイライト (減光、日中の被視認性向上用)
  LIGHTING_HEADLIGHT_NORMAL,   // 通常点灯 (夜間走行用、全光量)
} LightingHeadlightMode;

typedef struct {
  PwmOut front_light;
  PwmOut rear_light;
  PwmOut left_winker;
  PwmOut right_winker;

  LightingHeadlightMode headlight_mode;
  bool passing_on;
  bool brake_on;
  bool brake_flashing;
  bool brake_dimmed;  // 停車保持中の減光 (Lighting_SetBrakeDimmed)
  Timer brake_flash_timer;
  float front_light_duty;  // front_light に直近書き込んだ duty (ウィンカー減光判定に使う)
  float rear_light_duty;   // rear_light に直近書き込んだ duty (ウィンカー減光判定に使う)

  LightingWinkerState winker_state;
  LightingWinkerMode winker_mode;
  Timer winker_timer;
} Lighting;

/**
 * @brief ライティング系統を初期化する。前照灯・尾灯・左右ウィンカーをそれぞれ指定した TIM チャンネルに割り当てる。
 */
void Lighting_Init(Lighting* obj, TIM_HandleTypeDef* front_htim, uint32_t front_channel,
                    TIM_HandleTypeDef* rear_htim, uint32_t rear_channel,
                    TIM_HandleTypeDef* left_htim, uint32_t left_channel,
                    TIM_HandleTypeDef* right_htim, uint32_t right_channel);

/**
 * @brief 前照灯を指定パターンで点灯する。OFF 以外では尾灯も薄暗く連動点灯する。
 */
void Lighting_SetHeadlight(Lighting* obj, LightingHeadlightMode mode);

/**
 * @brief パッシング (前照灯の一時的な全光量点灯) を on/off する。
 * on の間は headlight_mode に関わらず前照灯が全光量になるが、尾灯は連動しない
 * (実車のパッシングと同じ。前照灯モードは保持されるので off にすれば元のモードに戻る)。
 */
void Lighting_SetPassing(Lighting* obj, bool on);

/**
 * @brief ブレーキランプ (尾灯の増灯) を点灯/消灯する。
 */
void Lighting_SetBrake(Lighting* obj, bool on);

/**
 * @brief ブレーキランプを点灯/消灯し、必要なら高速点滅させる。
 */
void Lighting_SetBrakeMode(Lighting* obj, bool on, bool flashing);

/**
 * @brief 点灯中のブレーキランプ (常灯) を停車保持用の明るさへ落とす/戻す。
 * 高速点滅 (緊急制動表示) と尾灯には影響しない。走行中の制動では必ず false にすること。
 */
void Lighting_SetBrakeDimmed(Lighting* obj, bool dimmed);

/**
 * @brief ブレーキランプの高速点滅を on/off する。点滅中はブレーキランプも点灯状態になる。
 */
void Lighting_SetBrakeFlashing(Lighting* obj, bool on);

/**
 * @brief ウィンカー/ハザードの状態を設定する。
 */
void Lighting_SetWinker(Lighting* obj, LightingWinkerState state);
void Lighting_SetWinkerMode(Lighting* obj, LightingWinkerMode mode);

/**
 * @brief 直近に設定したウィンカー/ハザードの状態を取得する。
 * ハザード表示 (src/hmi/indicator.c) と方向指示 (src/vehicle/vehicle.c) の
 * どちらが最終的に反映されているかを、呼び出し元に関わらず知りたい場合に使う。
 */
LightingWinkerState Lighting_GetWinkerState(const Lighting* obj);

/**
 * @brief ウィンカーの点滅処理を更新する。メインループで毎ティック呼ぶこと。
 */
void Lighting_Update(Lighting* obj);

/**
 * @brief ウィンカー/ハザードの点滅1周期分の時間 [ms] を取得する。
 * 起動時に指定回数だけ点滅させたい場合など、この値の倍数だけ待てばよい。
 */
uint32_t Lighting_GetWinkerPeriodMs(void);

#endif  // LIGHTING_H_
