banbatakumi/AutonomousCar/Program/MainF446RE_V3/src/hmi/indicator.c

#include "indicator.h"

#include "mymath.h"

static void BreathLed_Init(BreathLed* obj, PwmOut* led) {
  obj->led = led;
  Timer_Init(&obj->timer);
}

// voltage には Power 側で LPF を通した値を渡すこと。生値だと周期がガタついて読めない
static void BreathLed_Update(BreathLed* obj, float voltage, bool fault) {
  float level = (voltage - POWER_UNDERVOLTAGE_THRESHOLD_V) /
                (POWER_BATTERY_FULL_V - POWER_UNDERVOLTAGE_THRESHOLD_V);
  level = Constrain(level, 0.0f, 1.0f);
  float period_ms = INDICATOR_BREATH_PERIOD_EMPTY_MS +
                    level * (INDICATOR_BREATH_PERIOD_FULL_MS - INDICATOR_BREATH_PERIOD_EMPTY_MS);

  uint32_t elapsed_ms = Timer_ReadMs(&obj->timer);
  if ((float)elapsed_ms >= period_ms) {
    Timer_Reset(&obj->timer);
    elapsed_ms = 0;
  }

  // 波形全体を周期に比例させることで、周期が変わっても点灯時間の割合 (=平均輝度) が変わらない。
  // 点灯時間を固定したまま周期だけ縮めると明るさまで変化し、輝度の1bit情報と混ざってしまう
  float shape = (1.0f - CosDeg((int)(360.0f * elapsed_ms / period_ms))) * 0.5f;
  // 人間の輝度知覚は対数的なので、shape をそのまま duty にすると暗い側が潰れる
  float peak = fault ? INDICATOR_BREATH_DUTY_FAULT : INDICATOR_BREATH_DUTY_NORMAL;
  PwmOut_Write(obj->led, peak * shape * shape);
}

static void UpdatePowerIndication(Indicator* obj) {
  uint32_t faults = Power_GetFaults(obj->power);
  BreathLed_Update(&obj->breath_signal, Power_GetVoltageSignalFiltered(obj->power),
                   (faults & POWER_FAULT_SIGNAL_ANY) != 0);
  BreathLed_Update(&obj->breath_drive, Power_GetVoltageDriveFiltered(obj->power),
                   (faults & POWER_FAULT_DRIVE_ANY) != 0);
}

// 何らかの異常が出ていればハザードを点滅させ、車外から異常だと分かるようにする。
// 復帰しうる異常 (電圧低下) もあるため、消えたらハザードも消す。
//
// 上位 (Raspberry Pi) からの方向指示要求 (winker_request) はフォールト時のハザードより
// 優先度が低い。ウィンカーとハザードは Lighting 上で表現を共有しているため、この
// 調停を一箇所 (ここ) に集約する。
static void UpdateFaultIndication(Indicator* obj, bool estop_active,
                                  LightingWinkerState winker_request) {
  bool fault = Power_GetFaults(obj->power) != POWER_FAULT_NONE || estop_active;
  Lighting_SetWinker(obj->lighting, fault ? LIGHTING_WINKER_HAZARD : winker_request);
}

static void UpdateUndervoltageWarning(Indicator* obj) {
  uint32_t faults = Power_GetFaults(obj->power);
  // 制御電源 (シグナル系) は常時警告する。駆動系は駆動電源 OFF 中は意味を持たないので除外
  bool warn = (faults & POWER_FAULT_SIGNAL_UNDERVOLTAGE) != 0 ||
              ((faults & POWER_FAULT_DRIVE_UNDERVOLTAGE) != 0 && Power_IsDriveOn(obj->power));

  if (!warn) {
    // 条件が解消したら消音状態も解除し、次の電圧低下でまた鳴らす
    if (obj->undervoltage_warning_started) Buzzer_Stop(obj->buzzer);
    obj->undervoltage_warning_started = false;
    obj->undervoltage_muted = false;
    return;
  }

  if (DigitalIn_Read(obj->mute_button)) obj->undervoltage_muted = true;

  if (obj->undervoltage_muted) {
    if (obj->undervoltage_warning_started) Buzzer_Stop(obj->buzzer);
    obj->undervoltage_warning_started = false;
  } else if (!obj->undervoltage_warning_started ||
             obj->buzzer->pattern == BUZZER_PATTERN_NONE) {
    // 他の音 (ARM/DISARM のスイープ・クラクション) がパターンを上書きして止まった場合も再開する
    Buzzer_BeepPattern(obj->buzzer, INDICATOR_UNDERVOLTAGE_BEEP_FREQ_HZ,
                       INDICATOR_UNDERVOLTAGE_BEEP_ON_MS, INDICATOR_UNDERVOLTAGE_BEEP_OFF_MS, -1);
    obj->undervoltage_warning_started = true;
  }
}

void Indicator_Init(Indicator* obj, Power* power, Lighting* lighting,
                    PwmOut* signal_led, PwmOut* drive_led,
                    Buzzer* buzzer, DigitalIn* mute_button) {
  obj->power = power;
  obj->lighting = lighting;
  obj->buzzer = buzzer;
  obj->mute_button = mute_button;
  obj->undervoltage_warning_started = false;
  obj->undervoltage_muted = false;
  BreathLed_Init(&obj->breath_signal, signal_led);
  BreathLed_Init(&obj->breath_drive, drive_led);
}

void Indicator_Update(Indicator* obj, bool estop_active, LightingWinkerState winker_request,
                      LightingWinkerMode winker_mode) {
  Lighting_SetWinkerMode(obj->lighting, winker_mode);
  UpdateFaultIndication(obj, estop_active, winker_request);
  UpdatePowerIndication(obj);
  UpdateUndervoltageWarning(obj);
}
