banbatakumi/AutonomousCar/Program/MainF446RE_V3/src/sensing/imu.h

#ifndef IMU_H_
#define IMU_H_

#include <stdbool.h>
#include <stdint.h>

#include "ahrs.h"
#include "i2c.h"
#include "lpf.h"
#include "mpu6050.h"

// 機体の姿勢センシング。MPU6050 ドライバ (lib/mpu6050) と姿勢推定フィルタ (lib/ahrs) を束ね、
// 「機体座標系での yaw/pitch/roll と加速度」を提供する。
//
// 精度を優先した設計:
//   - 取得はセンサの DATA_RDY 割り込み (PC5/INT) 起点。周期はセンサ内蔵クロックで決まりジッタがない
//   - サンプルはリングバッファに積まれるので、メインループが遅れても積分対象が欠落しない
//   - ジャイロのオフセットは起動時キャリブレーション + Flash 保存 (温度が変わるとずれるため、
//     静止を検出している間はオンラインで残留バイアスを追従補正する)
//   - 加速度は重力ノルムから外れたサンプルを姿勢補正に使わない (加減速時に姿勢が引っ張られるのを防ぐ)
//
// 地磁気センサがないため yaw は絶対方位ではなく、起動時 (または Imu_ResetYaw() を呼んだ時点)
// を 0 とする相対角。長時間ではゆっくりドリフトする。

// 機体座標系の定義: X = 前方, Y = 左方, Z = 上方 の右手系 (ROS REP-103 と同じ取り方)。
// したがって前進加速で accel_x が正、左旋回で accel_y と yaw が正になる。
// 角度は roll = 右へ傾けると正、pitch = 機首上げが正 (pitch のみ右手系とは逆の航空機流儀)。
typedef struct {
  float yaw;    // [deg] -180..180 (左旋回が正)
  float pitch;  // [deg] -90..90
  float roll;   // [deg] -180..180

  float gyro_x;  // [deg/s] 機体座標系 (バイアス補正済み)
  float gyro_y;
  float gyro_z;

  float accel_x;  // [m/s^2] 機体座標系 (重力を含む・ローパス後)
  float accel_y;
  float accel_z;

  float linear_accel_x;  // [m/s^2] 推定姿勢から重力成分を差し引いた並進加速度
  float linear_accel_y;
  float linear_accel_z;

  // ローパス前の生の加速度 X [m/s^2] (機体座標系・重力込み)。車速のカルマンフィルタ用。
  // sample_seq は取り込んだサンプルごとに進む (利用側は前回と違うときだけ取り込む)
  float accel_x_raw;
  uint32_t sample_seq;

  float temp;       // [degC] センサ内部温度
  bool stationary;  // 静止と判定されているか (ジャイロバイアス追従中)
} ImuData;

typedef struct {
  Mpu6050 mpu;
  Ahrs ahrs;

  LPF lpf_accel_x;
  LPF lpf_accel_y;
  LPF lpf_accel_z;

  // 静止中に推定する残留ジャイロバイアス [deg/s] (温度ドリフト分を吸収する)
  float gyro_bias_x;
  float gyro_bias_y;
  float gyro_bias_z;
  uint32_t stationary_count;
  // 車速が 0 付近か (Imu_SetVehicleStill)。偽の間はジャイロのバイアスを学習しない
  bool vehicle_still;

  float yaw_offset;  // [deg] Imu_ResetYaw() で与える yaw の原点
  // z 軸の感度の補正 (Imu_SetGyroZScale。上位が送る。既定 1)。バイアスを引いた後に掛ける
  float gyro_z_scale;

  ImuData data;
  bool initialized;
  bool data_valid;
  uint32_t last_sample_tick;
  uint32_t last_recovery_tick;

  // 通信が止まったときの復旧 (imu.c の StepRecovery)。制御周期ごとに1段階ずつ進める
  I2C_HandleTypeDef *i2c;
  uint8_t i2c_addr;              // 応答のあった 7bit アドレス
  Mpu6050Offset calib_offset;    // 復旧で MPU6050 を作り直したあとに戻すオフセット
  uint8_t recovery_state;        // ImuRecoveryState。0 = 復旧していない
  uint8_t recovery_step;         // 段階の中の進み具合
  uint32_t recovery_wait_tick;   // この時刻 (HAL_GetTick) になるまで次へ進まない
  // 復旧の1段階がメインループを長く止めたら立つ (Imu_ConsumeRecoveryBlocked)
  bool recovery_blocked;
} Imu;

/**
 * @brief IMU を初期化する。I2C バス復旧 → MPU6050 初期化 → キャリブレーション読み込み →
 * 初期姿勢の推定 → DATA_RDY 割り込み (PC5) の有効化まで行う。
 * @param calibrate_on_boot true なら静止キャリブレーションを実行して Flash に保存する
 * (数秒かかるのでボタン押下起動などの明示的な操作に割り当てること)。
 * false なら Flash に保存済みの値を読み込む。
 */
void Imu_Init(Imu *obj, I2C_HandleTypeDef *i2c, bool calibrate_on_boot);

/**
 * @brief 溜まっているサンプルをすべて処理して姿勢・加速度を更新する。制御周期ごとに呼ぶこと。
 * サンプルが途絶えたら I2C と MPU6050 の復旧も進める (ブロッキングしない。1回の呼び出しで1段階)。
 * @return 1 サンプル以上処理したら true。
 */
bool Imu_Update(Imu *obj);

/**
 * @brief 最新の推定結果を取得する (常に非 NULL。初回サンプル前はゼロ)。
 */
const ImuData *Imu_GetData(const Imu *obj);

/**
 * @brief 有効なデータを取得できているか (センサ未接続・通信断のときは false)。
 */
bool Imu_IsReady(const Imu *obj);

/**
 * @brief 前回の呼び出し以降に、復旧処理がメインループを長く (数ms以上) 止めたかを取得し、
 * フラグをクリアする。復旧は待ち時間を制御周期をまたいで待つので通常は止めないが、
 * I2C バスが電気的に張り付いている (BUSY が解けない) と HAL が1往復あたり 25ms 待つ。
 * 呼び出し側はこれを見てハートビート監視の基準時刻をリセットするなど、ブロッキングを
 * 前提としていない他モジュールの誤動作を避ける用途に使うこと。
 */
bool Imu_ConsumeRecoveryBlocked(Imu *obj);

/**
 * @brief 車速から見て静止しているかを伝える。毎周期呼ぶこと。偽の間は (ジャイロ・加速度が
 * 静かに見えても) ジャイロのバイアス追従を止める。呼ばれるまでは偽 (追従しない)。
 */
void Imu_SetVehicleStill(Imu *obj, bool still);

/**
 * @brief 現在の向きを yaw = 0 とし直す。
 */
void Imu_ResetYaw(Imu *obj);

/**
 * @brief 静止キャリブレーションをやり直して Flash に保存する (ブロッキング)。
 */
bool Imu_RecalibrateAndSave(Imu *obj);

/**
 * @brief MPU6050 の INT ピン (PC5) の EXTI 割り込みから呼ぶこと。
 */
void Imu_OnDataReady(Imu *obj);

/**
 * @brief HAL_I2C_MemRxCpltCallback から呼ぶこと。
 */
void Imu_OnI2cRxComplete(Imu *obj, I2C_HandleTypeDef *hi2c);

/**
 * @brief HAL_I2C_ErrorCallback / HAL_I2C_AbortCpltCallback から呼ぶこと。
 */
void Imu_OnI2cError(Imu *obj, I2C_HandleTypeDef *hi2c);

/**
 * @brief z 軸の角速度の感度の補正 (倍率) を入れる。バイアスを引いた後の z に掛け、ヨーレート・姿勢推定・
 * TC/TV のすべてに効く。範囲外 (0.9〜1.1 の外・非数) は 1 にする。毎周期呼んでよい。
 */
void Imu_SetGyroZScale(Imu *obj, float scale);

#endif  // IMU_H_
