banbatakumi/AutonomousCar/Program/MainF446RE_V3/src/hmi/indicator.h

#ifndef INDICATOR_H_
#define INDICATOR_H_

#include <stdbool.h>

#include "buzzer.h"
#include "digitalinout.h"
#include "lighting.h"
#include "power.h"
#include "pwm_out.h"
#include "timer.h"

// ===========================================================================
// 機体の状態を人間へ見せる表示をまとめたモジュール。
//
// 上位からの指令で点く灯火 (ブレーキ灯・前照灯・パッシング) は車両制御側 (Vehicle) が
// 扱い、こちらは「機体が今どういう状態か」から導かれる表示だけを担当する。
// ハザードはウィンカーと灯火を共有するため、方向指示 (Vehicle_GetWinkerRequest()) と
// フォールト表示の優先度調停はここで行う (フォールト優先)。
// ===========================================================================

// --- 電源状態の表示 (LED3: シグナル系, LED4: 駆動系) ---
//
// 電圧を「呼吸」の周期にマップして脈打たせる。周期から電圧の目安が読めるうえ、脈が
// 止まれば制御ループが回っていないことも同時に分かる。輝度に連続量を載せても人間には
// 読めないため、輝度は1bitの情報として使い、その系統にフォールトが出たときだけ最大にする。
#define INDICATOR_BREATH_PERIOD_FULL_MS 2000.0f  // 満充電時はゆったり脈打つ
#define INDICATOR_BREATH_PERIOD_EMPTY_MS 300.0f  // 終止電圧に近いほど速く脈打つ (速い=危険、警報の慣習に合わせる)
#define INDICATOR_BREATH_DUTY_NORMAL 0.1f        // 正常時のピーク輝度
#define INDICATOR_BREATH_DUTY_FAULT 1.0f         // フォールト時のピーク輝度

typedef struct {
  PwmOut* led;
  Timer timer;
} BreathLed;

// --- 電圧低下の警告音 ---
// 制御電源 (シグナル系) の低下は常に、駆動系の低下は駆動電源が ON の間だけ鳴らす
// (OFF 中は駆動側の電圧が意味を持たず、充電・待機中の誤警報になる)。
// ボタン1で消音でき、電圧が復帰するか駆動電源が切れるまで再び鳴らない (そのたびに鳴り直すと
// 走行中にうるさいため)。クラクション (Vehicle) とブザーを共有しており、クラクションが
// 警告音を打ち切った場合は次の電圧低下まで再開しない。
#define INDICATOR_UNDERVOLTAGE_BEEP_FREQ_HZ 2500
#define INDICATOR_UNDERVOLTAGE_BEEP_ON_MS 150
#define INDICATOR_UNDERVOLTAGE_BEEP_OFF_MS 850

typedef struct {
  Power* power;
  Lighting* lighting;
  Buzzer* buzzer;
  DigitalIn* mute_button;
  bool undervoltage_warning_started;  // 警告音を鳴らし始めた (ブザーへ指示済み)
  bool undervoltage_muted;            // ボタン1で消音済み
  BreathLed breath_signal;
  BreathLed breath_drive;
} Indicator;

/**
 * @brief 状態表示を初期化する。signal_led / drive_led には PwmOut_Init 済みの
 * LED3 / LED4 を渡すこと。
 */
void Indicator_Init(Indicator* obj, Power* power, Lighting* lighting,
                    PwmOut* signal_led, PwmOut* drive_led,
                    Buzzer* buzzer, DigitalIn* mute_button);

/**
 * @brief 電源表示と異常表示を1周期分更新する。制御周期ごとに呼ぶこと。
 * estop_active には緊急停止のラッチ状態を渡す (電源フォールトと同じくハザードで表示する)。
 * winker_request には上位 (Raspberry Pi) から要求されたウィンカー/ハザード状態
 * (Vehicle_GetWinkerRequest()) を渡す。フォールト・緊急停止中はこれより優先してハザードを表示する
 * (ウィンカーとハザードは Lighting 上で表現を共有するため、優先度の調停をここに集約している)。
 * Lighting_Update より前に呼ぶこと。
 */
void Indicator_Update(Indicator* obj, bool estop_active, LightingWinkerState winker_request,
                     LightingWinkerMode winker_mode);

#endif  // INDICATOR_H_
