banbatakumi/AutonomousCar/Program/MainF446RE_V3/src/comm/heartbeat.c

#include "heartbeat.h"

void Heartbeat_Init(Heartbeat* obj, GPIO_TypeDef* port, uint16_t pin) {
  // ピンは CubeMX の設定 (入力・プルアップ無し) のまま使う。基板側に外付けの
  // プルアップがあるため、Pi がオープンドレインで駆動しても High 側は確定する
  DigitalIn_Init(&obj->pin, port, pin);

  obj->last_level = DigitalIn_Read(&obj->pin);
  obj->last_edge_us = Micros();
  obj->edge_count = 0;
  obj->alive = false;
}

void Heartbeat_Update(Heartbeat* obj) {
  int level = DigitalIn_Read(&obj->pin);
  if (level == obj->last_level) {
    if (obj->alive && (uint32_t)(Micros() - obj->last_edge_us) >= HEARTBEAT_TIMEOUT_US) {
      obj->alive = false;
    }
    return;
  }

  obj->last_level = level;
  obj->last_edge_us = Micros();
  obj->alive = true;
  if (obj->edge_count < UINT32_MAX) obj->edge_count++;
}

bool Heartbeat_IsAlive(const Heartbeat* obj) {
  if (obj->edge_count < HEARTBEAT_MIN_EDGES || !obj->alive) return false;
  return (uint32_t)(Micros() - obj->last_edge_us) < HEARTBEAT_TIMEOUT_US;
}

bool Heartbeat_HasEverBeenSeen(const Heartbeat* obj) {
  return obj->edge_count >= HEARTBEAT_MIN_EDGES;
}

uint32_t Heartbeat_GetEdgeCount(const Heartbeat* obj) {
  return obj->edge_count;
}

void Heartbeat_ResetBaseline(Heartbeat* obj) {
  // 途絶を検出済み (alive が偽) なら生き返らせない。次の本物のエッジを待つ
  obj->last_edge_us = Micros();
}
