banbatakumi/AutonomousCar/(commit log)

2025-10-24 フォルダ作った
2025-10-24 プロジェクトの作成
    [MainBoard_V1.kicad_pcb, MainBoard_V1.kicad_sch]
2025-10-30 回路図書いてる途中
    [MainBoard_V1.kicad_sch]
2025-11-20 MX生成
2025-11-20 UARTのピン設定
2025-11-25 配線と配置を進めた
    [MainBoard_V1.kicad_pcb, MainBoard_V1.kicad_sch, OKL-T_6-W12N-C.step]
2025-11-26 LED用のコネクタ追加
    [MainBoard_V1.kicad_pcb]
2025-11-30 配線進捗
    [MainBoard_V1.kicad_pcb, MainBoard_V1.kicad_sch]
2026-03-30 ほぼ完成
2026-03-30 発注データ
    [MainBoard_V1.kicad_pcb, bom.csv, designators.csv, positions.csv]
2026-04-30 多分何も変わってないけど一応
    [MainBoard_V1.kicad_pcb]
2026-04-30 MXの設定編集
2026-04-30 gitignoreの追加
2026-04-30 libの移行
2026-05-01 モーター回った
2026-05-03 超音波読めた
2026-05-03 超音波センサ高速化&精度向上
2026-05-03 電子ディファレンシャル制御追加
2026-05-03 ブレーキ実装
2026-05-03 lidar読めた
2026-05-03 ロボット全面を0°に設定
2026-05-04 feat: enable USART1 DMA transmission and generate compile_commands.json
2026-05-05 refactor: optimize serial communication structure and implement low-pass filtering for vehicle speed and steering
2026-05-05 feat: add MainBoard V2 circuit design files, library components, and production documentation
    [MainBoardPCB.dxf, MainBoard_V1.kicad_pcb, MainBoard_V1.kicad_sch, OKL-T_6-W12N-C.step, bom.csv, designators.csv, positions.csv]
2026-05-05 V2完成
    [MainBoard_V2.kicad_pcb, MainBoard_V2.kicad_sch, bom.csv, designators.csv, positions.csv]
2026-05-05 Refactor flash memory handling and enhance drive control logic
    - Updated flash memory handling in flash.h to accommodate STM32F446 sector configuration and improved data writing logic.
    - Enhanced drive control in drive.c to support dynamic acceleration and steering adjustments, including new PID control for velocity.
    - Introduced new algorithms for forward-only movement and improved obstacle avoidance in algorithm.c.
    - Added mode management functionality to switch between standby, run, and forward-only modes based on button inputs.
    - Improved ADC voltage reading and heartbeat LED update logic in app.c.
    - Added new PID control structure and functions in pid.h for better control over drive beh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
    [app.c, drive.c, drive.h, main.c]
2026-05-06 mpu読めた
2026-05-06 feat: implement async I2C read for MPU6050 and update drive control logic
2026-05-06 feat: add moving average filter and update drive control logic
2026-05-07 Update MainBoard V2 production files
    - Updated BOM to include additional capacitors (C20, C21) with increased quantities.
    - Added new designators for capacitors C20 and C21 in designators.csv.
    - Modified netlist.ipc to reflect changes in the circuit layout, including new connections and adjustments to existing vias.
    - Adjusted positions.csv for precise component placement, including minor adjustments to several components' coordinates.
    - Added a backup of the MainBoard V2 design from May 7, 2026.
    - Updated the MainBoard V2 production zip file with the latest design files.
    [MainBoard_V2.kicad_pcb, MainBoard_V2.kicad_sch, bom.csv, designators.csv, positions.csv]
2026-05-07 Refactor LiDAR integration and voltage measurement
    - Updated the algorithm to use Drive_SetVelocity instead of Drive_Set for smoother control.
    - Introduced DigitalOut for lidar_motor to manage LiDAR power control.
    - Added LPF (Low Pass Filter) for voltage measurements to smooth out readings.
    - Modified Setup function to initialize the LiDAR motor control and LPF instances.
    - Enhanced GetSensors function to apply LPF to voltage readings.
    - Adjusted Drive_Init to refine PID parameters for better velocity control.
    - Moved LD06 implementation to a new directory structure for better organization.
    - Updated LD06_Init to accept a DigitalOut pointer for motor control.
    - Removed old LD06 implementati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
2026-05-08 fix: adjust threshold values for front obstacle detection and emergency brake
2026-05-08 feat: implement lidar utility functions and refactor forward algorithm for improved obstacle detection
2026-05-08 feat: add Lidar_FindNearestSector function for improved sector evaluation and update drive control logic
2026-05-09 fix: adjust brake LED brightness for improved visibility
    [drive.c]
2026-05-09 Refactor drive module and update serial communication
    - Renamed Drive_Serial to Drive_Update for clarity.
    - Improved serial communication handling in Drive_Update, including brake LED control.
    - Introduced helper functions for packet building and distance accumulation in lidar utilities.
    - Enhanced Lidar_FindGaps and Lidar_GetSector functions for better readability and maintainability.
    - Updated Drive_Set and Drive_SetVelocity functions to streamline acceleration and velocity ramping.
    - Added comments for better understanding of the code logic and flow.
2026-05-09 ゾーン修正
    [MainBoard_V2.kicad_pcb, MainBoard_V2.kicad_sch]
2026-05-09 refactor: remove unused lidar utility functions and update parameters for improved performance
2026-05-09 feat: add winker LED control and related parameters to drive module
2026-05-10 Refactor IMU handling: Replace ImuManager with Imu struct
    - Removed ImuManager and its associated files (imu_manager.c, imu_manager.h).
    - Introduced Imu struct to encapsulate MPU6050 initialization, calibration, and data retrieval.
    - Updated app.c, app.h, app_init.c, and app_loop.c to use the new Imu struct.
    - Implemented calibration loading and saving to flash in the new Imu functions.
    - Added asynchronous I2C reading capabilities directly in the Imu struct.
    - Enhanced MPU6050 handling with improved data processing and quaternion calculations.
    [app.c, app.h, imu.c, imu.h]
2026-05-10 feat: add mount configuration for MPU6050 to support flexible installation orientations
2026-05-10 feat: update algorithm parameters for improved performance and remove IMU debug output
2026-05-12 feat: update PID initialization and gain functions, adjust ultrasonic distance adjustment, and modify drive parameters for improved control
2026-05-12 feat: update UART baud rates to 250000 for improved communication speed, adjust data size and structure in drive handling
2026-05-12 feat: implement lighting module for brake, winker, and headlight control; remove unused front_led references
2026-05-12 feat: enhance drive control with torque-based commands, update IMU data handling, and improve traction estimation
2026-05-15 V1プロジェクトのコピー
2026-05-16 feat: Refactor and enhance buzzer functionality
    - Added buzzer library with initialization, beep patterns, and startup melody.
    - Updated LD06 initialization to use PWM for motor control.
    - Modified algorithm to adjust drive velocity and added buzzer updates in the main loop.
    - Refactored LED control to use PWM for smoother brightness adjustments.
    - Adjusted emergency stop distance and other constants for improved performance.
    - Updated project configuration files to reflect changes in peripherals and added new files.
    [app.c, app.h, drive.c, main.c, main.h]
2026-05-16 feat: Enhance DMA and USART configurations
    - Added DMA2 stream handlers for USART1 and USART6 in interrupt and initialization files.
    - Updated USART6 baud rate to 230400 and changed DMA modes from circular to normal for USART4, USART5, and USART2.
    - Implemented DMA for USART1 and USART6 with appropriate configurations in usart.c.
    - Modified algorithm for forward movement based on lidar distance, adjusting velocity and braking conditions.
    - Increased maximum torque in drive.h and adjusted traction estimation logic in drive.c for improved performance.
    - Updated mode switching logic to provide feedback via buzzer when modes change.
    - Refactored mode update function to return a boolean indicatin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
    [drive.c, drive.h]
2026-05-17 Refactor and reorganize code structure for improved modularity and functionality
    - Removed app_init.c and app_loop.c files to streamline application initialization and main loop logic.
    - Introduced sensor.c and sensor.h for centralized sensor management, including ultrasonic and IMU handling.
    - Added remote control functionality with remote.c, remote.h, and associated auto/manual control files.
    - Enhanced drive.c and drive.h to include temperature monitoring for motors and improved data handling.
    - Implemented new remote auto modes (remote_auto1.c, remote_auto2.c) for advanced autonomous behavior.
    - Updated existing functions to accommodate new structures and ensure compatibility with the re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
2026-05-17 feat: Update USART6 baud rate to 1,000,000 and enhance lidar data processing
2026-05-18 feat: Implement watchdog timer functionality and enhance remote control logic
2026-05-18 feat: Refactor drive control to use voltage instead of torque and update related structures
2026-05-19 feat: Implement I2C error handling and enhance related functionality
    [app.c, drive.c, imu.c, imu.h]
2026-05-20 feat: Implement Kalman filter for velocity estimation with innovation gating
2026-05-20 feat: Update forward algorithm and remote control logic for improved velocity handling
2026-05-22 Enhance Drive and Stability Control Features
    - Updated Drive_SetImuData to include gyro_z for improved traction estimation.
    - Reduced control frequency from 10kHz to 5kHz for better stability.
    - Adjusted traction voltage reduction rate from 6.0V/s to 4.0V/s.
    - Increased slip threshold from 0.1m/s to 0.15m/s and debounce samples from 10 to 50 for more robust slip detection.
    - Implemented stability control logic to adjust steering based on yaw rate error.
    - Added functions to enable/disable stability control and retrieve yaw rate error.
    - Improved IMU initialization with I2C bus recovery mechanism.
    - Refined Lidar functions for clearer direction finding and spike filtering.
    - Updated remote co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
    [app.c, app.h, drive.c, drive.h, imu.c]
2026-05-23 feat: Add I2C error handling and improve drive control parameters
    [drive.c, drive.h]
2026-05-24 feat: Enhance sensor update logic and improve drive parameters for better stability and control
    [app.c, app.h, drive.c, lighting.c]
2026-06-03 バグ修正
2026-06-03 製造ファイル生成
    [OtherBoard_V1.kicad_pcb, OtherBoard_V1.kicad_sch, bom.csv, designators.csv, positions.csv]
2026-06-06 回路図と配置と配線が半分ほど終わり
    [MainBoardPCB.dxf, MainBoard_V3.kicad_sch, OKL-T_6-W12N-C.step]
2026-06-06 V2からMXプロジェクトをコピー
2026-06-07 大体設計終わり あとGNDビア
    [MainBoard_V3.kicad_pcb, MainBoard_V3.kicad_sch]
2026-06-08 製造ファイル再生成
    [positions.csv]
2026-06-08 製造ファイル生成後の保存
    [OtherBoard_V1.kicad_pcb]
2026-06-08 配線幅変更と製造ファイル再生成
    [OtherBoard_V1.kicad_pcb]
2026-06-08 電流センスの追加と設計大体終わり
    [MainBoard_V3.kicad_pcb, MainBoard_V3.kicad_sch, bom.csv, designators.csv, positions.csv]
2026-06-11 完成&製造ファイル生成
    [MainBoard_V3.kicad_pcb, MainBoard_V3.kicad_sch, bom.csv, designators.csv, positions.csv]
2026-07-17 修正&製造ファイル生成
    [MainBoardPCB.dxf, MainBoard_V3_2.kicad_pcb, MainBoard_V3_2.kicad_sch, OKL-T_6-W12N-C.step, bom.csv, designators.csv, positions.csv]
2026-07-17 TVSダイオード追加
    [MainBoard_V3_2.kicad_pcb, MainBoard_V3_2.kicad_sch, bom.csv, designators.csv, positions.csv]
2026-07-18 修正多分最終
    [MainBoard_V3_2.kicad_pcb, MainBoard_V3_2.kicad_sch, bom.csv, designators.csv, positions.csv]
2026-07-20 rasとstmをプルアップで繋げた
    [MainBoard_V3_2.kicad_pcb, MainBoard_V3_2.kicad_sch, bom.csv, designators.csv, positions.csv]
2026-07-20 ティアドロップ追加
    [MainBoard_V3_2.kicad_pcb, positions.csv]
2026-07-20 fableに聞いて修正（コンデンサ追加など）
    [MainBoard_V3_2.kicad_pcb, MainBoard_V3_2.kicad_sch, bom.csv, designators.csv, positions.csv]
2026-07-30 bom追加
2026-08-03 1からプログラムを書き直す
2026-08-03 Add ADC DMA, Ultrasonic, Encoder, and Power modules with lighting control
    - Introduced adc_dma.h for non-blocking ADC reading using DMA.
    - Added ultrasonic.h for ultrasonic distance measurement with trigger and echo handling.
    - Implemented encoder.h for reading wheel angles and angular velocities.
    - Created power.h for monitoring voltage, current, and temperature using ADC.
    - Integrated lighting control with advanced winker functionality in lighting.c and lighting.h.
    - Updated app.c to initialize and manage new modules, including ADC, ultrasonic sensors, and lighting.
    - Added necessary callback functions for handling ultrasonic echo interrupts.
2026-08-03 feat: Implement BLDC motor control and power management features
    - Added BLDC motor communication and control logic in `bldc_motor.c` and `bldc_motor.h`.
    - Integrated motors control for steering and rear wheels in `motors.c` and `motors.h`.
    - Implemented steering calibration and angle control in `steering.c` and `steering.h`.
    - Introduced power management functionalities in `power.c` and `power.h`, including voltage and current monitoring.
    - Updated application setup to initialize new serial communications for motors and power management.
    - Enhanced lighting control with adjustable winker timing in `lighting.c` and `lighting.h`.
    - Modified DMA configurations in `MainF446RE_V3.ioc` to accommo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
2026-08-03 Add drive control and IMU sensing modules
    - Implemented drive control logic in drive.h and drive.c for torque control of rear motors, including speed control and traction control parameters.
    - Added IMU sensing functionality in imu.h and imu.c, utilizing MPU6050 for attitude estimation and acceleration data.
    - Established calibration routines for the IMU, including flash storage for calibration data.
    - Integrated low-pass filtering for acceleration data and implemented bias tracking for gyro readings.
    - Ensured data readiness through interrupt handling and recovery mechanisms for I2C communication.
2026-08-04 feat: Enhance power management and fault detection mechanisms
2026-08-06 Add CRC-8 implementation and enhance drive control logic
    - Introduced a new CRC-8 implementation in crc8.h for data integrity checks.
    - Updated app.c to include a breathing LED indication for power status, improving user feedback on system health.
    - Refactored drive.c to enhance vehicle speed estimation and control logic, including torque distribution and traction control.
    - Improved motor and steering control functions for better performance and reliability.
    - Added necessary constants and definitions for torque limits and vehicle dynamics.
2026-08-08 Refactor drive, steering, and encoder modules; add lidar support
    - Updated vehicle speed estimation in drive.c to use road wheel angle.
    - Introduced front wheel speed variables in Drive structure for better speed reporting.
    - Enhanced steering module with road wheel angle functions and center calibration validation.
    - Adjusted torque limits in steering and drive parameters for improved control.
    - Implemented encoder accumulation for accurate distance tracking in encoder.c.
    - Added lidar module for point cloud processing, including sector management and point placement.
    - Increased lighting duty cycle for better visibility.
    - Modified power module thresholds for overcurrent protection.
2026-08-09 feat: Update UART protocol to v0.5 with new commands and braking control
    - Updated `COMMAND` packet length from 10 to 12 bytes, adding `brake_torque` for specifying braking strength in N·m.
    - Expanded `flags` to include new `light_mode` (2 bits) and `passing` (1 bit) for headlight control.
    - Changed horn behavior to a continuous tone while pressed, instead of a single beep.
    - Implemented braking control that bypasses speed PI loop, allowing direct torque application.
    - Introduced `ApplyFailsafe()` to handle emergency stops and command timeouts, ensuring maximum braking torque is applied.
    - Updated lighting control to manage headlight modes and passing functionality without affecting tail li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
2026-08-09 feat: Add external interrupt configurations for lidar and echo pins
2026-08-09 fix: Correct direction definitions for front wheels and standardize pointer formatting in encoder module
    [drive.h, encoder.h]
2026-08-09 Refactor telemetry and vehicle control modules
    - Introduced a new telemetry module to handle communication of various sensor data to the Raspberry Pi, including motor status, vehicle speed, and sensor readings.
    - Added functions for initializing and updating telemetry data, ensuring timely communication with the upper-level system.
    - Implemented a vehicle control module to manage commands from the Raspberry Pi, including emergency stop handling and fail-safe mechanisms.
    - Updated steering control parameters to limit steering angle to ±45 degrees and adjusted torque limits accordingly.
    - Created an indicator module for visual feedback on vehicle status, including power and fault indications.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
    [app.c, app.h, indicator.c, indicator.h, steering.h, telemetry.c, telemetry.h, vehicle.c]
2026-08-10 feat: Implement LiDAR power management with idle delay in vehicle module
2026-08-10 feat: Implement torque vectoring control and update related components
    - Added torque vectoring functionality to enhance vehicle handling by adjusting the torque distribution between the rear wheels based on steering angle and vehicle speed.
    - Updated the drive control logic to integrate torque vectoring, including new functions for initialization, updating, and reporting applied torque differences.
    - Modified telemetry to include torque vectoring status in the communication flags.
    - Adjusted steering parameters to accommodate a wider steering angle range.
    - Enhanced documentation to reflect changes in torque vectoring implementation and its interaction with existing control systems.
2026-08-10 Refactor ultrasonic sensor handling to use a new range sensor module
    - Removed ultrasonic sensor instances and initialization from app.c.
    - Introduced a new RangeSensor structure to encapsulate front and rear ultrasonic sensors.
    - Updated Setup function to initialize the RangeSensor with appropriate GPIO pins.
    - Modified HAL_GPIO_EXTI_Callback to handle echo edges through the new RangeSensor API.
    - Replaced ultrasonic distance retrieval in Telemetry with filtered distance from RangeSensor.
    - Created range_sensor.c and range_sensor.h to manage sensor updates and filtering logic.
    - Adjusted telemetry structure to reference the new RangeSensor instead of individual ultrasonic sensors.
    - Updated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
    [app.c, drive.h, range_sensor.c, range_sensor.h, telemetry.c, telemetry.h]
2026-08-10 feat: Add direct torque command mode and update protocol to v0.6
2026-08-11 fix: Adjust drive control parameters for improved performance and update horn frequency
    [drive.h, vehicle.h]
2026-08-11 feat: Implement auto-stop functionality using ultrasonic sensors and update related protocols to v0.7
    - Added auto-stop feature that engages maximum braking torque when obstacles are detected within 20cm using front and rear ultrasonic sensors.
    - Updated vehicle control logic to incorporate auto-stop activation based on command flags.
    - Enhanced telemetry to report the active status of the auto-stop feature.
    - Modified UART protocol documentation to reflect changes in command and telemetry flags for version 0.7.
    - Updated lighting system to support brake light flashing during emergency stops.
    - Refactored vehicle initialization to include range sensor dependency.
2026-08-17 feat: Enhance buzzer functionality with GPIO management for shared access with Raspberry Pi
    [app.c]
2026-08-21 feat: Enhance telemetry fault logging and drive control mechanisms
    - Added LogNewFaults function to notify new faults via RasLink_Log in telemetry.c, ensuring timely fault reporting.
    - Introduced logged_faults in telemetry.h to track previously logged faults.
    - Updated Telemetry_Update to call LogNewFaults, reducing polling frequency impact on fault detection.
    - Implemented wheel lift guard in drive.c to manage torque limits based on wheel speed anomalies, enhancing traction control.
    - Added functions to enable/disable traction control and wheel lift guard in drive.h.
    - Modified IsAutoStopObstacleAhead to use actual vehicle speed for obstacle detection, improving safety during maneuvers.
    - E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
2026-08-24 feat: Enhance BLDC motor control with data validity checks and reset functionality
    [app.c, motors.c, motors.h, steering.c, telemetry.c]
2026-08-25 feat: Correct polarity inversion for left rear motor current sensor in telemetry update
    [telemetry.c]
2026-08-25 feat: Enhance auto-stop functionality with dynamic distance calculation and LiDAR integration
    - Updated auto-stop logic to use dynamic stopping distance based on vehicle speed and a configurable safety margin.
    - Introduced new parameter `auto_stop_margin_cm` to allow runtime adjustment of the safety margin via `CONFIG_SET`/`CONFIG_GET`.
    - Refactored `IsAutoStopObstacleAhead` to incorporate LiDAR data for obstacle detection, improving reliability in various conditions.
    - Added `Lidar_QueryRoi` function to query LiDAR data within a specified angle and distance.
    - Updated vehicle initialization to include LiDAR and modified telemetry to support new features.
    - Revised documentation to reflect c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
2026-08-28 feat: Update UART protocol to v0.13 with telemetry and command enhancements
    - Added new fields to TELEMETRY (0x03) for slip ratio and torque limit, increasing payload length from 66 to 74 bytes.
    - Introduced flags2 in COMMAND (0x10) for side brake functionality, increasing payload length from 14 to 15 bytes.
    - Updated protocol version from 0x000C to 0x000D.
    - Implemented side brake logic in drive control, allowing for mechanical locking of rear motors based on command flags.
    - Enhanced telemetry updates to include slip and torque limit values for traction control tuning.
    - Adjusted traction control parameters and added debounce logic for slip detection.
    - Updated vehicle command handling to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
    [drive.c, drive.h, ras_link.c, ras_link.h, telemetry.c, vehicle.c]
2026-09-12 fix: Setup()でLiDAR給電を行いLD06に電力を供給する
2026-09-12 fix: 舵角指令をarmedでガードし未較正中心点での走行を防ぐ
2026-09-12 fix: BLDC指令値のNaN/範囲外を飽和させ未定義動作を防ぐ
2026-09-12 fix: TCのスリップ判定を空転方向のみに限定する
2026-09-12 fix: TVへの適用済みトルク差報告を最終クランプ後の値で行う
2026-09-12 fix: LiDAR未受信セクタをfreshと誤判定しないようにする
2026-09-12 fix: 自動停止の前後判定に応答の速い車速を使う
2026-09-12 fix: ウィンカーduty基準をブレーキ点滅の瞬時値から切り離す
2026-09-12 fix: Clampfで±Infinityを符号に応じて振り分ける
2026-09-12 fix: LiDAR圧縮フォーマットの距離量子化を四捨五入にする
2026-09-12 fix: LPF_Initでcurrent_valも初期化し未初期化読み出しを防ぐ
2026-09-12 fix: AHRS積分フィードバックに飽和上限を設ける
2026-09-12 fix: Setup直後のブロッキング処理によるシリアルオーバーラン誤検知を防ぐ
2026-09-12 fix: Flash読み書きの端数バイトでバッファ境界を超えないようにする
2026-09-12 docs: Flashセクタ全消去の注意点をコメントで明記する
2026-09-12 fix: 較正モードのLED2表示がボタン1単独で消える不具合を修正
2026-09-12 fix: TCのスリップ検出継続時間にホールドダウンを追加する
2026-09-12 fix: Atan2でy==0の特別扱いを追加しNaNを防ぐ
2026-09-12 fix: Sin/Cosの角度切り捨てを四捨五入に変更する
2026-09-12 fix: Wait/WaitMsのuint32_tオーバーフローを分割呼び出しで防ぐ
2026-09-12 fix: Buzzer SetToneの高周波数指定時のarrアンダーフローを防ぐ
2026-09-12 fix: PwmOut_WriteでNaN dutyを0として扱いUBを防ぐ
2026-09-12 fix: Ultrasonicのタイムアウト処理をISRに対して排他にする
2026-09-12 fix: LD06パケット探索で点数検証失敗バイトをヘッダ候補として再評価する
2026-09-12 fix: Watchdog_Startのタイムアウトクランプを呼び出し側へ伝える
2026-09-12 fix: LiDAR給電はSetup()で行わずlidar_onの初期値をfalseに訂正
    Setup()時点でLIDAR_POWERを投入しないのが正しい仕様(実機確認済み)だった。
    真の不具合はVehicle_Init()がlidar_on=trueで初期化していたため、
    UpdateLidarPower()が初回ARM時にもPower_SetLidarPower()を呼ばず
    LiDARが永久に無給電のままになる点だった。
    [app.c, lidar.h, vehicle.c]
2026-09-12 docs: LiDAR給電がSetup()ではなくARM時である旨にCLAUDE.mdを訂正
2026-09-12 fix: TCスリップ率を進行方向で正規化し後退中の空転誤検知漏れを修正
    前回の符号付き判定化(Abs除去)により、後退中は空転が代数的に負スリップとして
    現れるため誤って無視される回帰を生んでいた。片輪浮き対策と同じ手法で
    reference方向に正規化し、前進・後退どちらでも正=空転の意味を保つ。
    [drive.c]
2026-09-12 fix: シリアルオーバーラン対策の誤った修正を取り消す
    Serial_Read()のrxOverrun処理は「ブロッキング中に溜まった古いバッファ内容を
    読み捨てて最新位置へ追いつく」既存の自己修復動作であり、Setup()完了直後に
    明示リセットするとこの追いつき処理が働かず、古い(既に上書きされ得る)内容から
    読み進めてしまう回帰になっていた。Serial_ResetOverrunTimer()呼び出しと
    定義を削除し、Serial_Available()のコメントを実際の設計意図に合わせて修正。
    [app.c]
2026-09-12 docs: AHRS積分クランプ値が未実測プレースホルダーであることを明記
2026-09-25 feat: ADCをDMA循環バッファで平均化し前輪速度LPFとTCデバウンスを軽量化
2026-09-27 feat: USART1を1Mbpsへ高速化しテレメトリ周期短縮とシリアル受信の不具合を修正
2026-09-27 feat: 全体のボーレートを250000bpsから1000000bpsに変更し、通信遅延を改善
2026-09-28 feat: ブレーキランプの緊急制動点滅を実車ESSと同じ車速・減速度判定に変更
2026-09-28 feat: ABSを追加しTCを滑り始めのトルク基準の方式へ改修、TVの規範舵角と横加速度上限を実測値に更新
2026-10-02 fix: 修正機体座標系の変換と姿勢の符号反転に関するコメントを更新
2026-10-03 feat: 省電力化のための制御系の改善とブレーキ灯の減光機能を追加
2026-10-05 build: 最適化を-O2にしFPU直接展開と暗黙double昇格の警告を有効化
2026-10-05 feat: LiDARのビン中心角度での距離を前後2点の線形補間で求める
2026-10-05 feat: TC/ABS/TVを連続PIへ見直し調整パラメータを上位から実行時に設定可能に (v0.16)
2026-10-06 feat: 低電圧警告機能を追加し、インジケータ初期化にブザーとミュートボタンを追加
2026-10-09 feat: TVを荷重比例の配分へ置き換え (v0.17)、ステアのリンク換算を追加し舵角を実際の路面舵角に (v0.18)
2026-10-09 feat: Add frequency sweep functionality to buzzer and enhance vehicle braking light logic
    [indicator.c, power.c, vehicle.c, vehicle.h]
2026-10-09 「止める」の意味を上位・MDと揃える(v0.19): 惰行はトルク0を送る、ARMが外れても停車まで制動、MDの健全性監視と起動待ち、ステア未較正のガード、フェイルセーフの位置保持、IMU復旧の非ブロッキング化、ジャイロのレンジ拡大
2026-10-09 ブレーキホールドを追加: 制動して止まったら後輪の位置保持へ移る(フェイルセーフ以外の制動にも拡張)、param_id 0x0090でON/OFF
2026-10-10 ローンチコントロールを追加(v0.20): 上位が要求した発進で目標車速のランプと車速PIを迂回し全開+TCで加速、flags2 bit3・flags bit24・param_id 0x00A1
2026-10-11 docsとCLAUDE.mdを整理: 過去の資料をdocs/archiveへ移し、CLAUDE.mdを現行の要点に絞る
2026-10-11 v0.22のコード変更とコメント整理: 版数・日付・経緯の記述を削り、docsの参照先を更新
2026-10-13 feat: Update protocol version to v0.23 and enhance timer functionality for improved cycle accuracy
2026-10-14 E-Stop・通信途絶の後はARMを一度下ろすまで走らない、IMU割り込みでI2C BUSY待ちに入らない、ブレーキ解除後に目標車速を0から数え直さない、MD異常のデバウンス、自動停止の保持、IWDG復帰の短縮、エンコーダ左右の定義を実態に合わせて明記
2026-10-14 自動停止の判定を車幅の矩形へ、ハートビート未検出・自動停止センサ不在をTELEMETRYで通知、steer_link_cubicの丸めをACKに反映し走行中は保留、受信パーサの再走査、printfを非ブロッキングに、フェイルセーフ停車30秒で駆動電源を切る、ジャイロ学習は停車中のみ、IMU初期化の再試行、車速射影をcosf/sinfに
2026-10-15 README を追加
    Claude-Session: https://claude.ai/code/session_01PkD8iTKKu9igwcmQmQVTDi
2026-10-15 送信フレームのSEQをDMA起動の直前に振る（優先度順の送信で正常時もreorderedが増えていた）
2026-10-17 車速を走行距離＋加速度計のカルマンフィルタにし、一貫性の診断・前輪の絶対角・停止からの復帰を追加、Encoderのdt誤りとFlash_ReadDataのエイリアシングを修正（プロトコル v0.26）
2026-10-17 自動停止・DISARM制動・各輪LPF・加速度FFの定数を車体寸法と同定値の式に置き換え
    Claude-Session: https://claude.ai/code/session_0184yPFrGfwCwPBHnGTZddZb
2026-10-18 前輪エンコーダの校正・前後輪の転がり半径・車速KFの調整値をCONFIG_SETの実行時パラメータに（プロトコル v0.27、既定値は従来と同じ動き）
    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
2026-10-18 車輪の半径は実測値のままとし、転がり半径の実行時パラメータを取り除く
    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
2026-10-19 ホストの車両モデルに前輪エンコーダの校正前の生の角度と各輪の走行距離の出力を追加（HOST_SIM_ABI 9）
    上位の同定 (tools/calib/encoder.py) が校正の当てはまりを確かめられるよう、TELEMETRY の
    front_angle・odom_dist に相当する値をホスト側でも出せるようにする。真のエンコーダ特性
    (左右別の lo/hi・1次と2次の周期誤差・ADC ノイズ) を reserved bit3 で与える経路も足す。
2026-10-19 ジャイロ z 軸の感度の補正をCONFIG_SETの実行時パラメータに（プロトコル v0.28、既定値は補正なし）
    MPU6050 の感度はデータシートの値のままで公差が ±3% あり、ヨーレート・曲率・向きの積分の
    倍率にそのまま乗る。imu_gyro_z_scale (0x00F1、0.9〜1.1) を上位が送るようにし、imu.c が
    バイアスを引いた後・AHRS の前に z の角速度へ掛ける。バイアスの学習は補正前の値のまま。
    ホストの差し替えヘッダは真のヨーレートを直接入れるので何もしない。
2026-10-19 制動の減速度とMDのトルクの遅れをCONFIG_SETの実行時パラメータに（プロトコル v0.29）
    どちらも上位の校正の結果で、校正し直すたびにファームへ写しを直して書き込む二重管理に
    なっていた。brake_decel_m_s2 (0x0101、0.5〜10) と md_torque_lag_s (0x0102、0〜0.1) を
    上位が送るようにし、vehicle.h の VEHICLE_BRAKE_DECEL_M_S2・VEHICLE_MD_TORQUE_TAU_S を
    消す。使い道は変わらない (自動停止の停止距離と、ARM が外れたときの制動の上限。
    後者は vehicle.c の DisarmBrakeTimeoutS へ移動)。仮置きは範囲の下限で、上位が全項目を
    送って CONFIG_ACK で確かめ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
2026-10-19 CLAUDE.md の現在の状態を v0.29 に更新（v0.28 書き込み済み・v0.29 は未書き込み）
    プロトコル版と差分文書の範囲を v0.29 にし、v0.28 (ジャイロ z 軸の感度の補正) の
    書き込み状況と v0.29 の内容を追記。v0.27 の値の出どころは上位の改名に合わせて
    tools/calib/encoder.py・kf.py に直す。
2026-10-31 車速KFのゲートが続いたら走行距離から測り直し、ありえない車速では初期化する
2026-10-31 後輪1輪のトルク上限を MD 再校正後の 0.15N·m にする
2026-10-31 前輪エンコーダの読みの鏡像を後輪と車速の推定で直し、直したら LOG で知らせる
2026-11-01 前進中の車速PIの減速トルクにも TC ではなく ABS を掛ける
2026-11-01 TELEMETRY の前輪の走行距離を鏡像と折り返しを直した増分から積む
2026-11-01 VERSION にビルド時刻を入れ、起動時の LOG に git のコミットを出す
2026-11-01 CLAUDE.md の現在の状態に会場の試走の対処を追記する
2026-11-01 git のコミットが変わっただけでもビルドの識別を作り直す
2026-11-01 CLAUDE.md の現在の状態を会場の試走の対処の書き込み済みに更新する
2026-11-01 コメント・docs・CLAUDE.md の古い記述をコードに合わせて整理する
2026-11-01 温度センサの ADC サンプリングを 480cycle に延ばし、DMA の窓を 10 スキャンにする
2026-11-01 自動停止の LiDAR 判定を舵角から出した予想進路で見るようにする
2026-11-02 自動停止の LiDAR 判定から車体の外形の内側の点を除く
    予想進路は車体の真横も含むので、車体に立てた支柱・部品に当たった LiDAR の点で
    自動停止が誤って作動していた。外形（VEHICLE_BODY_FRONT_X_M / REAR_X_M /
    HALF_WIDTH_M）の内側の点は「障害物はあり得ない」として数えない。
    判定は auto_stop_path.c の AutoStopPath_IsInsideBody に置き、上位のシムと
    総当たりで突き合わせられるようにする。
2026-11-09 ホストシミュレータの後輪タイヤを合成スリップ（前後力と横力の配分）にする
2026-11-09 過速度ガードを指令上限の1割上に分離し、上限ちょうどの指令で正トルクが入切しないようにする
2026-11-09 TC のスリップ制限を止めない PI (TractionLimiter) にして入り切りの繰り返しを防ぐ
2026-11-09 文書とコメントを整理し、delta 文書を archive へ移して削除済みツールへの参照を直す
2026-11-09 技術解説サイトの URL を新しいサイトに更新する
2026-11-12 ウィンカー点滅モードを追加
