banbatakumi/AutonomousCar/(notices)

Notices in the files:
Program/MainF446RE_V3/Core/Inc/main.h:
Copyright (c) 2025 STMicroelectronics.
All rights reserved.
This software is licensed under terms that can be found in the LICENSE file
